aravinth41/AMT/AMT MAGNETOMETER/03_Documents/Lumax_Air gap and Working area_D4.8H3 x-y plane .pptx

- Japan, India Regional Marketing Manager
- Takumi Yoshiya

## Slide 2

Magnet and working area

Condition : 20mT < √(Bx^2+By^2) < 70mT
24mT < Bz < 126mT

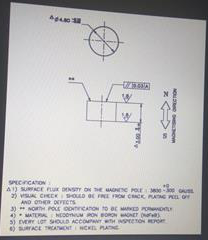
[picture p5: figure]

Working Area(x-y plane)

3.0mm

Magnet

z

4.8mm

y

2.5 ~ 3.0mm

10mmφ

x

## Slide 3

Thank you very much
