aravinth41/AMT/AMT HALL EFFECT/05_Documents/AMT_PCB_26 Jul 2019.pptx

AMT

## POSITIONS IN PCB

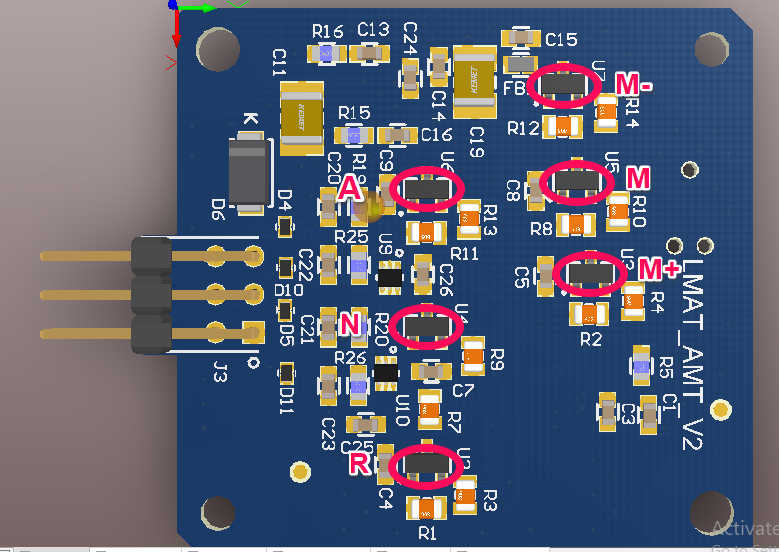
[picture p6: figure]

## CONNECTOR CONNECTIONS

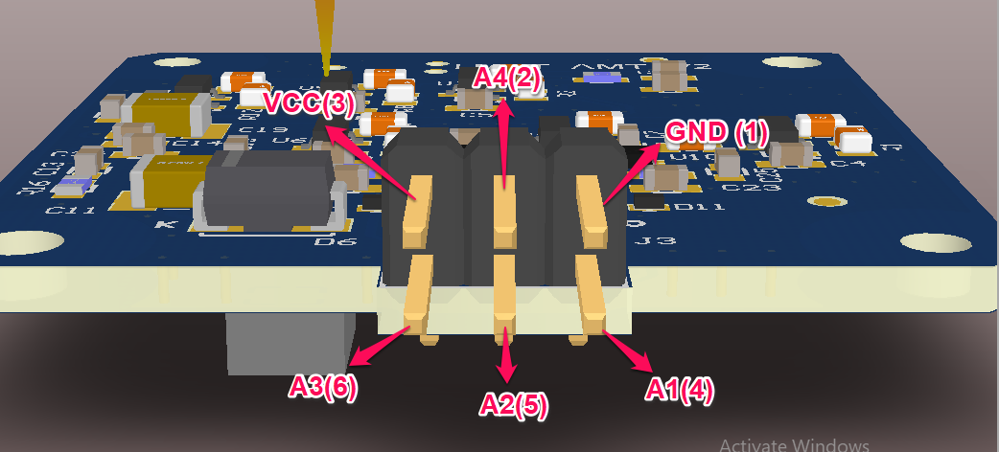
[picture p7: figure]

## Slide 4

THANK YOU
