aravinth41/AMT/AMT HALL EFFECT/05_Documents/AMT_PCB_12 Jul 2019.pptx

AMT

## POSITIONS IN PCB

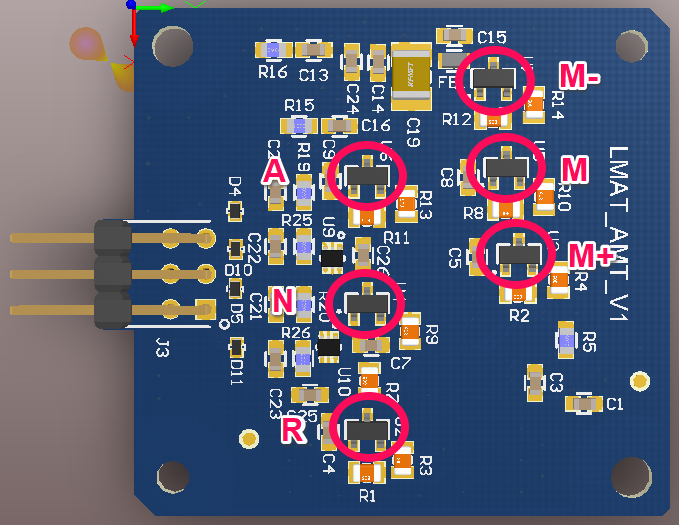
[picture p8: figure]

## CONNECTOR CONNECTIONS

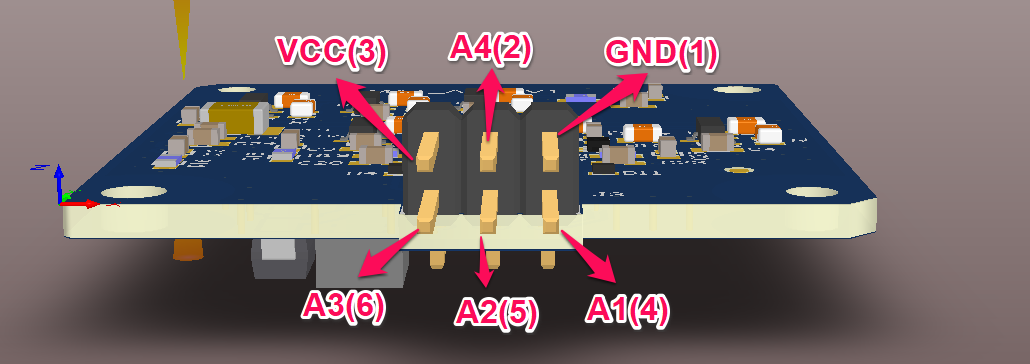
[picture p9: figure]

## Slide 4

THANK YOU
