aravinth41/AMT/AMT HALL EFFECT/05_Documents/AMT_PCB_09 Jul 2019.pptx

AMT

## POSITIONS IN PCB

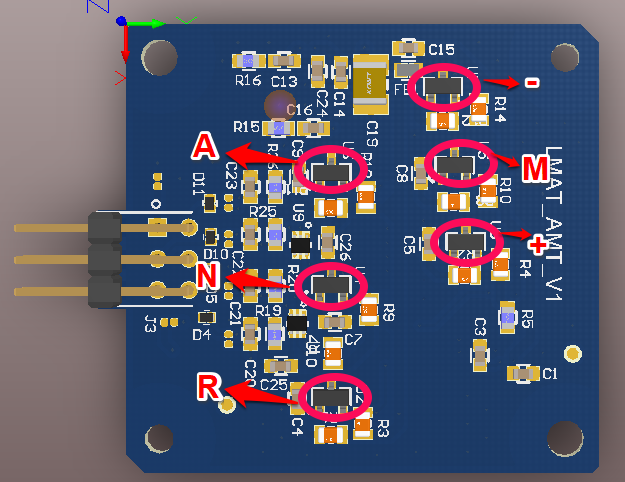
[picture p10: figure]

## PROPOSED CONNECTOR CONNECTIONS

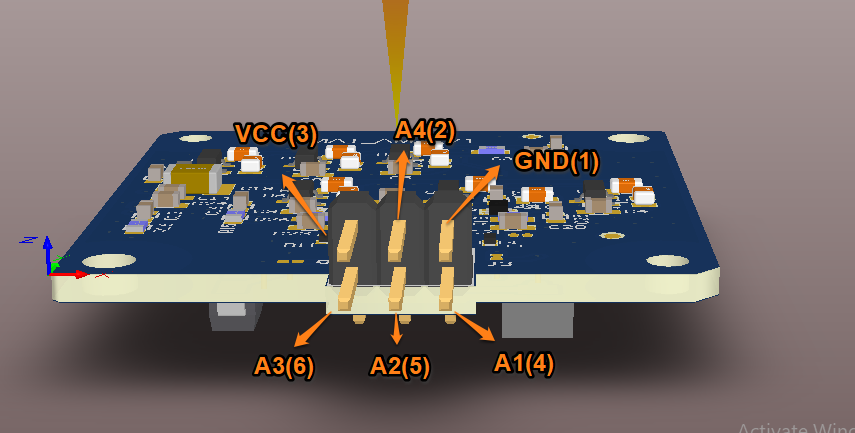
[picture p11: figure]

## CONNECTOR OPEN

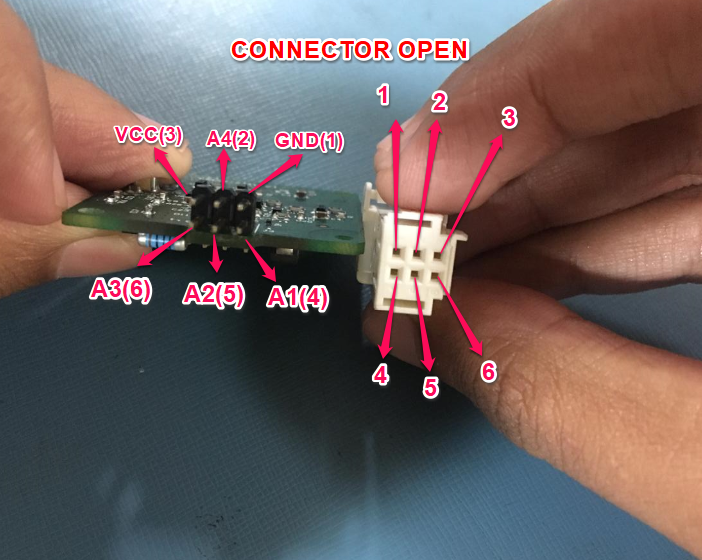
[picture p12: figure]

## CONNECTOR CLOSED

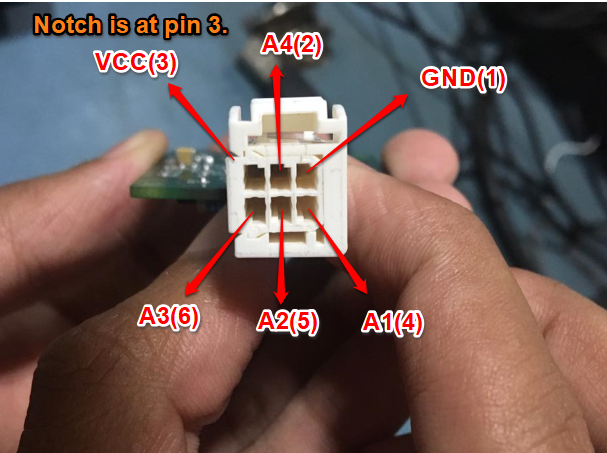
[picture p13: figure]

## Slide 6

THANK YOU
