aravinth41/AMT/AMT HALL EFFECT/05_Documents/AMT_Presentation.pptx

AMT PROJECT

## Slide 2

Proposal 1: Hall Effect sensor

H6

R

MCU

LOGIC
CIRCUITRY

Protection circuitry

Switching
Regulator
(12V to 5V)

A1

CONNECTOR

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
Note: H* are hall effect sensors.

## Hall Effect sensor based AMT

- In this method, we will be using 6 hall effect sensors to determine the positions of gear lever.
- The outputs of hall effect sensors are given to Microcontroller. Based on the inputs received from hall effect sensor, the desired output will be obtained.
- To obtain the desired logic levels at the output, logic circuitry is added.

## Slide 4

Proposal 2: Magnetometer

Magnetometer
M1

R

MCU

LOGIC
CIRCUITRY

Protection circuitry

Switching
Regulator
(12V to 5V)

A1

CONNECTOR

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
## Magnetometer based AMT

- In this project, we will be using 3D magnetometer to determine the positions of the gear lever.
- Magnetometer communicates with microcontroller using SPI protocol.
- Magnetometer sends different data at each position. Based on the data received, the microcontroller will be programmed to give the desired output.
- To obtain the desired logic levels at the output, logic circuitry is added.

## Comparison between HES and Magnetometer

HALL EFFECT SENSOR | MAGNETOMETER
Six Hall effect sensors are used to determine the positions of gear lever. | One magnetometer is enough to determine the positions of gear lever.
Calibration is not required | Calibration is required
Cost of HES PCBA is less compared to MAGNETOMETER PACBA | Cost of magnetometer PCBA is more compared to HES PCBA. (Unit price of sensor is around $5 even if we are going to procure 10000MOQs)

## Slide 7

Thank You
