aravinth41/AMT/AMT HALL EFFECT/01_Project Inputs/Tataside/Hornbill_AMT_shifter_details.pdf

## Hornbill AMT shifter

## New bezel for Hornbill

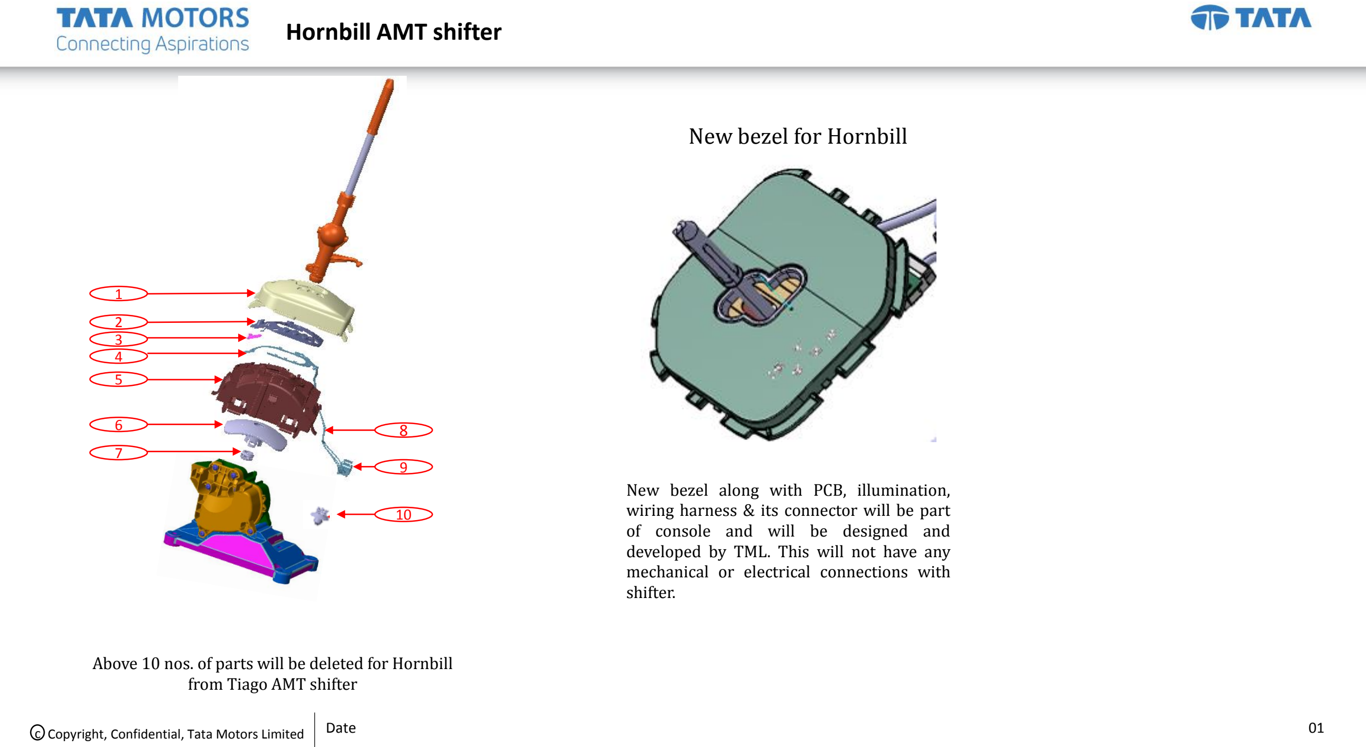
[picture p23: page 1]

c Copyright, Confidential, Tata Motors Limited | Date | 01

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
Above 10 nos. of parts will be deleted for Hornbill from Tiago AMT shifter

New bezel along with PCB, illumination, wiring harness & its connector will be part of console and will be designed and developed by TML. This will not have any mechanical or electrical connections with shifter.
