aravinth41/AMT/AMT HALL EFFECT/01_Project Inputs/LumaxSide/Photos/12.jpg

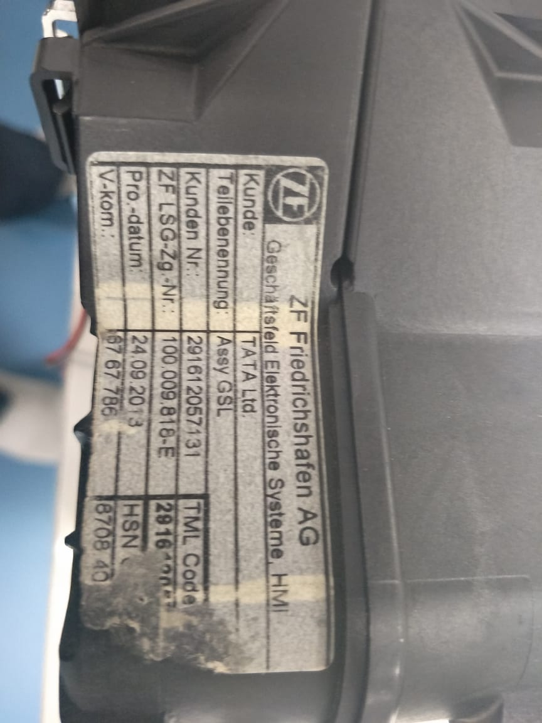
AMT HALL EFFECT/01_Project Inputs/LumaxSide/Photos/12.jpg
