aravinth41/AMT/AMT HALL EFFECT/01_Project Inputs/LumaxSide/Photos/Magnet poles.png

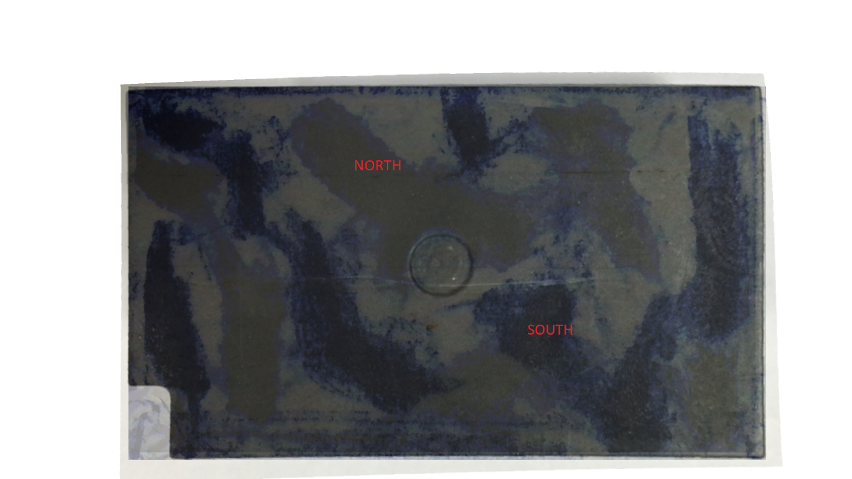
AMT HALL EFFECT/01_Project Inputs/LumaxSide/Photos/Magnet poles.png
