aravinth41/AMT/AMT HALL EFFECT/01_Project Inputs/LumaxSide/BOM_X451.xlsx

BOM FOR SUPPLYING PARTS TO TATA
SUPPLIER NAME : |  | LUMAX MANNOH ALLIED TECHNOLOGIES LTD. |  | CUSTOMER NAME : |  | TATA MOTORS |  |  | PART NAME : |  | LEVER ASSY, SELECT |  | ISSUED DATE : | 08.02.19
SUPPLIER CODE : |  |  |  | CUSTOMER PART NO. : |  | SEE TABLE |  |  | PART NO. : |  |  |  | REV. DATE. : | 15.02.19
VOLUME : |  |  |  | MODEL : |  | X451 |  |  | QUANTITY PER VEHICLE : |  | -01- |  | REV. NO. :
SL. No. | PART NAME /CHILD PART | LMAT PART NO. | TATA PART NO. | PHOTOS | MATERIAL | WEIGHT | QTY. | R/M SOURCE | SUPPLIER | SUPPLY CONDITION PART NAME | SUPPLY CONDITION PART NO. | SUPPLY CONDITION PART PHOTO | REMARKS | CHANGE POINTS
1 | BRACKET, BASE ASSY |  |  |  | TPC+PA66-GF30
1.1 | BRACKET, BASE |  |  |  | PA66-GF30 | 280 | 1 |  |  |  |  |  | MOULDING
1.2 | TOP TPC MOULDING |  |  |  | TPC | 6 | 1 |  |  |  |  |  | MOULDING
1.3 | SIDE TPC MOULDING |  |  |  | TPC | 2 | 1 |  |  |  |  |  | MOULDING
2 | LEVER ROD ASSY_SELECT |  |  |  | PA66-GF30+STKM13C | 55+143 | 1 |  |  |  |  |  | 6 POSITION
2.1 | LEVER MOULDED |  |  |  | PA66-GF30 | 55 | 1 |  |  |  |  |  | 6 POSITION
2.2 | PIPE, LEVER |  |  |  | STKM13C | 143 | 1 |  |  |  |  |  | ID-11, OD-15, L-186 SLOT 4.85x26 & 5.35x26.5 TO BE MACHINED Ø4 DRILLING AT ONE PLACE M4 TAPPING AT TWO PLACES
2.3 | CROSS JOINT |  |  |  | PA66-GF30 | 10 | 1 |  |  |  |  |  | MOULDING
3 | ROD A , LOCK PIN |  |  |  | PA66-GF30 | 12+16 | 1 |  |  |  |  |  | INSERT MOULDING WITH ITEN No. : 3.1
3.1 | ROD B , LOCK PIN |  |  |  | S15C OR SS400 | 16 | 1 |  |  |  |  |  | COMMON WITH W112
4 | SPRING , LOCK PIN |  |  |  | SWPA | 2 | 1 |  |  |  |  |  | NEW
5 | PIN , LOCK |  |  |  | SCM40 | 8 | 1 |  |  |  |  |  | NEW
6 | FIXATION SHAFT |  |  |  | AISI1541 (GR-109T) | 60 | 1 |  |  |  |  |  | COLD FORGING
7 | FIXATION SHAFT_PIVOT |  |  |  | AISI1541 (GR-109T) | 25 | 1 |  |  |  |  |  | COLD FORGING
8 | PUSH NUT Ø8 mm |  |  |  |  | 6 | 2 |  |  |  |  |  | NEW
9 | ROD, DETENT |  |  |  | EN8 (HV650~850) | 6.5 | 2 |  |  |  |  |  | NEW
10 | SPG,COMPRESSION_DETENT |  |  |  | SWPA |  | 1 |  |  |  |  |  | CNC COILNG
11 | SWITCH, TRANSMISSION CONTROL ASSY |  |  |  |  |  | 1 |  |  |  |  |  | NEW
12 | BUSH |  |  |  | CRCA SHEET (THK-1MM) | 5 | 7 |  |  |  |  |  | COMMON WITH W112
13 | SWITCH ASSY., SHIFT LOCK |  |  |  |  |  | 1 |  |  |  |  |  | NEW SWITCH WITH 2Amp OMRON-D2HWC261H
14 | SOLENOID ASSY, SHIFT LOCK |  |  |  |  | 110 | 1 |  |  |  |  |  | NEW
15 | DETENT |  |  |  | PA66, GF30 | 27 | 1 |  |  |  |  |  | NEW
16 | FIXATION SHAFT DETENT |  |  |  | SAE1010 | 10 | 1 |  |  |  |  |  | NEW
17 | NUT, PUSH |  |  |  | SPRING STEEL HARDNESS -42~50HRC | 0.5 | 1 |  |  |  |  |  | COMMON WITH W112
18 | ADAPTER |  |  |  | PA6, GF30 | 350 | 1
19 | NYLOC NUT M8 |  |  |  | AISI 1010 (GR-10T) |  | 3
20 | BOOT ASSY.
20.1 | LEATHER A |  |  |  | SYLPHY (t=0.85~0.9) KOYVA LEATHER | 13
20.2 | LEATHER B |  |  |  | SYLPHY (t=0.85~0.9) KOYVA LEATHER | 13
20.3 | THREAD A
20.4 | THREAD B
20.5 | RETAINER |  |  |  | PP | 18
21 | MAIN PCB ASSY DESCREAT/MICROCONTROLLER |  |  |  |  | 25 |  |  |  |  |  |  | FOR PRND POSITION WITH 8 SENSORS 8MAGNET
22 | PCB ILLUMINATION LED |  |  |  |  | 15 |  |  |  |  |  |  | FOR BEZZLE ILLUMINATION
23 | CONNECTOR MAIN PCB |  |  |  |  |  |  |  |  |  |  |  | 8 PIN CONNECTOR
24 | CONNECTOR ILLU PCB |  |  |  |  |  |  |  |  |  |  |  | 3 PIN
25 | MUL TEMP D |  |  |  |  | 5
26 | MUL TEMP AC-D |  |  |  |  | 5
27 | AUTOLEX-TSK2520G-A-AP01 |  |  |  |  | 2
PREPARED BY: |  |  |  | CHECKED BY: |  |  |  |  | CHECKED BY (PURCHASE): |  |  | CHECKED BY (QUALITY):
APPROVED BY (R&D) : |  |  |  |  |  |  |  |  | APPROVED BY (PLANT HEAD) :
1.THIS IS CONCEPT LEVEL BOM ONLY
1.THIS MAY CHANGE IN FINAL DESIGN
