aravinth41/AMT/AMT HALL EFFECT/05_Documents/FMEA/IFRL_AMT.xlsx

ITEM FUNCTION REQUIREMENT LIST (IFRL)
SUPPLIER NAME : |  | LUMAX MANNOH ALLIED TECHNOLOGIES LTD. |  | CUSTOMER NAME : |  | TATA MOTORS |  |  | DATE : |  | 2019-10-09
SUPPLIER CODE : |  |  |  | PART NAME : |  | SHIFTLEVER MECHANISM |  |  | REV. NO. : |  | 0
 |  |  |  | MODEL : |  | NEXON |  |  | QUANTITY PER VEHICLE : |  | -01-
ITEM | FUNCTION |  | PRIMARY / SECONDARY | CATEGORY | REQUIREMENTS |  | POTENTIAL FAILURE MODE
 |  |  |  |  | HOW MUCH? | WHEN? | NO FUNCTION | UNDER FUNCTION | OVER FUNCTION | INTERMITTENT FUNCTION | DEGRADED FUNCTION | UNINTENDED FUNCTION
1 | Power supply |  |  |  |  |  |  |  |  |  |  |  | Reliability | Reliability
1.1 | To provide the power supply to GSL |  | GENERAL | Power supply | Required voltage: 5V (DC) | Operating voltage: 8 - 16V | Detection of lever position won't happen and desired output will not be obatined. | MCU and HES won't operate if the required voltage goes below 3V. Due to this, GSL doesn't operate and desired output signal cannot be obtained. | MCU gets damaged above 5.5V. Due to this, desired output signal cannot be obtained. | N/A | N/A | N/A
2 | FUNCTIONALITY |  |  |  |  |  |  |  |  |  |  |  | Fluid Retention | NVH
2.1 | To detect the lever position (HES). |  | GENERAL | Communication between MCU and HES. | MCU should detect active low input signal whenever the gear is moved from one position to another. | After Buck conversion and magnet placement above sensor at 1.5mm. | GSL cannot detect the gear positions and achieve the desired output cannot be obtained as per RFQ. | Chances of both HES getting low is possible which may gives as error state when the magnet is placed below 1mm. | HES cannot detect the lever position if the magnet is placed above 2mm from the body of HES. | N/A | Magnet looses its properties over the time and it leads to inoperation of GSL. | N/A | Ergonomics
2.2 | Logic circuitry |  | GENERAL | Logic function | To obtain the required output voltage range as per the EE requirement. | MCU should give desired logic and the output should be connected to TCU with pull up value of 600ohms. | Output voltage cannot be obtained as per EE spec after connecting to TCU. | Due to this, GSL operate at low voltage(3V) and desired output signal cannot be obtained. | MCU gets damaged above 5.5V. Due to this, desired output signal cannot be obtained. | N/A | N/A | When the TCU pull up resistor value changes, the output voltage levels cannot be obtained | Appearance
