aravinth41/AMT/AMT HALL EFFECT/07_TestReport/Rev 3/LMAT_AMT_V3_Test_Report.xlsx

Sheet: Cover page
HARDWARE TEST REPORT
Project Name |  |  | AMT
Device Under Test
Sl. No.
Document Title |  |  | Hardware Test Report
Document No.
Document Revision Number |  |  | Rev 3.0
Execution Summary Page
 | Name of HW Team Members involved in Verification - with responsibilities
S.No | Name |  |  | Responsibility
1 | K.Harshavardhan |  |  | Hardware
2
3
Document Revision History
Rev No. | Date of Issue | Author | Approved by |  | Scope

Sheet: Execution summary
 | Go to Cover page
Link to pages
V.1 | Visualization test | It is first step of Hardware testing.
 |  | Intially it should be cleaned properly with IPA to avoid all the unwanted dust on the board.
 |  | It is follwed by our clear sight on Board to find out the the visible problems, issues or mismatch of com[ponents.
 |  | The procedures are explained in Visualization test page
T.1 | Isolation test | It is Second step of Hardware testing.
 |  | This is used to find the Short circuit in the circuit.
 |  | The procedures are explained in Isolation test page
T.2 | Power test | It is third step of Hardware testing.
 |  | This is used to check the voltage levels
 |  | The procedures are explained in power test page
T.3 | Functionality Test | It is the fourth step of Hardware testing.
 |  | This is used to ensure that the required voltages are obtained by placing the magnet near the Hall effect sensor .
 |  | This step is done once the firmware is updated to Microcontroller.
 | Resource Requirements | The required equipments are listed in this Page

Sheet: Visualization Test
Visulalization Test
Test ID | Test procedure | Test Condition | Observation |  |  |  |  | Result | Remarks on the cause for the failure | Workaround if any done in HW/SW for the same | Failure type | Severity
V.1 |  |  | Sl. No. 1 | Sl. No. 2 | Sl. No. 3 | Sl. No. 4 | Sl. No. 5
V.1.1 | Clean the board and check the visual look on soldering of components | - | Okay | Okay | Okay | Okay | Okay | Pass
V.1.2 | Checking of all Components Placed | Except - C20, C21, C22, C23, C24, FB2, FB7, R30 | Okay | Okay | Okay | Okay | Okay | Pass
V.1.3 | Check the Orientation of IC | From U1 to U10 | Okay | Okay | Okay | Okay | Okay | Pass
V.1.4 | Check the polarity of Diode | D1, D2, D3, D8, D9, D6 | Okay | Okay | Okay | Okay | Okay | Pass

Sheet: Isolation test
Test ID | Test | Sample terminal to test | Test Condition | Observation |  |  |  |  | Pass Criteria | Result | Remarks on the cause for the failure | Workaround if any done in HW/SW for the same | Failure type | Severity
T.1 | ISOLATION |  | Power supply should be in off condition & Multimeter should be in Short test mode. | Sl. No. 1 | Sl. No. 2 | Sl. No. 3 | Sl. No. 4 | Sl. No. 5
T.1.2.1 | VCC | Across C17, C27 |  | Okay | Okay | Okay | Okay | Okay | No short | Pass
T.1.2.2 | VCC_IN | Across C18, C28 |  | Okay | Okay | Okay | Okay | Okay | No short | Pass
T.1.2.3 | VCC_5V | Across C15 |  | Okay | Okay | Okay | Okay | Okay | No short | Pass

Sheet: Power test
Test ID | Test | DESCRIPTION | CONDITION | Sample terminal to test | Test Condition | Observation |  |  |  |  | Pass Criteria | Unit | Result | Remarks on the cause for the failure | Workaround if any done in HW/SW for the same | Failure type | Severity
T.2 | Power |  |  |  |  | Sl. No. 1 | Sl. No. 2 | Sl. No. 3 | Sl. No. 4 | Sl. No. 5
T.2.1 | VCC | To measure power supply | Input power supply is required for the board. Check w.r.t to GND | Across C17, C27 | DC Voltage | 13.39 | 13.39 | 13.39 | 13.4 | 13.4 | To obtain 13.5V | V | Pass
T.2.2 | VCC_IN | To measure power supply | Input power supply is required for the board. Check w.r.t to GND. | Across C18, C28 | DC Voltage | 13.39 | 13.39 | 13.39 | 13.4 | 13.4 | To obtain 13.5V | V | Pass
T.2.3 | VCC_5V | To measure power supply | Input power supply is required for the board. Check w.r.t to GND. | Across C15 | DC Voltage | 5.006 | 4.971 | 4.992 | 4.998 | 4.982 | To obtain 5V | V | Pass

Sheet: Functionality Test
 |  |  | Functionality test
 |  | Desired Truth Table |  |  |  |  |  | Desired Voltage levels
Sl No | Position | A1 | A2 | A3 | A4 |  | Sl No | Logic | Output voltage (V)
 |  |  |  |  |  |  |  |  | Min | Nom | Max
1 | R (U2) | 1 | 0 | 0 | 1 |  | 1 | 0 | 1.5 | 1.88 | 2.25
2 | N (U4) | 1 | 1 | 0 | 0 |  | 2 | 1 | 3.2 | 3.65 | 4.1
3 | A (U6) | 0 | 1 | 1 | 0
4 | M+ (U3) | 0 | 0 | 1 | 1
5 | M (U5) | 1 | 1 | 1 | 1
6 | M- (U7) | 0 | 1 | 0 | 1
Board Number | Magnet position | Voltage levels (V) |  |  |  | Pass Criteria | Result
 |  | A1 | A2 | A3 | A4
1 | R (U2) | 3.517 | 1.992 | 1.992 | 3.512 | To satisfy truth table 1 and 2. (TCU AT 5V) | Pass
 | N (U4) | 3.516 | 3.515 | 1.991 | 1.992 |  | Pass
 | A (U6) | 1.998 | 3.515 | 3.511 | 1.992 |  | Pass
 | M+ (U3) | 1.997 | 1.992 | 3.511 | 3.511 |  | Pass
 | M (U5) | 3.516 | 3.514 | 3.512 | 3.512 |  | Pass
 | M- (U7) | 1.997 | 3.516 | 1.991 | 3.512 |  | Pass
2 | R (U2) | 3.492 | 1.986 | 1.995 | 3.491 | To satisfy truth table 1 and 2. (TCU AT 5V) | Pass
 | N (U4) | 3.493 | 3.49 | 1.996 | 1.989 |  | Pass
 | A (U6) | 1.99 | 3.491 | 3.496 | 1.99 |  | Pass
 | M+ (U3) | 1.99 | 1.986 | 3.497 | 3.494 |  | Pass
 | M (U5) | 3.493 | 3.491 | 3.497 | 3.493 |  | Pass
 | M- (U7) | 1.991 | 3.493 | 1.996 | 3.495 |  | Pass
3 | R (U2) | 3.509 | 1.989 | 1.999 | 3.512 | To satisfy truth table 1 and 2. (TCU AT 5V) | Pass
 | N (U4) | 3.508 | 3.506 | 1.998 | 1.997 |  | Pass
 | A (U6) | 1.996 | 3.505 | 3.51 | 1.998 |  | Pass
 | M+ (U3) | 1.996 | 1.989 | 3.51 | 3.511 |  | Pass
 | M (U5) | 3.509 | 3.506 | 3.51 | 3.512 |  | Pass
 | M- (U7) | 1.996 | 3.507 | 2 | 3.514 |  | Pass
4 | R (U2) | 3.507 | 1.99 | 1.998 | 3.508 | To satisfy truth table 1 and 2. (TCU AT 5V) | Pass
 | N (U4) | 3.508 | 3.506 | 1.999 | 1.993 |  | Pass
 | A (U6) | 1.992 | 3.505 | 3.508 | 1.993 |  | Pass
 | M+ (U3) | 1.992 | 1.99 | 3.511 | 3.51 |  | Pass
 | M (U5) | 3.508 | 3.506 | 3.51 | 3.511 |  | Pass
 | M- (U7) | 1.992 | 3.507 | 2 | 3.512 |  | Pass
5 | R (U2) | 3.498 | 1.989 | 1.996 | 3.506 | To satisfy truth table 1 and 2. (TCU AT 5V) | Pass
 | N (U4) | 3.499 | 3.502 | 1.996 | 1.996 |  | Pass
 | A (U6) | 1.994 | 3.501 | 3.505 | 1.995 |  | Pass
 | M+ (U3) | 1.993 | 1.989 | 3.504 | 3.507 |  | Pass
 | M (U5) | 3.497 | 3.501 | 3.503 | 3.506 |  | Pass
 | M- (U7) | 1.994 | 3.502 | 1.996 | 3.507 |  | Pass

Sheet: Resource _Requirements
 |  | Quantity
Description/Name | Type of Resoure | Workbench Resource | Availability Status | Remark
Digital Multimeter (DMM) | Hardware
Variable DC Power supply (PSU) Atleast 0-12V, 10A | Hardware
Magnet | Hardware
