aravinth41/AMT/AMT HALL EFFECT/06_Stock/LMAT_AMT_V2_Stock.xlsx

Designator | Description | Manufacturer | Manufacturer Part Number | Value | Vendor Name | Vendor Part Number | Quantity | Stock available |  | To Be ordered
R6 | RES SMD 0.0OHM JUMPER 1/10W 0603 | Panasonic Electronic Components | ERJ-3GEY0R00V | 0R | Digi-Key | P0.0GCT-ND | 1 | 15 | 10 | -5
C13 | CAP CER 0.022UF 50V 10% X7R 0603 | TDK Corporation | CGA3E2X7R1H223K080AA | 0.022uF | Digi-Key | 445-5663-1-ND | 1 | 12 | 10 | -2
C4, C5, C7, C8, C9, C10 | CAP CER 0.047UF 50V X7R 0603 | TDK Corporation | CGA3E2X7R1H473K080AA | 0.047µF | Digi-Key | 445-5664-1-ND | 6 | 88 | 60 | -28
C6, C12, C25, C26 | CAP CER 0.1UF 50V 10% X7R 0603 | TDK Corporation | CGA3E2X7R1H104K080AA | 0.1uF | Digi-Key | 445-5666-1-ND | 4 | 50 | 40 | -10
C14, C16 | CAP CER 0.22UF 50V X7R 0603 | Murata Electronics North America | GCJ188R71H224KA01D | 0.22µF | Digi-Key | 490-14410-1-ND | 2 | 38 | 20 | -18
R15 | RES SMD 1M OHM 5% 1/10W 0603 | Vishay Dale | RCA06031M00JNEA | 1M | Digi-Key | 541-2216-1-ND | 1 | 12 | 10 | -2
C2, C3 | CAP CER 1UF 25V X7R 0603 | TDK Corporation | CGA3E1X7R1E105K080AE | 1µF | Digi-Key | 445-173628-1-ND | 2 | 30 | 20 | -10
R3, R4, R9, R10, R13, R14 | RES SMD 1.2K OHM 5% 1/2W 0805 | Panasonic Electronic Components | ERJ-P06J122V | 1.2K | Digi-Key | P1.2KADCT-ND | 6 | 15 | 60 | 45
R29 | RES SMD 4.7K OHM 1% 1/10W 0402 | Panasonic Electronic Components | ERJ-2RKF4701X | 4.7K | Digi-Key | P4.70KLCT-ND | 1 | 0 | 10 | 10
R27, R28 | RES SMD 10K OHM 5% 1/10W 0402 | Panasonic Electronic Components | ERJ-2GEJ103X | 10K | Digi-Key | P10KJCT-ND | 2 | 0 | 20 | 20
C11 | CAP CER 10UF 50V X7R 1210 | Taiyo Yuden | UMJ325KB7106KMHP | 10uF | Digi-Key | 587-6026-1-ND | 1 | 0 | 10 | 10
R16 | RES SMD 22K OHM 1% 1/10W 0603 | Panasonic Electronic Components | ERJ-3EKF2202V | 22K | Digi-Key | P22.0KHCT-ND | 1 | 6 | 10 | 4
R5 | RES SMD 47K OHM 1% 1/10W 0603 | Yageo | AT0603FRE0747KL | 47K | Digi-Key | YAG2129CT-ND | 1 | 25 | 10 | -15
C19 | CAP CER 47UF 16V X6S 1210 | Murata Electronics North America | GRT32EC81C476KE13L | 47uF | Digi-Key | 490-12494-1-ND | 1 | 15 | 10 | -5
L1 | FIXED IND 47UH 700MA 422.5 MOHM | Taiyo Yuden | NRS5030T470MMGJV | 47UH | Digi-Key | 587-3604-1-ND | 1 | 0 | 10 | 10
R1, R2, R7, R8, R11, R12 | RES SMD 100 OHM 1% 1/2W 0805 | Panasonic Electronic Components | ERJ-P06F1000V | 100R | Digi-Key | P16057CT-ND | 6 | 10 | 60 | 50
R17, R18, R23, R24 | RES SMD 105 OHM 1% 1/10W 0603 | Panasonic Electronic Components | ERJ-3EKF1050V | 105 Ohms | Digi-Key | P105HCT-ND | 4 | 60 | 40 | -20
R19, R20, R25, R26 | RES SMD 210 OHM 1% 1/10W 0603 | Panasonic Electronic Components | ERJ-3EKF2100V | 210 Ohms | Digi-Key | P210HCT-ND | 4 | 60 | 40 | -20
FB1 | FERRITE BEAD 600 OHM 0603 1LN | Murata Electronics North America | BLM18KG601SH1D | BLM18KG601SH1D | Digi-Key | 490-13259-1-ND | 1 | 14 | 10 | -4
J3 | CONN HEADER R/A 6POS 2.54MM | Harwin Inc. | M20-9950345 | M20-9950345 | Digi-Key | 952-2092-ND | 1 | 12 | 10 | -2
U9, U10 | MOSFET 2P-CH 20V 0.55A SOT666 | Nexperia USA Inc. | PMDT670UPE,115 | PMDT670UPE,115 | Digi-Key | 1727-1334-1-ND | 2 | 25 | 20 | -5
D2, D3, D8, D9 | Diode Schottky 30V 100mA Surface Mount EMD2 | Rohm Semiconductor | RB501SM-30FHT2R | RB501SM-30FHT2R | Digi-Key | RB501SM-30FHT2RCT-ND | 4 | 40 | 40 | 0
D6 | DIODE GEN PURP 1KV 1A DO214AC | Vishay Semiconductor Diodes Division | S1MHE3_A/I | S1MHE3_A/I | Digi-Key | S1MHE3_A/IGICT-ND | 1 | 13 | 10 | -3
D7 | TVS DIODE 23.1V 48.3V SMB | STMicroelectronics | SM6T27CAY | SM6T27CAY | Digi-Key | 497-10798-1-ND | 1 | 14 | 10 | -4
D1 | DIODE SCHOTTKY 40V 1A DO-219AB | Vishay Semiconductor Diodes Division | SS1FL4HM3/H | SS1FL4HM3/H | Digi-Key | SS1FL4HM3/HGICT-ND | 1 | 11 | 10 | -1
U1 | IC MCU 8BIT 8KB FLASH 20TSSOP | STMicroelectronics | STM8AF6223PCU | STM8AF6223PCU | Digi-Key | 497-17896-ND | 1 | 13 | 10 | -3
D4, D5, D10, D11 | TVS DIODE 8V 20V 2X2DFN | ON Semiconductor | SZESD7410N2T5G | SZESD7410N2T5G | Digi-Key | SZESD7410N2T5GOSCT-ND | 4 | 48 | 40 | -8
U8 | IC REG BUCK 5V 1.8A 8DSO | Infineon Technologies | TLE8366EV50XUMA1 | TLE8366EV50XUMA1 | Digi-Key | TLE8366EV50XUMA1CT-ND | 1 | 10 | 10 | 0
U2, U3, U4, U5, U6, U7 | MAGNETIC SWITCH UNIPOLAR SOT23-3 | Infineon Technologies | TLE49641MXTSA1 | TLE49641MXTSA1 | Digi-Key | TLE49641MXTSA1CT-ND | 6 | 0 | 60 | 60
 |  | DNP COMPONENTS
C1, C15, C18 | CAP CER 0.1UF 50V 10% X7R 0603 | TDK Corporation | CGA3E2X7R1H104K080AA | DNP | Digi-Key | 445-5666-1-ND | 3 |  | 30
C20, C21, C22, C23 | CAP CER 10000PF 50V X8R 0603 | TDK Corporation | CGA3E2X8R1H103K080AA | DNP | Digi-Key | 445-5892-1-ND | 4 |  | 40
C24 | CAP CER 0.022UF 50V 10% X7R 0603 | TDK Corporation | CGA3E2X7R1H223K080AA | DNP | Digi-Key | 445-5663-1-ND | 1 |  | 10
D12, D13, D14, D15 | TVS DIODE 8V 20V 2X2DFN | ON Semiconductor | SZESD7410N2T5G | DNP | Digi-Key | SZESD7410N2T5GOSCT-ND | 4 |  | 40
R30 | RES SMD 4.7K OHM 1% 1/10W 0402 | Panasonic Electronic Components | ERJ-2RKF4701X | DNP | Digi-Key | P4.70KLCT-ND | 1 |  | 10
