aravinth41/AMT/AMT HALL EFFECT/01_Project Inputs/LumaxSide/CDS TATA AMT Original.xlsx

Sheet: Summary
 | Format No. 2922 11 326 A0076- Rev C
 | Component Device Specification (CDS) template
 | Summary:
 | -
1 | Change History | s2
2 | Component Device Specification Status (CDS Status) | s3
3 | Component Device Specification (CDS) | s4

Sheet: Change History
Back to summary
Format No. 2922 11 326 A0076 Rev- C
Component Device Specification - Change History Log
Issue number | Description of change | Date of change | Changed by

Sheet: CDS Status
Back to summary
Format No. 2922 11 326 A0076 - Rev C
Component Device Specification Status (EXAMPLE)
Project Code: | TML PART NO XXXXXXXXXXX
System | Component | Owner | email | CDS Received complete?

Sheet: Component Device Specification
 | Back to summary
 | Format No. 2922 11 326 A0076 Rev-C
 | Component Device Specification (CDS)
 | Component Name: | Connector GSL and Bezzel |  |  |  |  |  |  | Department | Electronics |  | Supplier | LUMAX
 | Part Number | Molex Part No.- 982980002/987871018 |  |  |  |  |  |  | Component owner |  |  | Contact
 | Issue level |  |  |  |  |  |  |  | Phone details |  |  | Phone details
 | System | TATA AMT |  |  |  |  |  |  | email address |  |  | email address
 | STOP! Does the component have a fly lead? If yes, please consider in device Input/Output resistances.
 | STOP! Does the signal is shared with other ECU? If yes, please provide the internal schematic of that pin (upto Micro) to study the H/W interface. Architecture team will notice the shared signals in DFD release.
 | Electrical I/O Matrix
Latest by when the information is required as per EE Technical release gates? | By TG2 | By TG2 | By TG0-2 | By TG0-2 | By TG0-2 | By TG0-2 | By TG2 | By TG2 | By TG0-2 | By TG0-2 | By TG0-2 | By TG0-2 | By TG0-2 | By TG0-2 | By TG0-2 | By TG0-2 | By TG0-2 | By TG0-2 | By TG0-2 | By TG2 | By TG2 | By TG2 | By TG2 | By TG2 | By TG2 | By TG2 | By TG2 | By TG2 | By TG0-2 | By TG2 | By TG2 | By TG2 | By TG2
 | Connector Number | Pin number | Signal Name | Signal Description | Signal type (Select from drop down) | Active Level (Select from options) | Pull up Type (Please specify, see example below) | Pull Down (pl. specify resistance value) | Signal destination (Select from below or provide) | Power supply requirement (Select from below or provide) | Ground Type (Select from below) | Shield or twist requirement | Identify shield or Twisting Grouping (Make groups of different shielded or twisted wires and provide group numbers) | Minimum voltage required at the pin-out of the aggregate to meet all functional requirements | Maximum voltage required at the pin-out to meet all the functional requirements | Nominal operating Current (A) at Voltage (V) | Nominal operating Voltage (V) at Current (A) | Max operating Current (A) at Voltage (V) | Max operating Voltage (V) at Current (A) | Inrush Current (A) at Voltage (V) | Inrush Voltage (V) at Current (A) | Inrush Time (t) at Current (A) and Voltage (V) | Stall Current (A) at Voltage (V) | Stall Voltage (V) at Current (A) | Stall Time (t) at Current (A) and Voltage (V) | Nominal operating Duration (t) | Maximum operating duration (t) | Recommended Wire CSA (sq mm) on wiring harness side | Does the component have a permanent Battery Feed? | If Yes, state the nominal quiescent drain current in its sleep state. | Is there a Pigtail (fly lead) present? | Pigtail (Fly lead) CSA | Pigtail (Fly lead) length
 |  |  |  |  | Analog | High/Low | 12V:Batt | Resistance Value | +VCC / -VCC / Component and I/O | BATT / ACC / IGN / ST / Internal to ECU | General / Dedicated | Shield / Twist | Group number | V | V | A | V | A | V | A | V | t (sec) | A | V | t (sec) | t (sec) | t (sec) | (mm2) | Y/N | mA | Y/N | mm2 | mm
 | MOLEX- 98298-0002 GSL Connector | 1 | Ground | From TCU to GSL PCB | Power | High | 12V:Batt | NA | -VBAT | BATT | General | N/A | N/A | GND | GND | 30mA/6V | 6V/30mA | 52mA/16V | 16/52mA | N/A | N/A | N/A | N/A | N/A | N/A | N/A | N/A | N/A | N/A | N/A | N/A | N/A | N/A
 |  | 2 | Signal 1 | From GSL to TCU | Analog | Analog Voltage | 5V:Internal | NA | GSL Output | TCU | N/A | N/A | N/A | 5V | 5V | 30mA/6V | 6V/30mA | 52mA/16V | 16/52mA | N/A | N/A | N/A | N/A | N/A | N/A | N/A | N/A | N/A | N/A | N/A | N/A | N/A | N/A
 |  | 3 | +V | From TCU to GSL PCB | Power | High | 12V:Batt | NA | +VBAT | BATT | N/A | N/A | N/A | 8V | 16V | 30mA/6V | 6V/30mA | 52mA/16V | 16/52mA | N/A | N/A | N/A | N/A | N/A | N/A | N/A | N/A | N/A | N/A | N/A | N/A | N/A | N/A
 |  | 4 | Signal 2 | From GSL to TCU | Analog | Analog Voltage | 5V:Internal | NA | GSL Output | TCU | N/A | N/A | N/A | 5V | 5V | 30mA/6V | 6V/30mA | 52mA/16V | 16/52mA | N/A | N/A | N/A | N/A | N/A | N/A | N/A | N/A | N/A | N/A | N/A | N/A | N/A | N/A
 |  | 5 | Signal 3 | From GSL to TCU | Analog | Analog Voltage | 5V:Internal | NA | GSL Output | TCU | N/A | N/A | N/A | 5V | 5V | 30mA/6V | 6V/30mA | 52mA/16V | 16/52mA | N/A | N/A | N/A | N/A | N/A | N/A | N/A | N/A | N/A | N/A | N/A | N/A | N/A | N/A
 |  | 6 | Signal 4 | From GSL to TCU | Analog | Analog Voltage | 5V:Internal | NA | GSL Output | TCU | N/A | N/A | N/A | 5V | 5V | 30mA/6V | 6V/30mA | 52mA/16V | 16/52mA | N/A | N/A | N/A | N/A | N/A | N/A | N/A | N/A | N/A | N/A | N/A | N/A | N/A | N/A
 |  |  |  |  |  |  |  |  |  |  |  |  |  |  |  |  |  |  |  |  |  |  |  |  |  |  |  |  |  |  |  | - | -
 | 98787-1018 Bezzel Connector | 1 | Not Used | N/A | N/A | N/A | N/A | N/A | N/A | N/A | N/A | N/A | N/A | N/A | N/A | N/A | N/A | N/A | N/A | N/A | N/A | N/A | N/A | N/A | N/A | N/A | N/A | N/A | N/A | N/A | N/A | N/A | N/A
 |  | 2 | Not Used | N/A | N/A | N/A | N/A | N/A | N/A | N/A | N/A | N/A | N/A | N/A | N/A | N/A | N/A | N/A | N/A | N/A | N/A | N/A | N/A | N/A | N/A | N/A | N/A | N/A | N/A | N/A | N/A | N/A | N/A
 |  | 3 | +V | TCU To GSL | Digital | High | 12V:Batt | N/A | GSL Input | BATT | N/A | N/A | N/A | 8V | 16V | N/A | N/A | N/A | N/A | N/A | N/A | N/A | N/A | N/A | N/A | N/A | N/A | N/A | N/A | N/A | N/A | N/A | N/A
 |  | 4 | Gnd | TCU to GSL | Digital | Low | 12V:Batt | N/A | GSL Input | BATT | General | N/A | N/A | 8V | 16V | N/A | N/A | N/A | N/A | N/A | N/A | N/A | N/A | N/A | N/A | N/A | N/A | N/A | N/A | N/A | N/A | N/A | N/A
 |  | 5 | Output Sports Mode | GSL to TCU | Digital | Low | Gnd | N/A | GSL Output | Internal | N/A | N/A | N/A | 8V | 16V | N/A | N/A | N/A | N/A | N/A | N/A | N/A | N/A | N/A | N/A | N/A | N/A | N/A | N/A | N/A | N/A | N/A | N/A
 |  | 6 | Not Used | N/A | N/A | N/A | N/A | N/A | N/A | N/A | N/A | N/A | N/A | N/A | N/A | N/A | N/A | N/A | N/A | N/A | N/A | N/A | N/A | N/A | N/A | N/A | N/A | N/A | N/A | N/A | N/A | N/A | N/A
 | Pin Number | Terminal Plating | Signal Name
 |  | 5
 | 1 | Ground | From TCU to GSL PCB | Power | High | 12V:Batt | 12V:Batt | NA
 | 2 | Signal 1 | From GSL to TCU | Analog | Analog Voltage | 5V:Internal | 5V:Internal | NA
 | 3 | +V | From TCU to GSL PCB | Power | High | 12V:Batt | 12V:Batt | NA
 | 4 | Signal 2 | From GSL to TCU | Analog | Analog Voltage | 5V:Internal | 5V:Internal | NA
 | 5 | Signal 3 | From GSL to TCU | Analog | Analog Voltage | 5V:Internal | 5V:Internal | NA
 | 6 | Signal 4 | From GSL to TCU | Analog | Analog Voltage | 5V:Internal | 5V:Internal | NA
 | 1 | Not Used | N/A | N/A | N/A | N/A | N/A | N/A
 | 2 | Not Used | N/A | N/A | N/A | N/A | N/A | N/A
 | 3 | +V | TCU To GSL | Digital | High | 12V:Batt | 12V:Batt | N/A
 | 4 | Gnd | TCU to GSL | Digital | Low | 12V:Batt | 12V:Batt | N/A
 | 5 | Output Sports Mode | GSL to TCU | Digital | Low | Gnd | Gnd | N/A
 | 6 | Not Used | N/A | N/A | N/A | N/A | N/A | N/A
 | Harness Connector | Information Required by TG2
 | Connector - TATA Part Number: |  |  |  |  |  |  |  | Connector end view - showing the cable entry pin-out
 | Connector - Supplier Part Number:
 | Pin Number | Terminal Plating | Signal Name
 | TG0-2 | Information to be filled before supplier finalization
 | TG2 | Information to be filled after supplier finalization
