aravinth41/AMT/AMT HALL EFFECT/01_Project Inputs/LumaxSide/PCB AMT 27 APR 2019.dxf

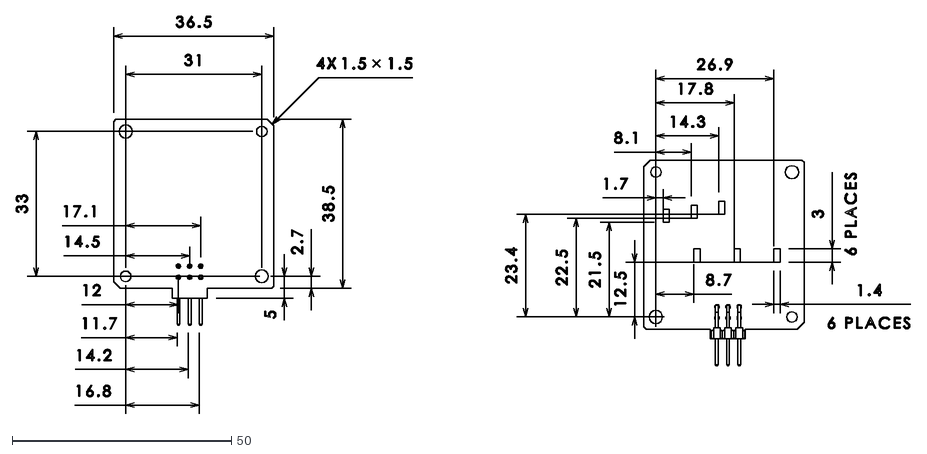
[picture p35: CAD file, 2019-06-26]
AMT HALL EFFECT/01_Project Inputs/LumaxSide/PCB AMT 27 APR 2019.dxf
203.9 x 90.7
