aravinth41/AMT/AMT HALL EFFECT/01_Project Inputs/LumaxSide/AMT_PCB_25 JUNE 2019.dxf

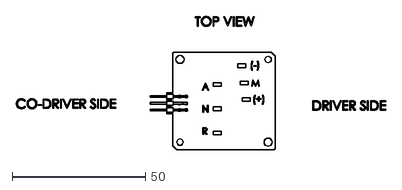
[picture p36: CAD file, 2019-06-25]
AMT HALL EFFECT/01_Project Inputs/LumaxSide/AMT_PCB_25 JUNE 2019.dxf
138.3 x 49.9
