aravinth41/AMT/AMT HALL EFFECT/04_Project Outputs/Rev 1/04_3D Model/AMT_HALL_EFFECT.step

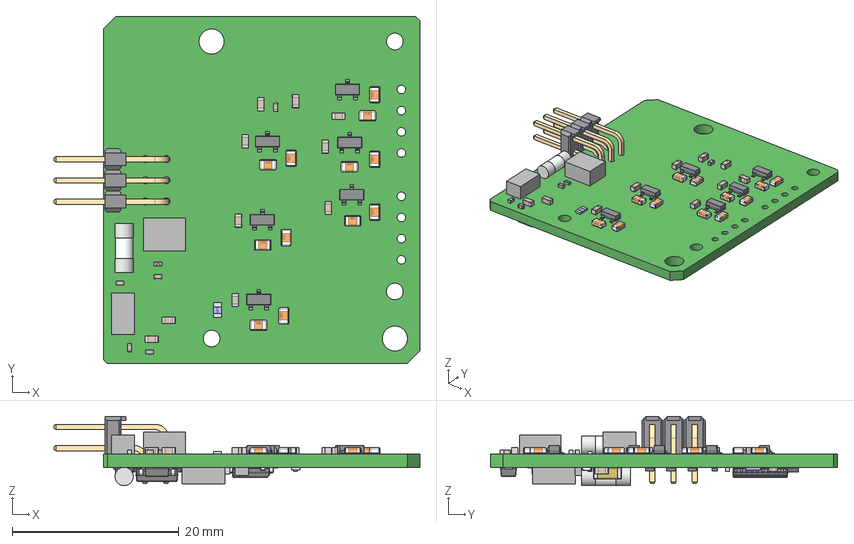
[picture p37: CAD file, 2019-06-26, an earlier design]
AMT HALL EFFECT/04_Project Outputs/Rev 1/04_3D Model/AMT_HALL_EFFECT.step
43.9 x 41.7 x 8.32 mm
Board
bigPin x 8
SOT666_Lower_mold_body x 2
SOT666_LF x 2
SOT666_upper_mold_body x 2
Extruded x 4
User_Library-RESC1005X04N x 10
User_Library-SMD_CAPACITOR0402 x 11
Open_CASCADE_STEP_translator_6.8_2.1
Open_CASCADE_STEP_translator_6.8_2.2.1
Leader x 28
Open_CASCADE_STEP_translator_6.8_10.1
Open_CASCADE_STEP_translator_6.8_10.2.1
User_Library-SOD-523F x 4
Open_CASCADE_STEP_translator_6.8_6.1.1
lead x 2
C0603 x 11
SW3dPS-3-lead_sot23-3 x 6
M20-995-MOULD
M20-995-PIN1 x 3
M20-995-PIN2 x 3
