aravinth41/AMT/AMT HALL EFFECT/05_Documents/FMEA/BOUNDARY_DIAGRAM_AMT.xlsx

Sheet: BD_AMT
BOUNDARY DIAGRAM - TATA AMT NEXON | Prepared By | Ekta Bhayana
 | Date | 2019-10-09
 | Arrow | Interface
 |  | Power line
 |  | Data transfer
 |  | Physical Interface and External input
 |  | FMEA Boundary
 |  | Magnet

Sheet: BD_AMT_2
 |  |  |  |  | BOUNDARY DIAGRAM - TATA AMT NEXON |  |  |  | Prepared By | Ekta Bhayana
 |  |  |  |  |  |  |  |  | Date | 2019-10-09
 |  |  |  |  |  | Arrow | Interface
 |  |  |  |  |  |  | Power line | Note: All interfaces mentioned in Tabular column are One way interaction.
 |  |  |  |  |  |  | Data transfer
 |  |  |  |  |  |  | Physical Interface and External input
 |  |  |  |  |  |  | FMEA Boundary
 |  |  |  |  |  |  | Magnet
INTERACTIONS
Physical |  | Energy |  | Information |  | Material
MT | Tape Application | A | Acceleration | Bt | Bluetooth | Ar | Air
BlJt | Ball Joint | Af | Adhesion force | CmP | Cam Position | Bm | Belt Material
BoJt | Banjo Joint | Bo | Buoyancy | CAN | CAN Signal | Bg | Blow-by gas
Br | Bearing | Cq | Charge | CrP | Crank Position | Bf | Brake Fluid
Be | Belted | Cf | Compression Force | DI | Digital input | Ca | Charged Air
B | Bolted | Ef | Electric Field | Ifr | Information | Clt | Coolant
BhJt | Bush Joint | I | Electrical Current | Ir | Infrared | D | Dust
BuCl | Button Clip | E | EMI - EMC | P | Pulse | Eo | Engine Oil
C | As Cast | F | Force | Rf | Radio Frequency Signal | Eg | Exhaust Gas
Ch | chained | Fr | Friction | Ss | Sensor Signal | Fe | Fuel
Cl | Clamped | H | Heat | Sg | Signal | Fv | Fuel Vapour
Clr | Clearance | Ld | Load | FbS | Feed back sound | Gs | Gas
ClJt | Clip Joint | Mf | Magnetic Field | N | Noise | Glc | Glide coating
CdFt | Cold fitting | Mn | Moment |  |  | Grs | Grease
Co | Coupling | Pr | Pressure |  |  | Lo | Lub Oil
Cr | Crimped | PrD | Pressure Drop |  |  | Mst | Moisture
Dw | Doweled | Tre | Retained torque |  |  | O | Oil
En | Engagement | Ero | Rotational Energy |  |  | Ov | Oil Vapour
Fc | Face Contact | Sp | Spark |  |  | RTP | RPM And TDC Position
FJt | Ferrul Joint | T | Temperature |  |  | Slt | Salt
Wf | Friction Welded | Tn | Tension |  |  | Sl | Sealant
Gm | Gear Meshing | ThS | Thermal Shock |  |  | Wt | Water
Gp | Gear Pairing | Tr | Torque |  |  | Wr | Wear
Gl | Glued | Vm | Vacuum
Gr | Grommeting | Vi | Vibration
Gc | Guided Contact | Vo | Voltage
Hg | Hanged | Wa | Wave Action
Hm | Hemming
Hn | Hinged
Ht | Hitch
Ho | Hook
ImJt | Injection Molded joint
In | Inserted
InFt | Interference fit
Lct | Line contact
LnJt | Linked joint
Lr | Located Resting
L | Locking
Lp | Locking Pin
Ms | Meshing
Ohc | old ham coupling
Pst | Pasted
Pt | Customer touch Point
PJt | Pin Joint
Pl | Placed
Po | Position
Pld | Pre load
PrFt | Press Fit
WPr | Projection welded
QfC | Quick Fix Connector
Rt | Riveting
RlC | Rolling Contact
Rs | Rubber Sealing
Sr | Screwed
Sa | Sealant application
SJt | Sealed Joint
SeFt | Serration Fit
SlC | Sliding Contact
SnFt | Snap Fit
Sld | Soldering
SpD | Spiral Dowel
WSp | Spot welded
SpBCl | Spr Band Clamp
SpCo | Spring Coupled
SpL | Spring Loaded
Sc | Stitching
Sct | Surface contact
Tf | thrust facing
TrFt | Transition Fit
Wus | Ultra sonic welded
Wk | Wudroff key
