aravinth41/AMT/AMT HALL EFFECT/05_Documents/FMEA/PST _AMT.xlsx

PRODUCT STRUCTURE SHEET: DFMEA
AMT Gear Shift Lever | Subsystem | Key Date | 25.09.19 | Prepared By | Ekta Bhayana
Selector lever assy | Component |  |  | FMEA Date | 25.09.19
Model Year(s)/Program(s) | NEXON AMT |  |  | REV. Date
Core Team | Mr. Siddharth, Mr. Lokesh , |  |  | REV. No. | 1
 | Mr. Shailendra Kumar, Mr. Hari shankar |  |  | REV. Details
