aravinth41/AMT/AMT HALL EFFECT/05_Documents/FMEA/PARAMETER DIAGRAM_AMT.xls

 | DFMEA - Q5 |  | PART NAME: AMT_PCB |  | LUMAX MANNOH ALLIED TECHNOLOGIED LTD. | DATE
 | PARAMETRIC DIAGRAM |  | PART NO.: |  | ENGINEERING DEPARTMENT | 09.10.2019
PREPARED BY : |  | CHECKED BY : |  | APPROVED BY : |  | SHEET 1 OF 1
