aravinth41/AMT/AMT HALL EFFECT/03_PDF/Rev 3/LMAT_AMT_V3.pdf

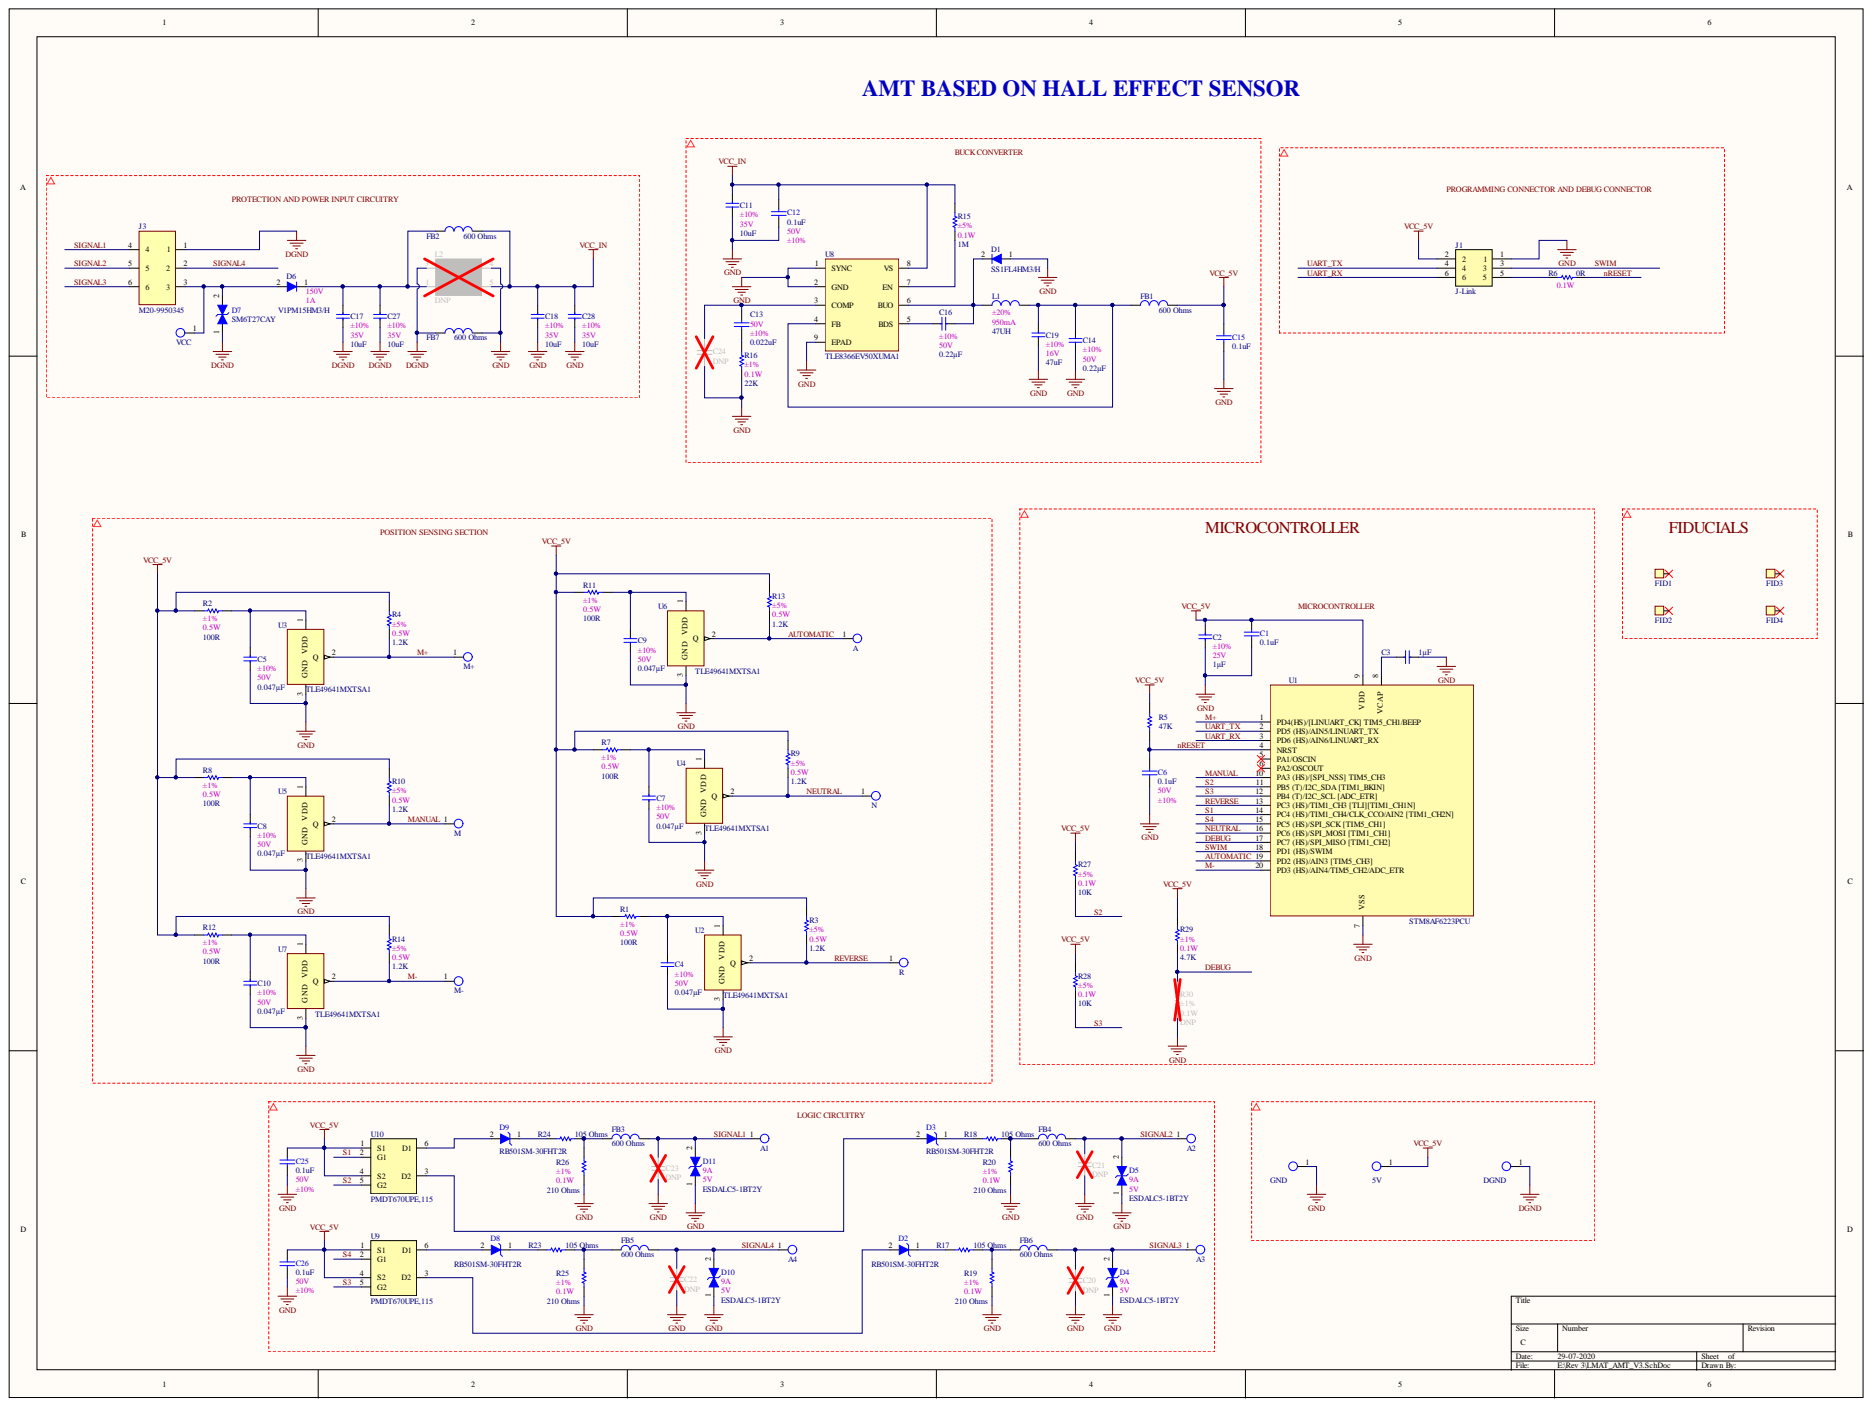
[picture p38: page 1]

AMT BASED ON HALL EFFECT SENSOR

PROTECTION AND POWER INPUT CIRCUITRY

PROGRAMMING CONNECTOR AND DEBUG CONNECTOR
