aravinth41/AMT/AMT HALL EFFECT/04_Project Outputs/Rev 4/02_Assembly/LMAT_AMT_V4.PDF

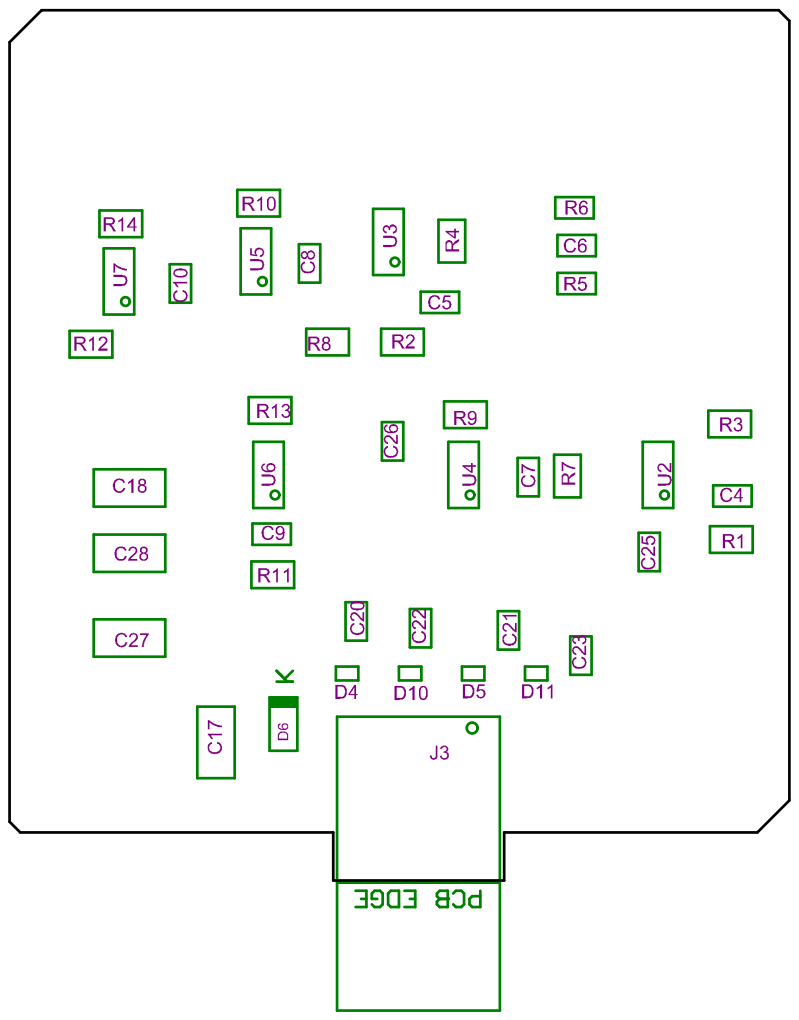
[picture p39: page 1]

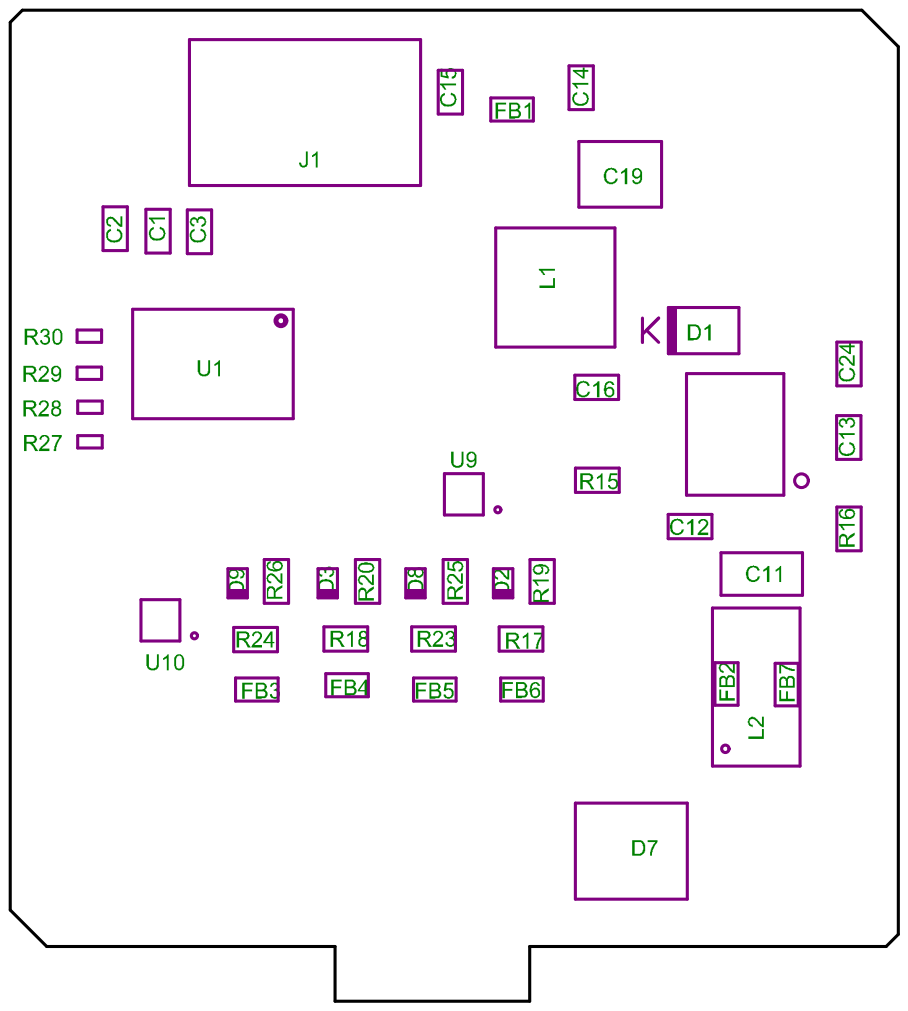
[picture p40: page 2]
