aravinth41/AMT/AMT HALL EFFECT/04_Project Outputs/Rev 4/03_PDF/PCB 3D Print - Bottom.PDF

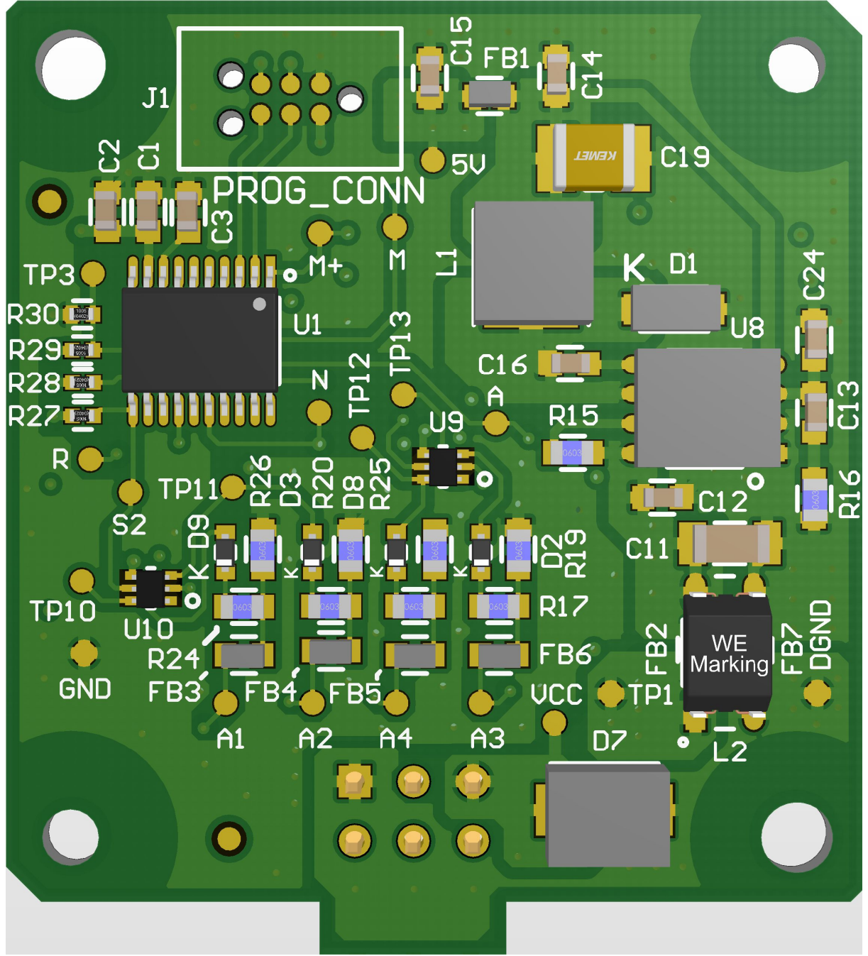
[picture p42: page 1]
