aravinth41/AMT/AMT HALL EFFECT/04_Project Outputs/Rev 4/03_PDF/PCB 3D Print - Top.PDF

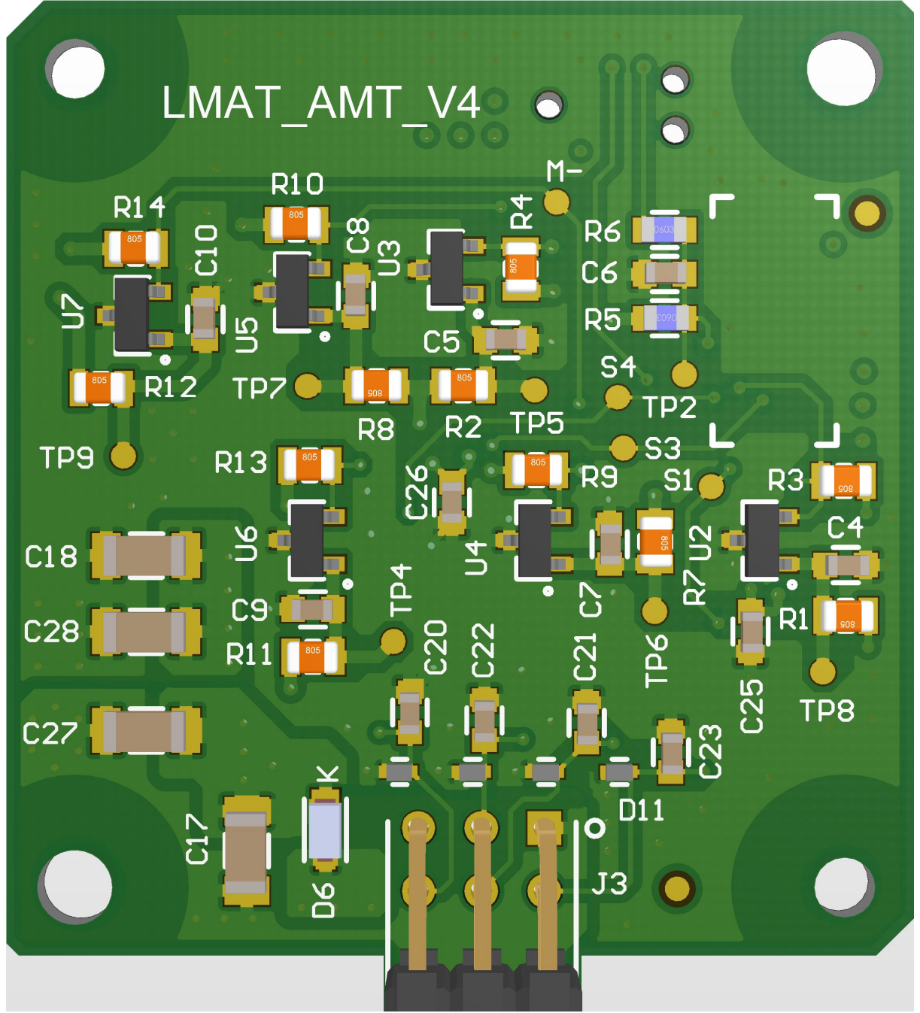
[picture p43: page 1]
