aravinth41/AMT/AMT MAGNETOMETER/02_PDF/LMAT_AMT_MAG_V1.pdf

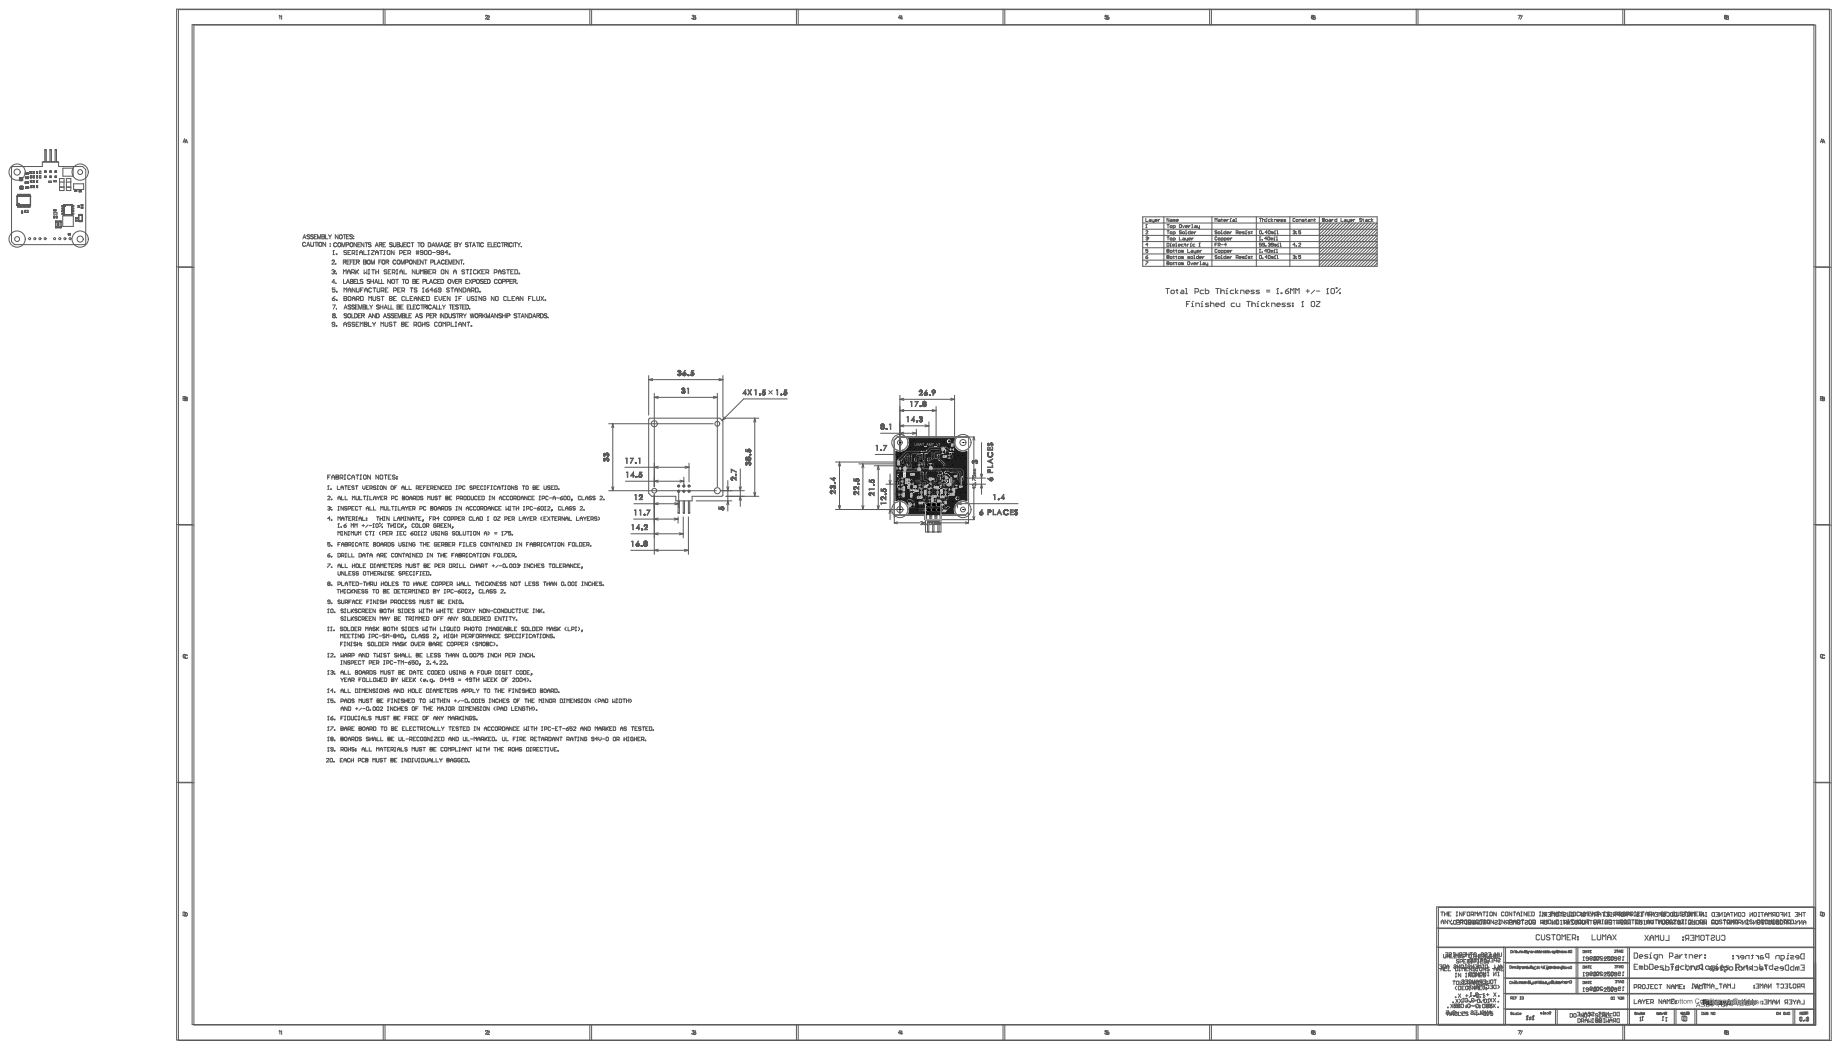
[picture p52: page 1]
