aravinth41/AMT/AMT HALL EFFECT/04_Project Outputs/Rev 4/03_PDF/FAB_DWG.PDF

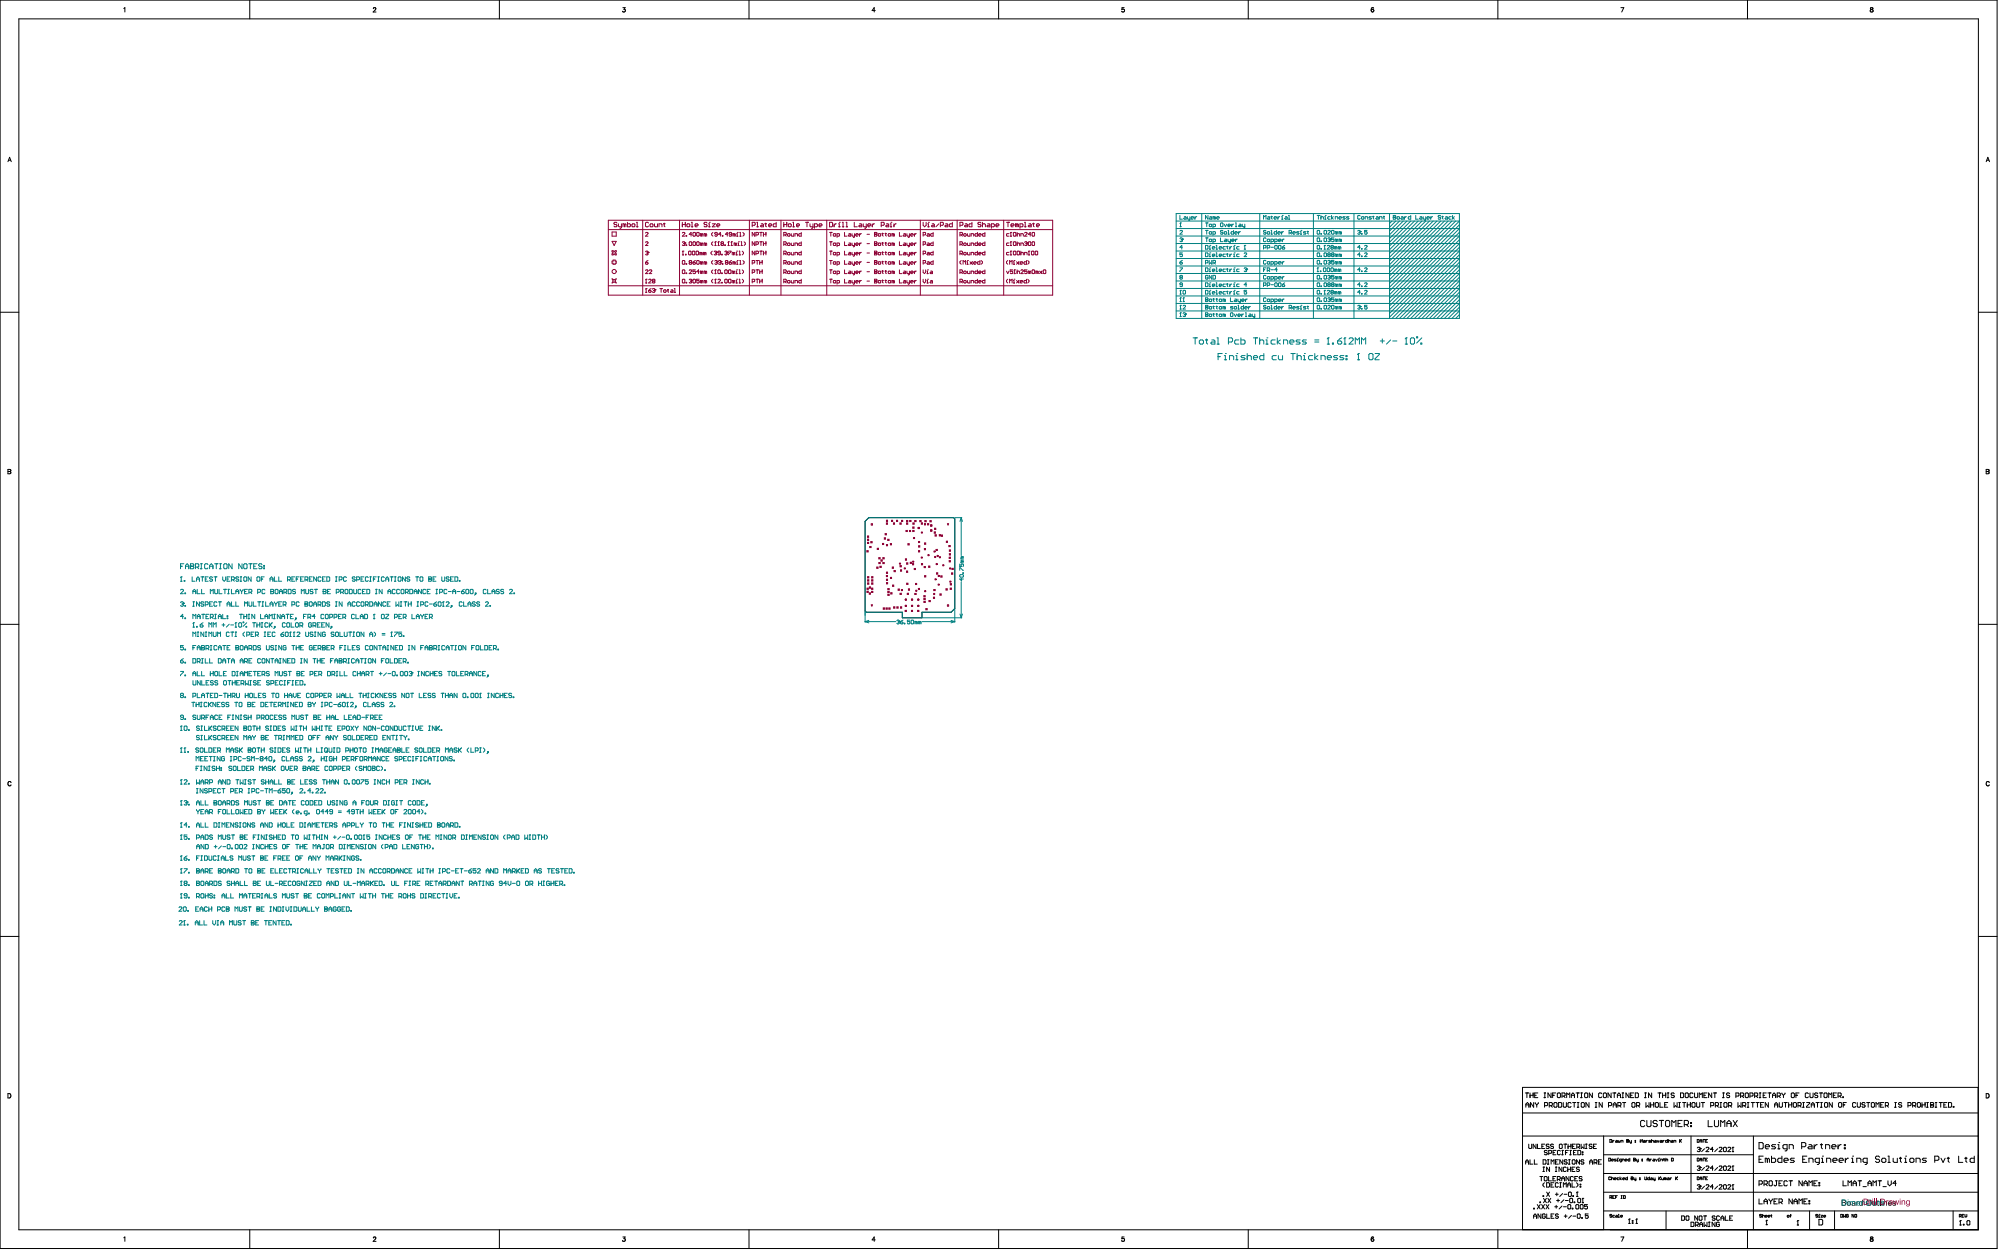
[picture p53: page 1]

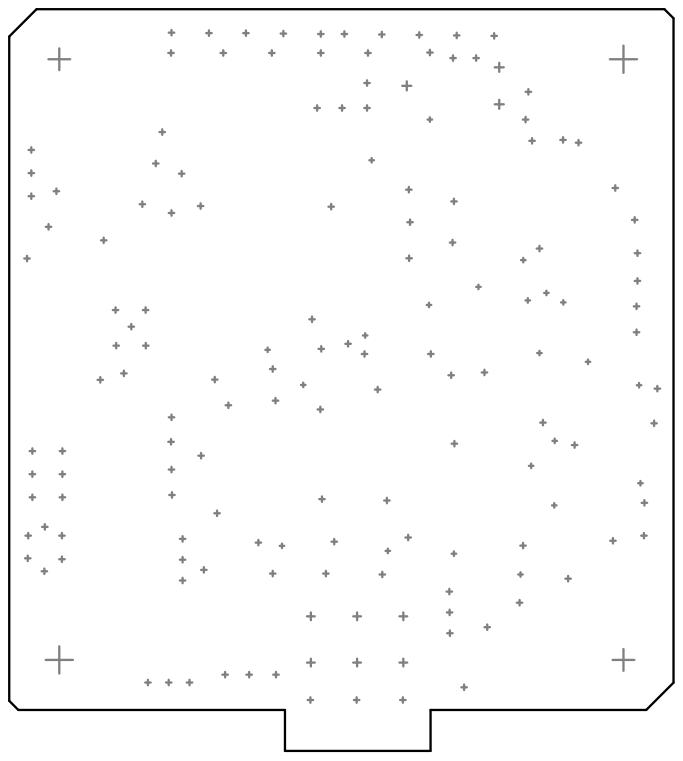
[picture p54: page 2]
