aravinth41/AMT/AMT HALL EFFECT/03_PDF/Rev 2/LMAT_AMT_V2.pdf

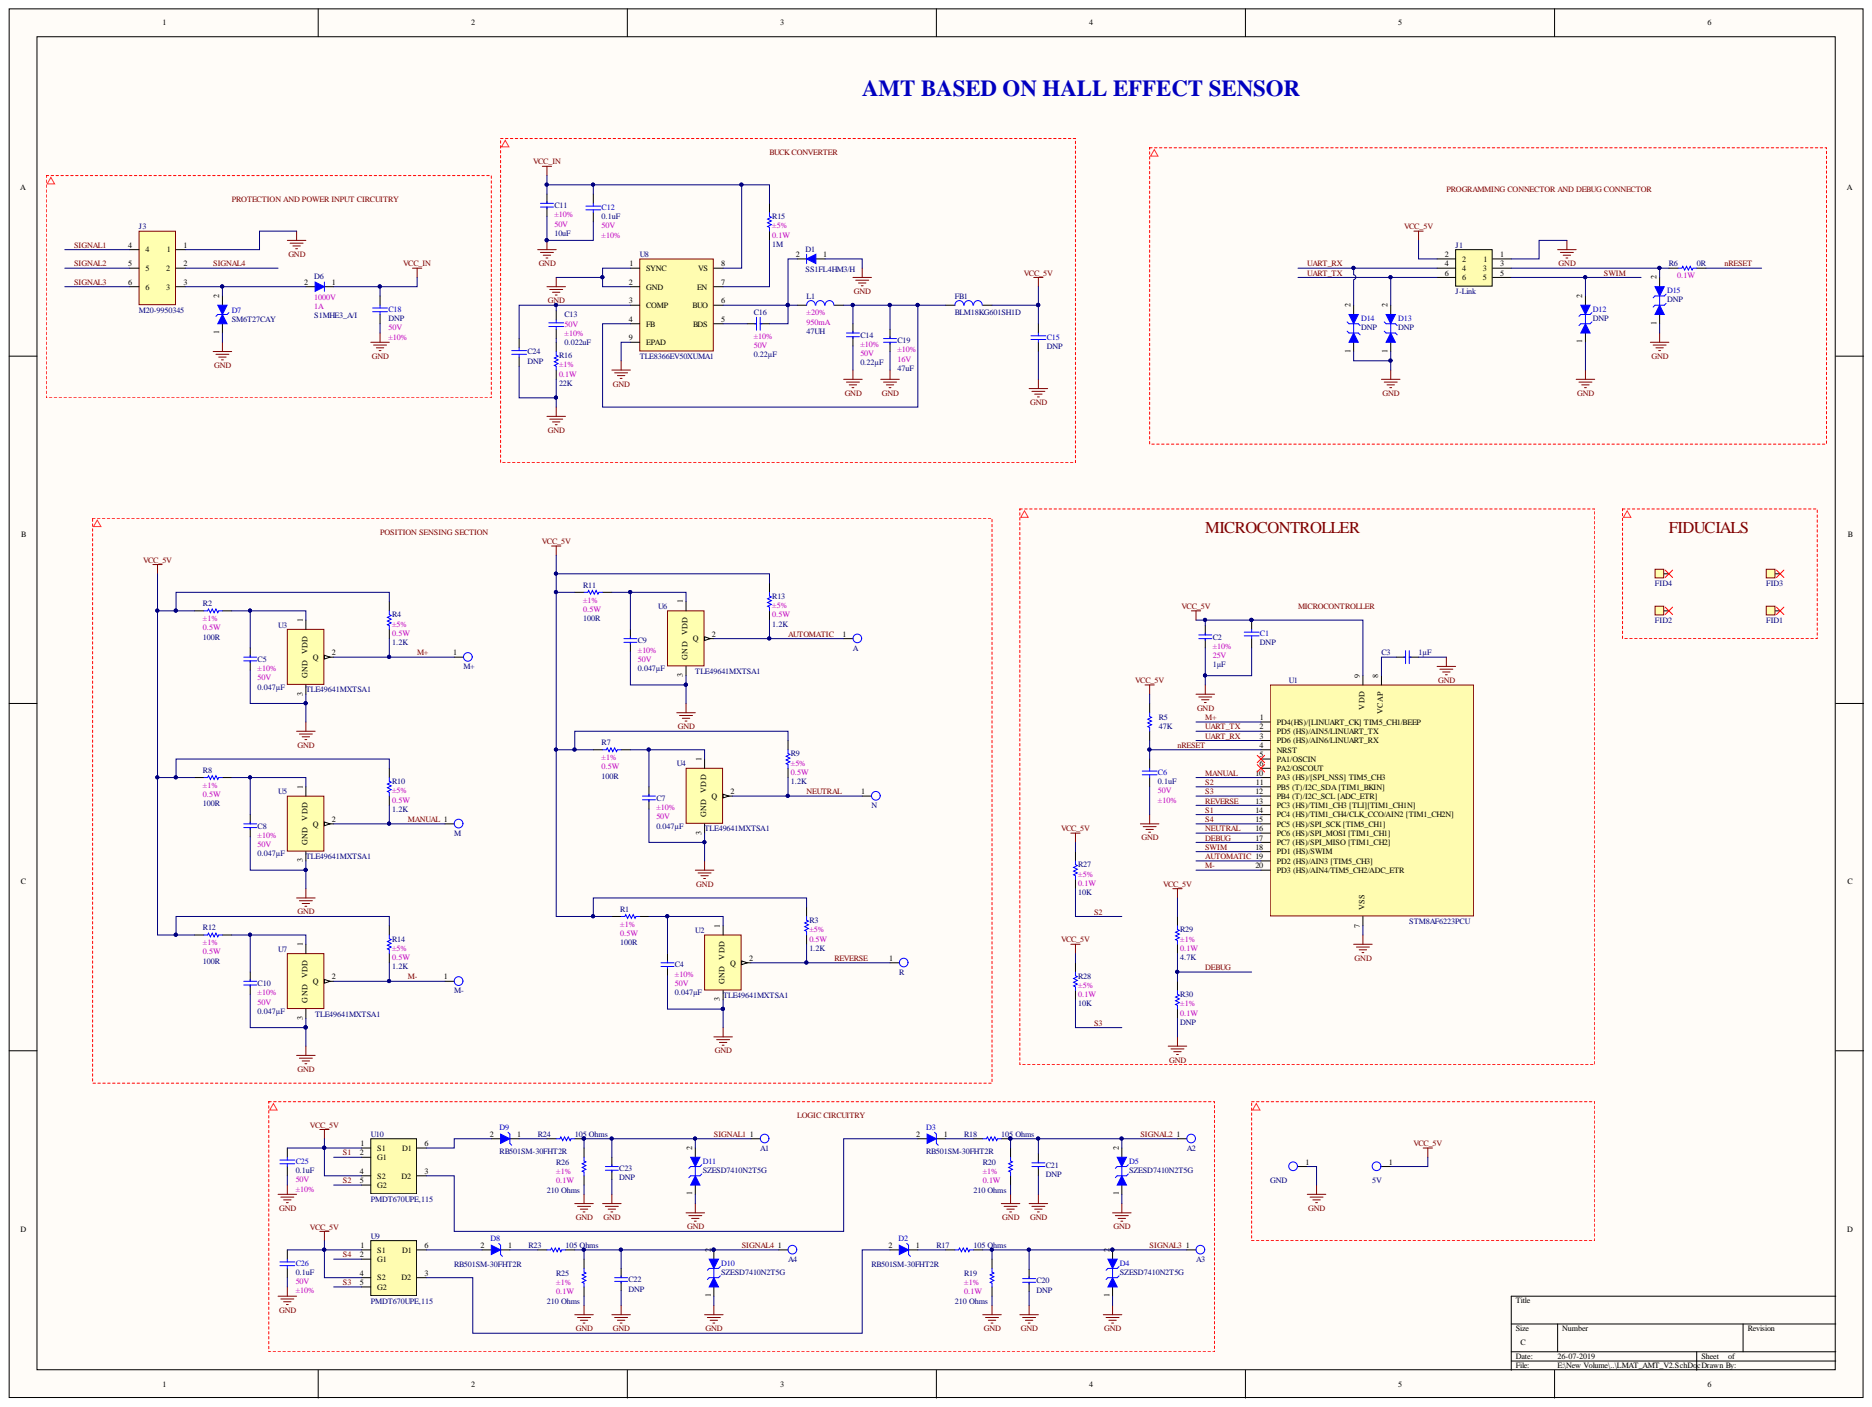
[picture p55: page 1]

AMT BASED ON HALL EFFECT SENSOR

PROTECTION AND POWER INPUT CIRCUITRY

PROGRAMMING CONNECTOR AND DEBUG CONNECTOR
