aravinth41/AMT/AMT HALL EFFECT/03_PDF/Rev 1/LMAT_AMT_V1.pdf

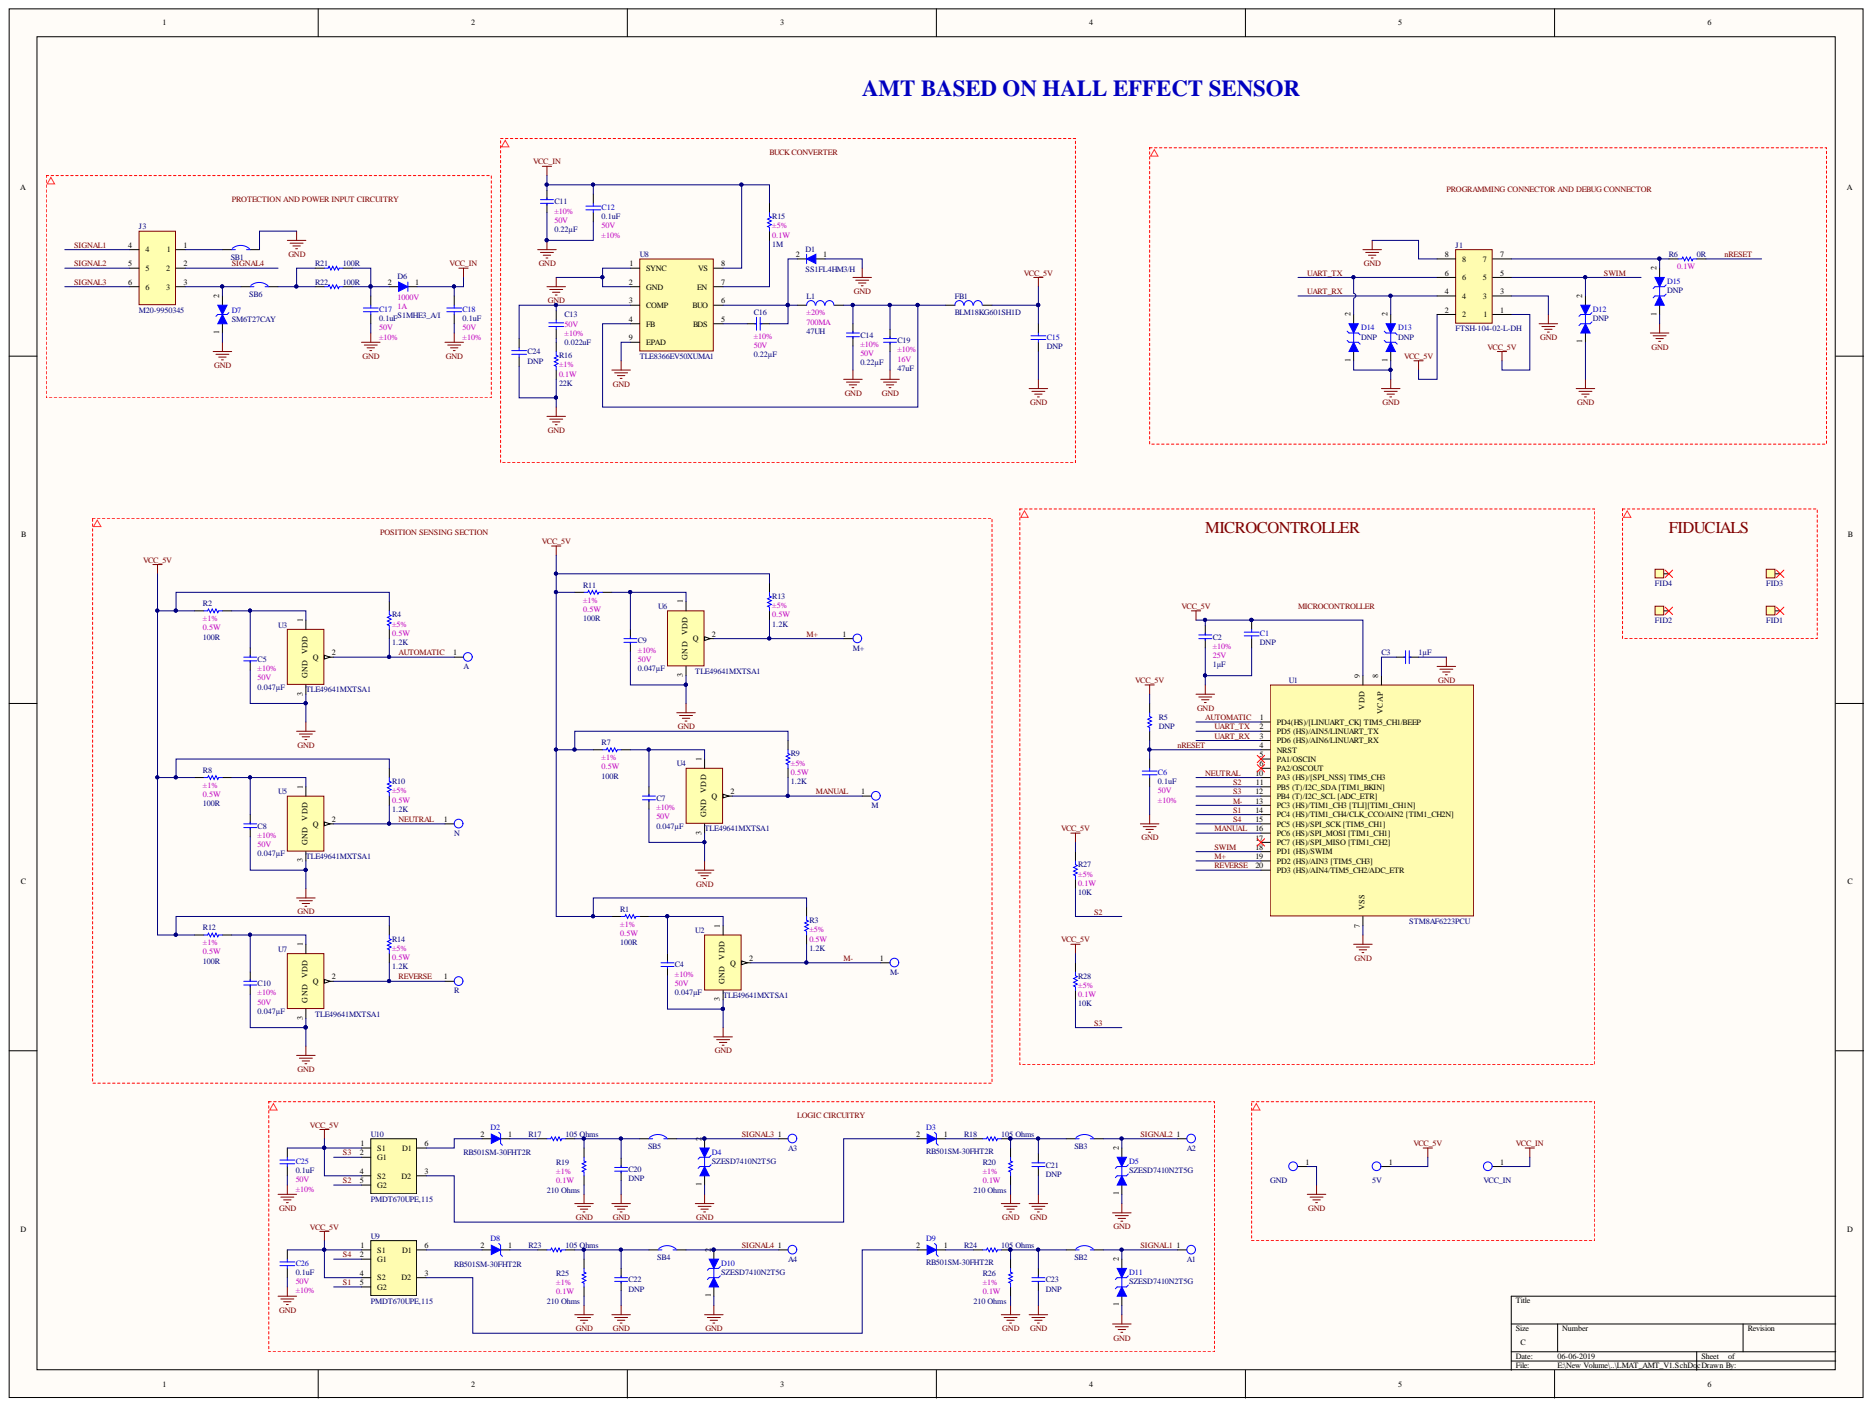
[picture p56: page 1]

AMT BASED ON HALL EFFECT SENSOR

PROTECTION AND POWER INPUT CIRCUITRY

PROGRAMMING CONNECTOR AND DEBUG CONNECTOR
