aravinth41/AMT/AMT HALL EFFECT/04_Project Outputs/Rev 3/03_PDF/LMAT_AMT_V3_Assembly_Drawing.PDF

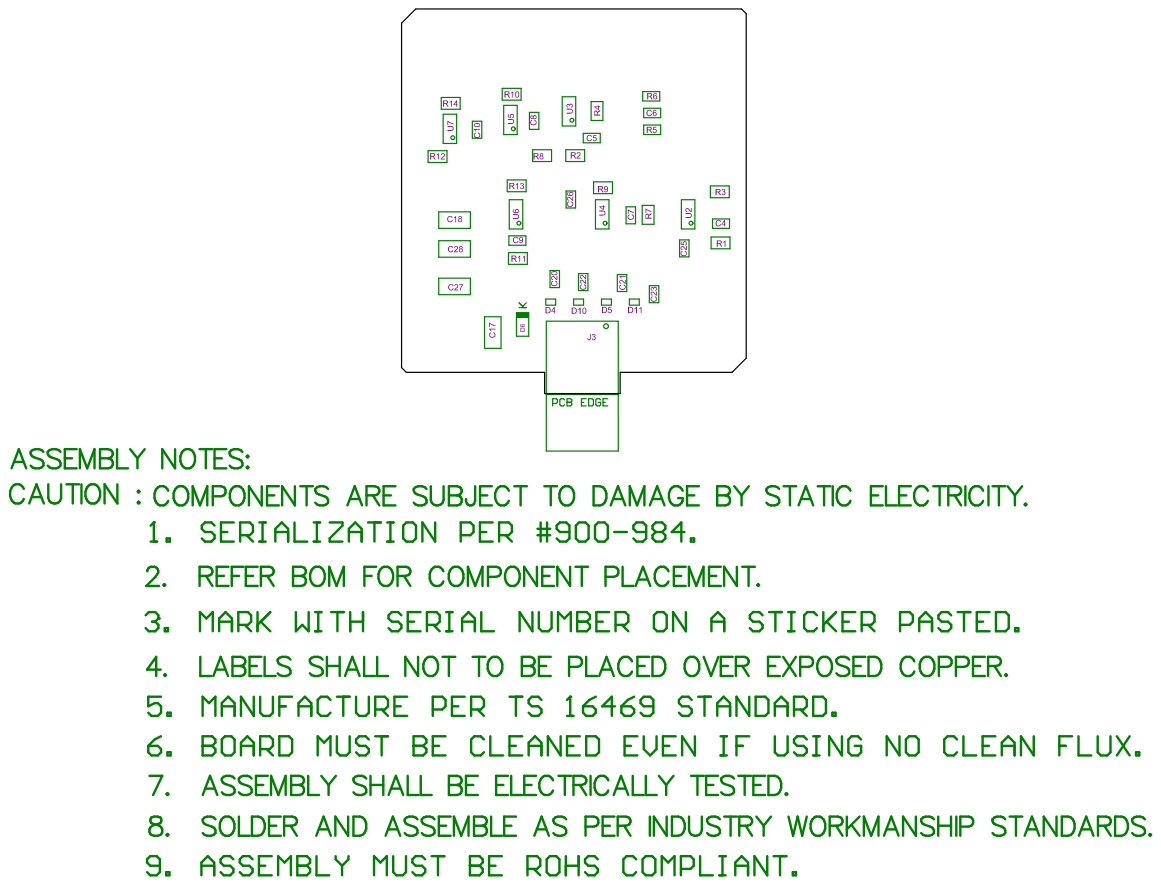
[picture p57: page 1]

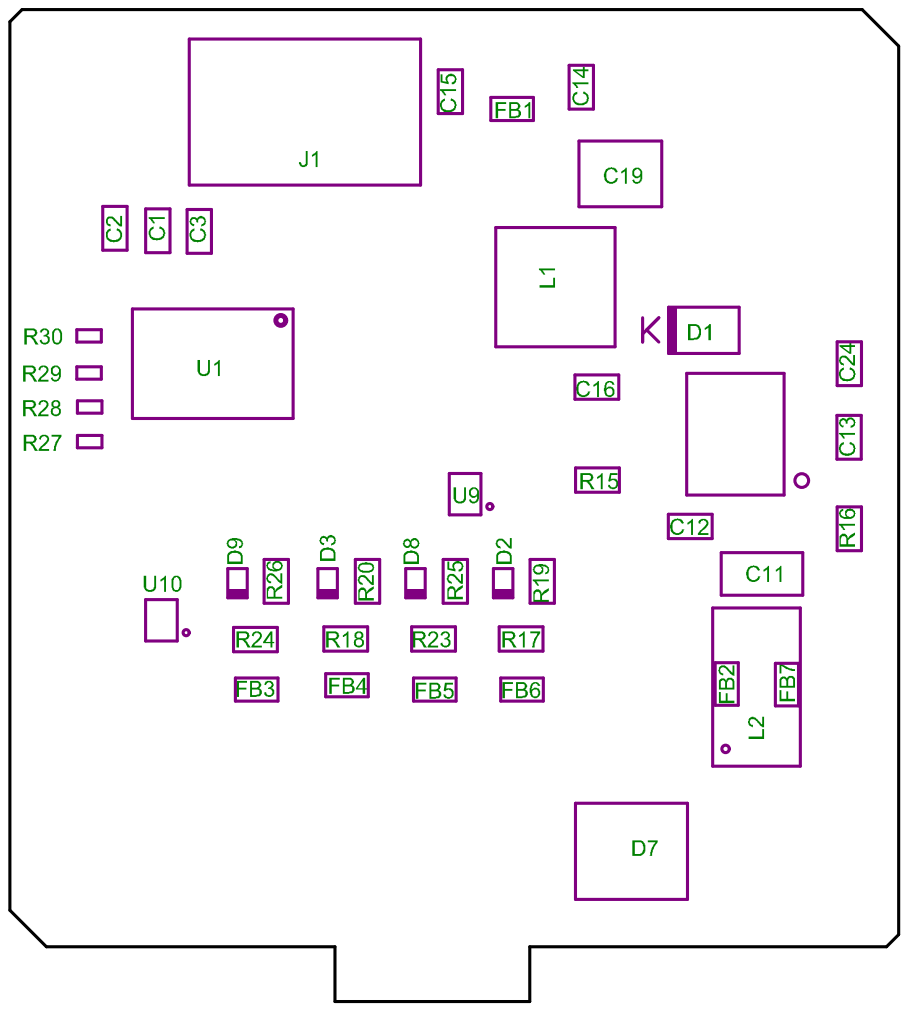
[picture p58: page 2]
