aravinth41/AMT/AMT HALL EFFECT/04_Project Outputs/Rev 3/03_PDF/PCB 3D Print - Angle.PDF

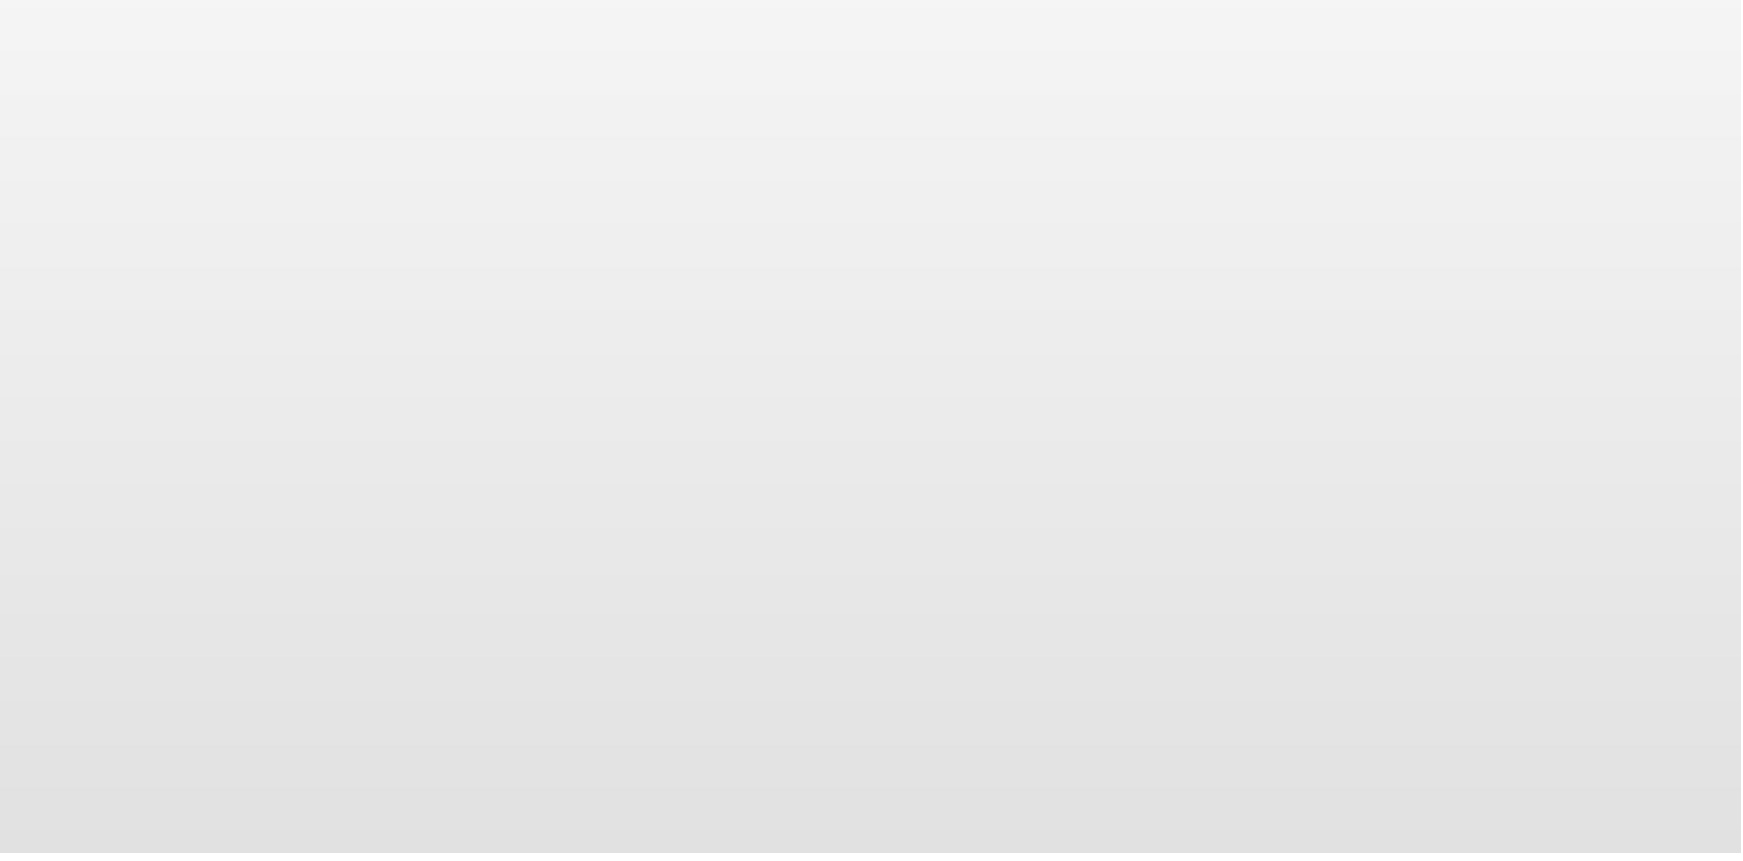
[picture p69: page 1]
