aravinth41/AMT/AMT HALL EFFECT/04_Project Outputs/Rev 3/03_PDF/PCB 3D Print - Top.PDF

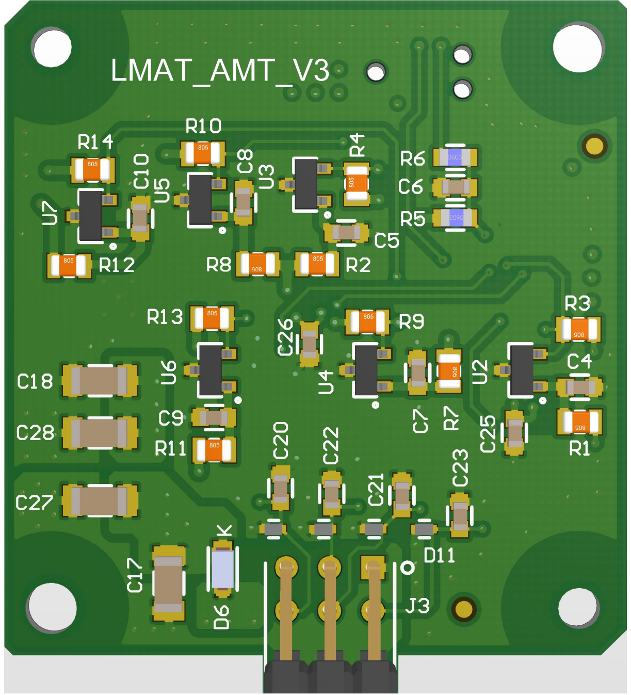
[picture p71: page 1]
