aravinth41/AMT/AMT HALL EFFECT/04_Project Outputs/Rev 3/02_ASSEMBLY/LMAT_AMT_V3.PDF

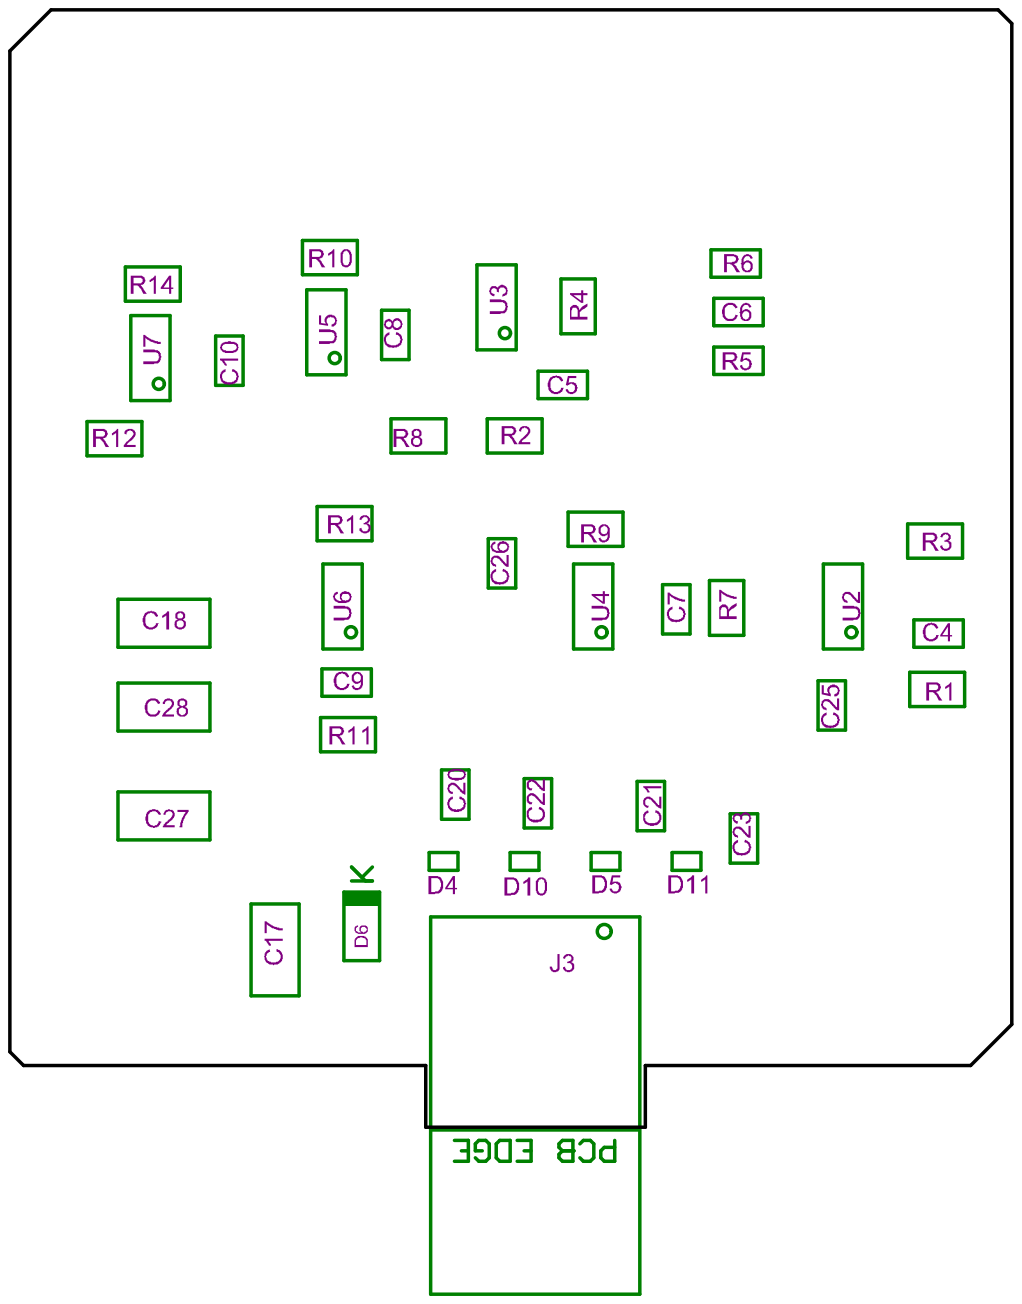
[picture p72: page 1]

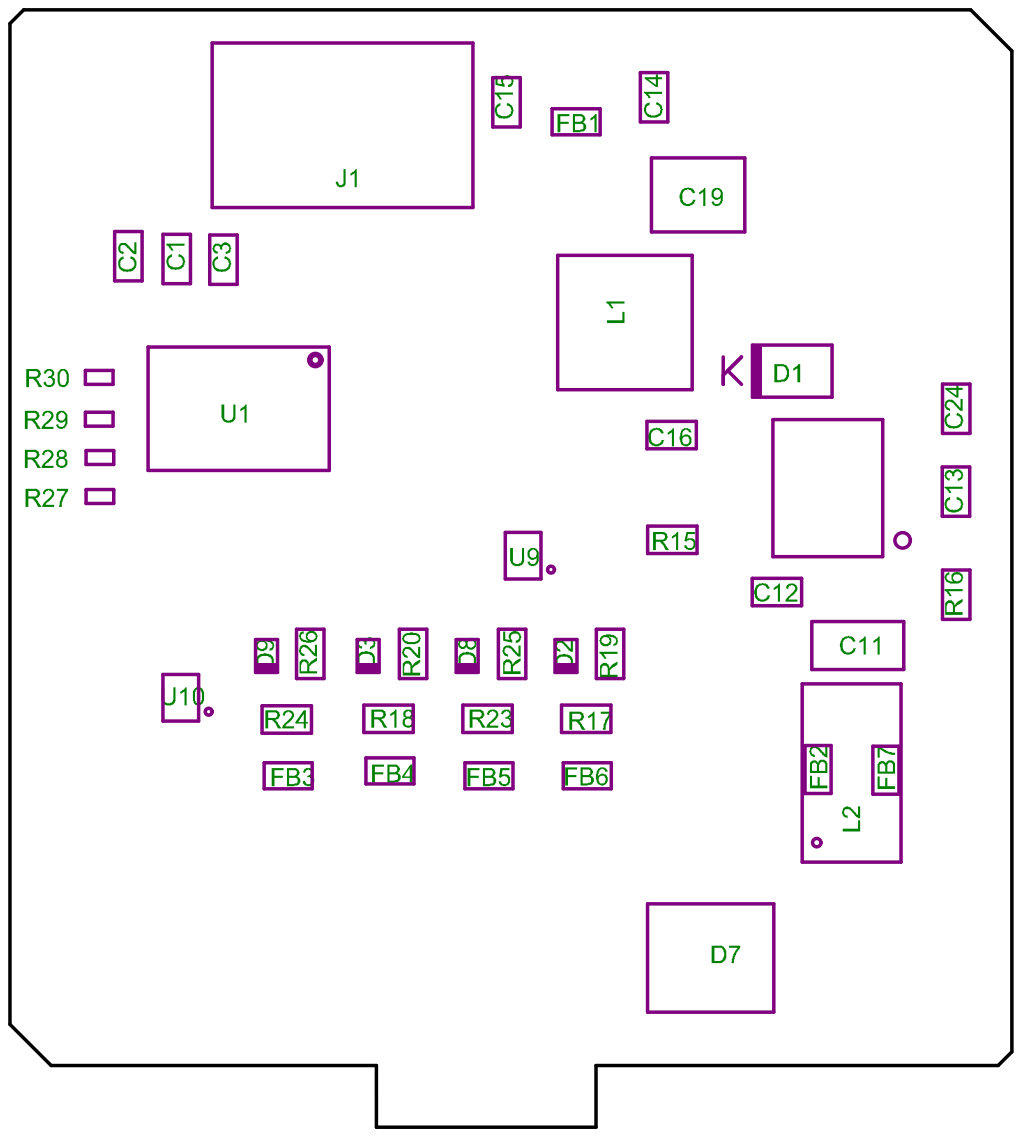
[picture p73: page 2]
