aravinth41/AMT/AMT HALL EFFECT/04_Project Outputs/Rev 2/02_ASSEMBLY/LMAT_AMT_V2.PDF

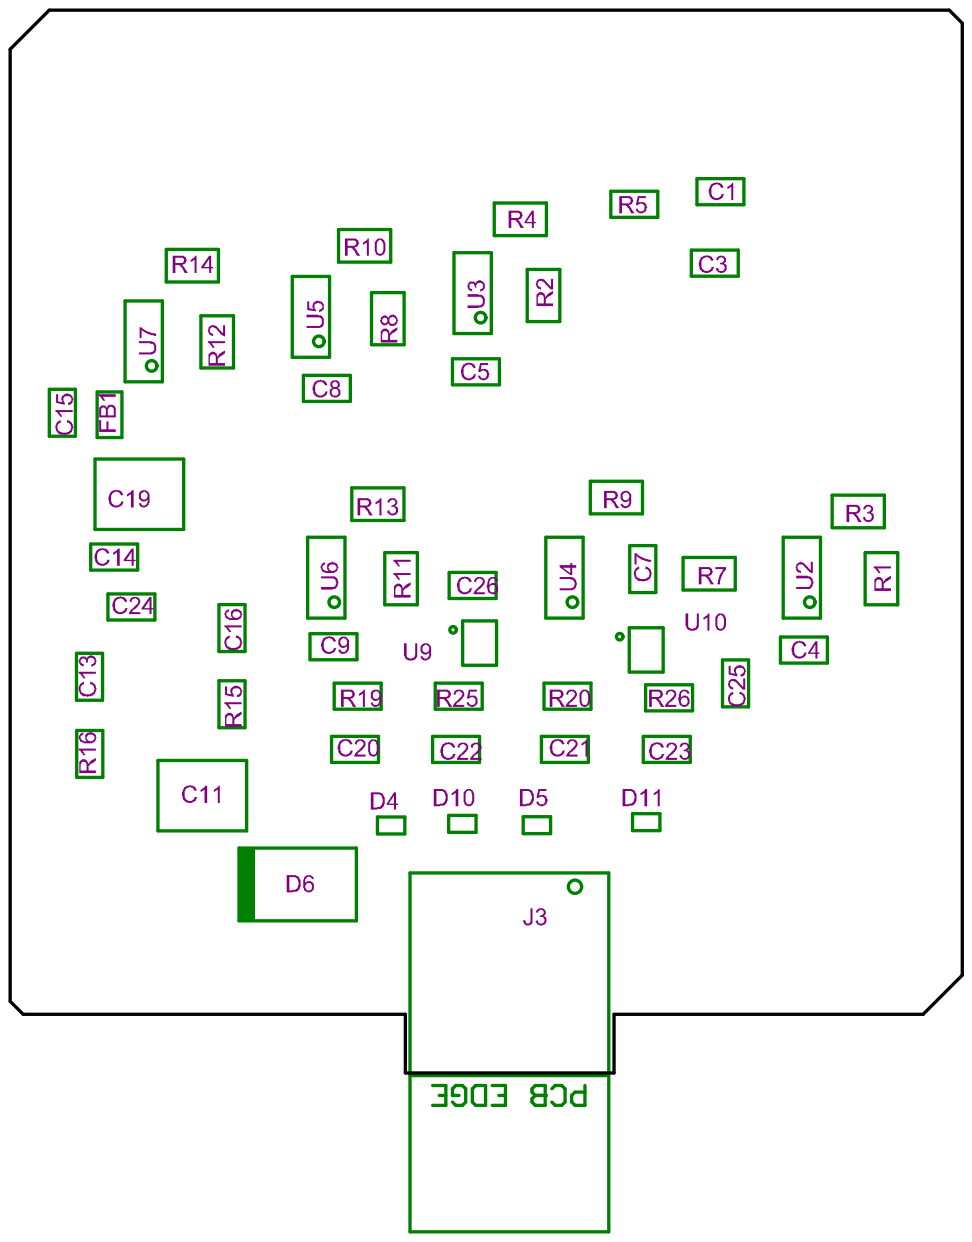
[picture p74: page 1]

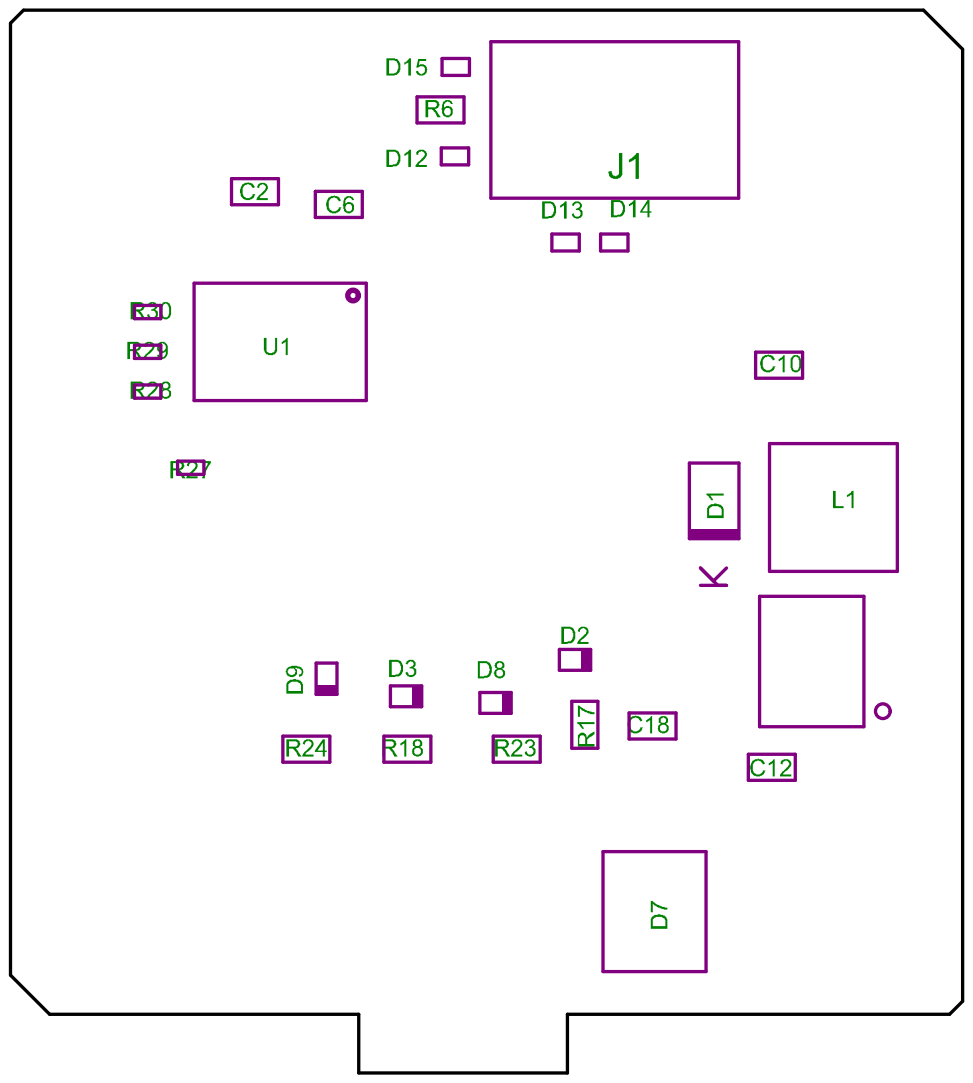
[picture p75: page 2]
