aravinth41/AMT/AMT HALL EFFECT/04_Project Outputs/Rev 2/03_PDF/PCB 3D Print - Angle.PDF

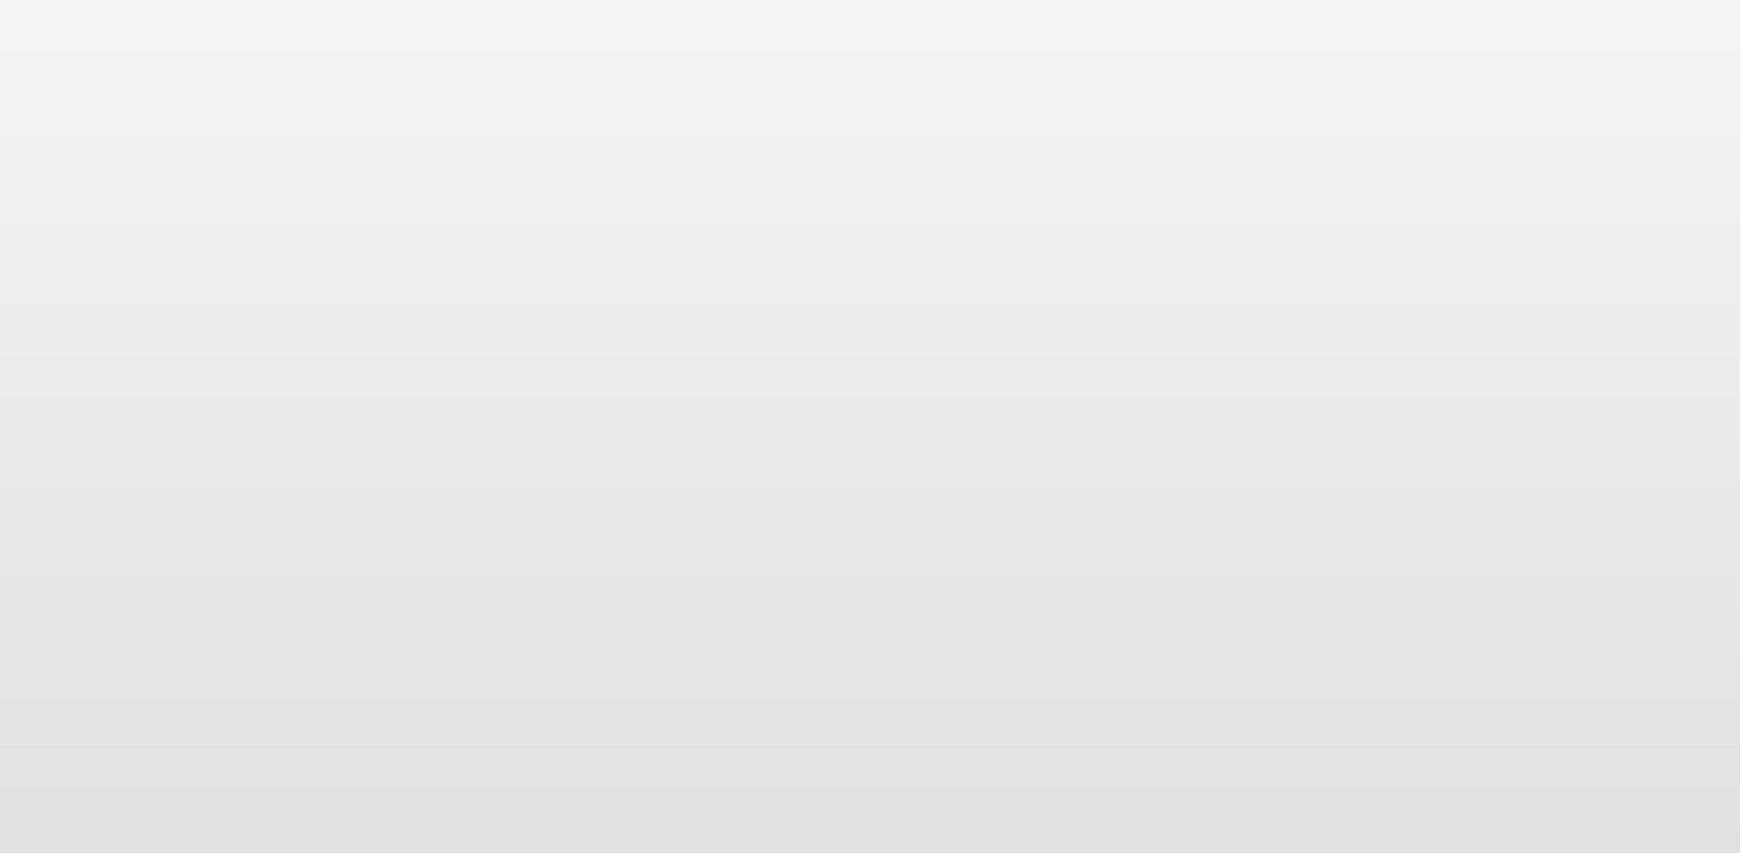
[picture p76: page 1]
