aravinth41/AMT/AMT HALL EFFECT/04_Project Outputs/Rev 2/03_PDF/PCB 3D Print - Bottom.PDF

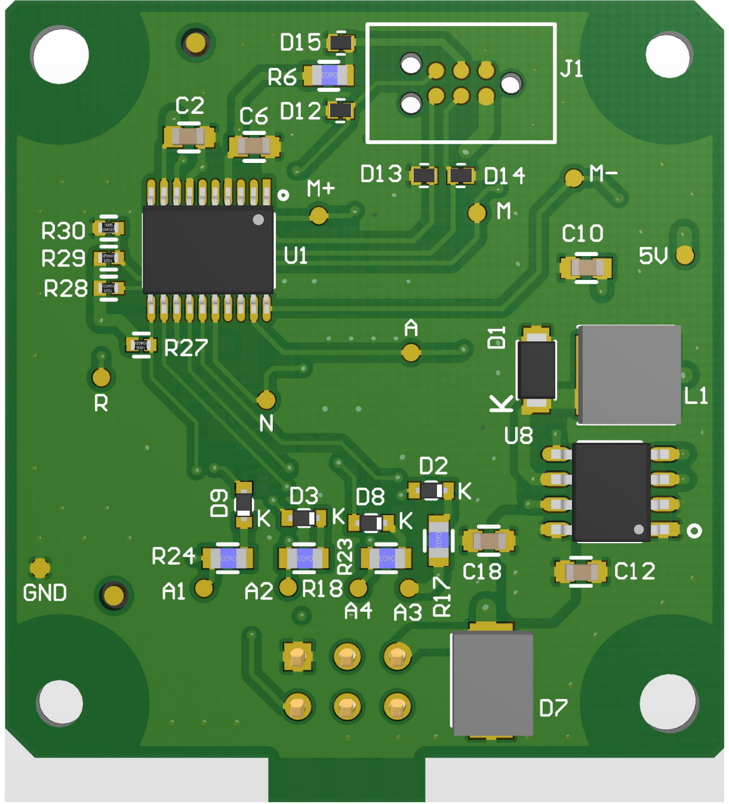
[picture p77: page 1]
