aravinth41/AMT/AMT HALL EFFECT/04_Project Outputs/Rev 2/03_PDF/PCB_PRINTS.PDF

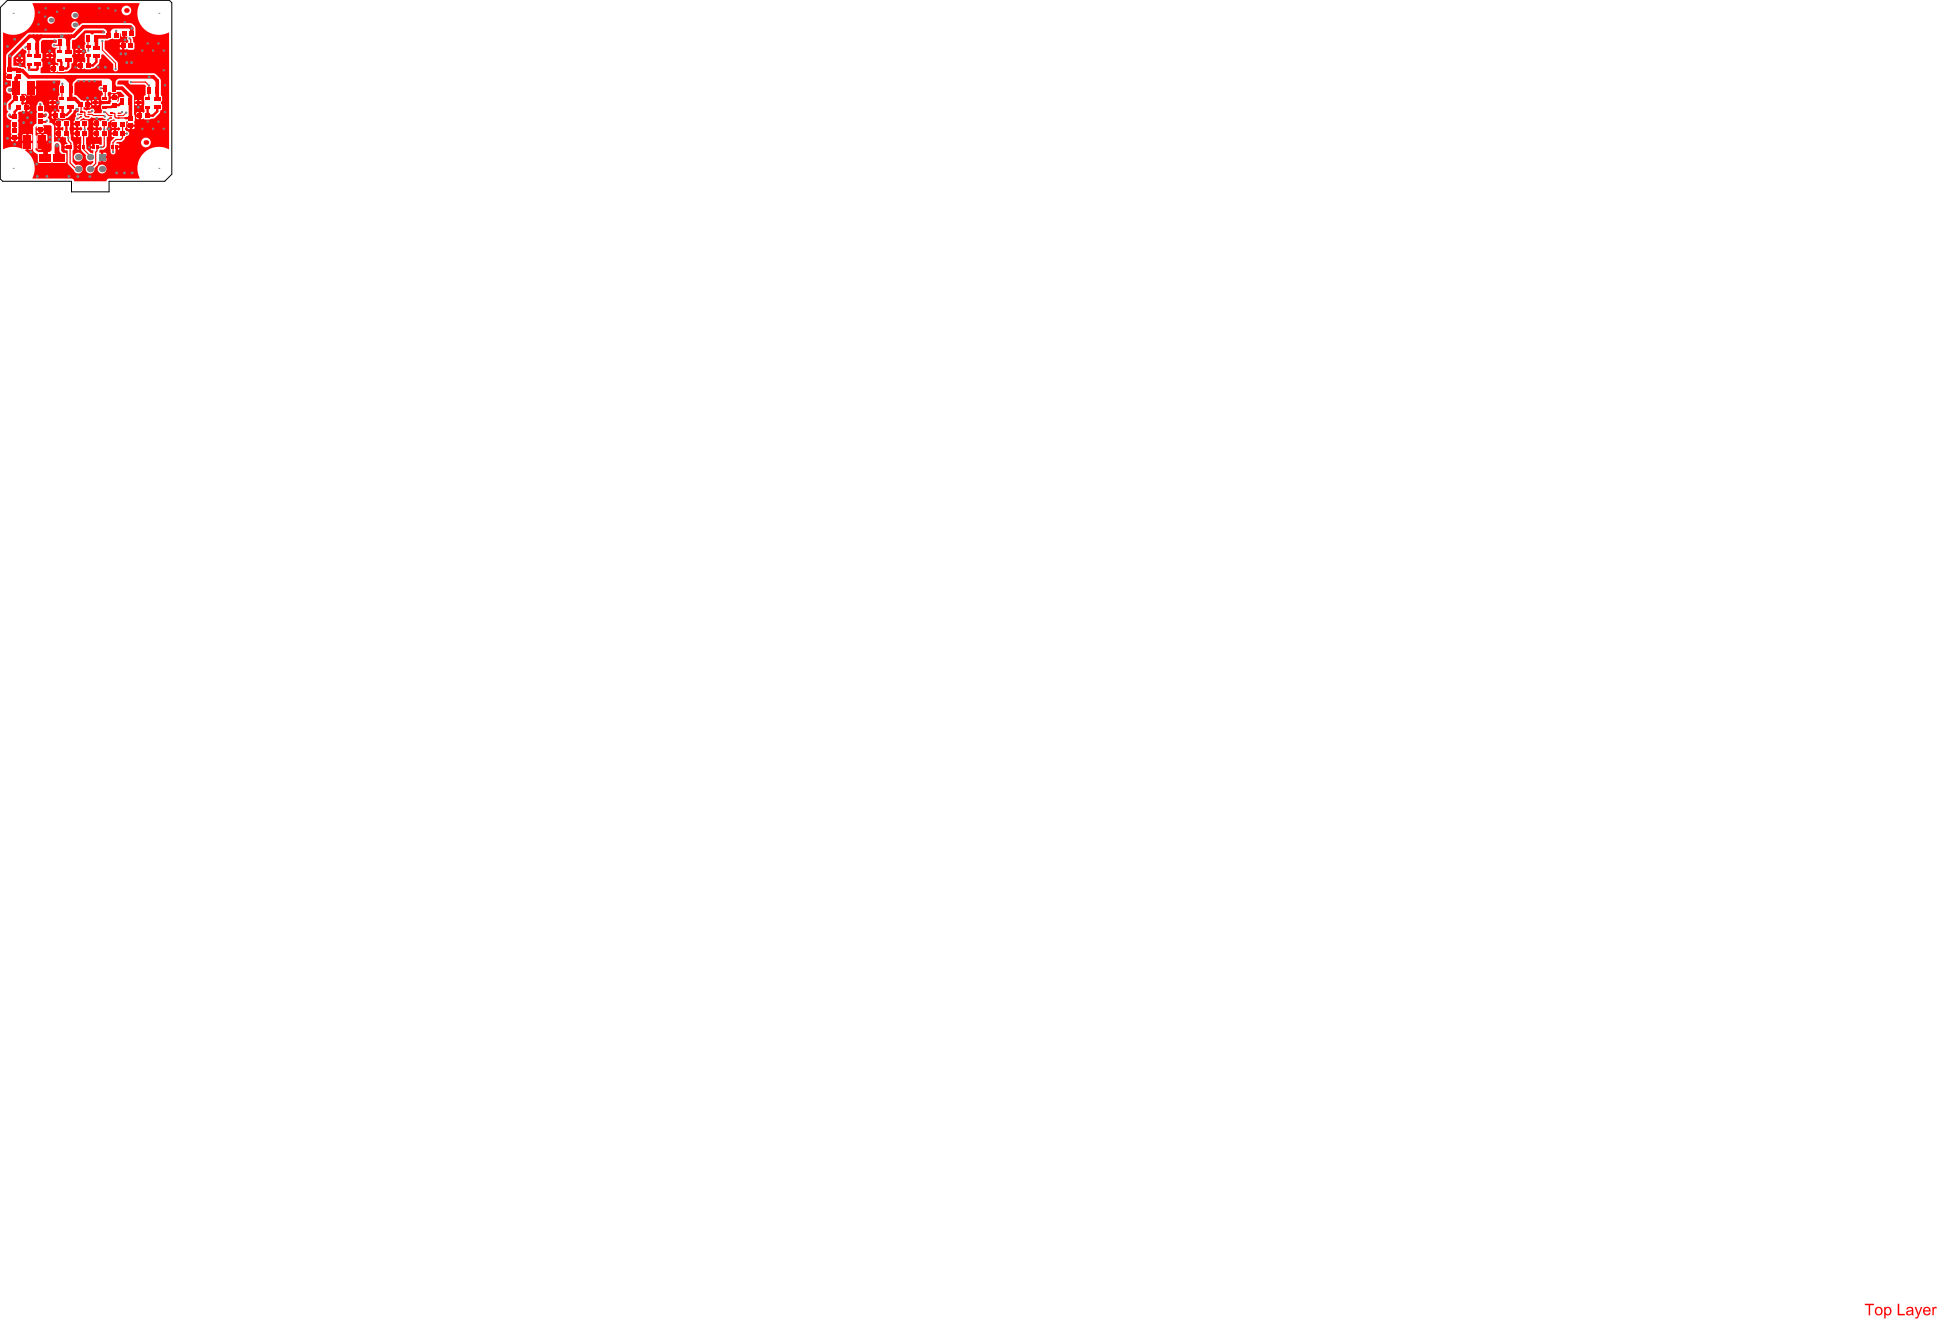
[picture p79: page 1]

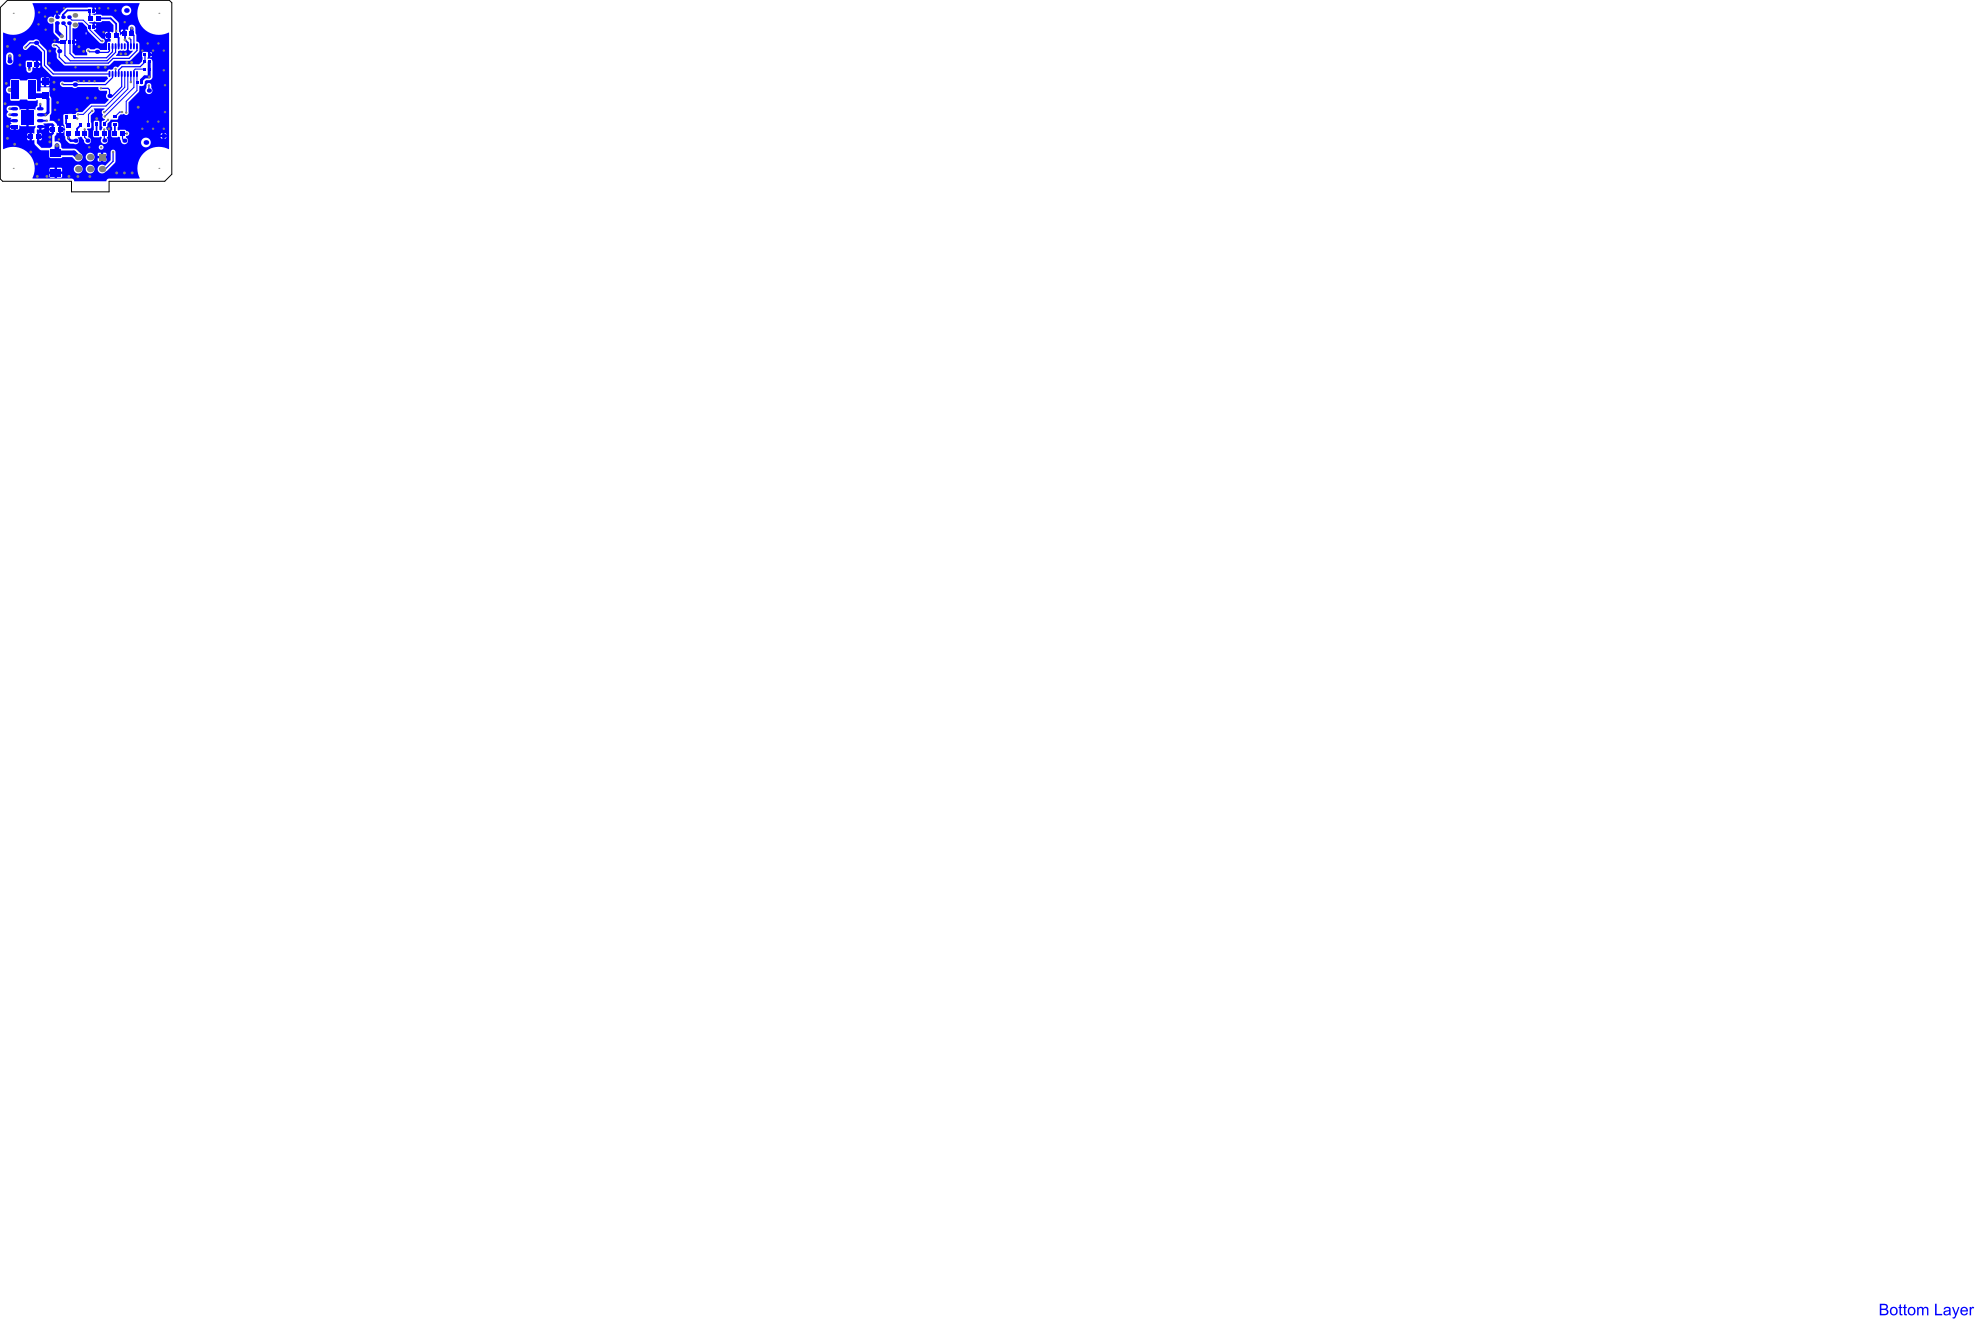
[picture p80: page 2]

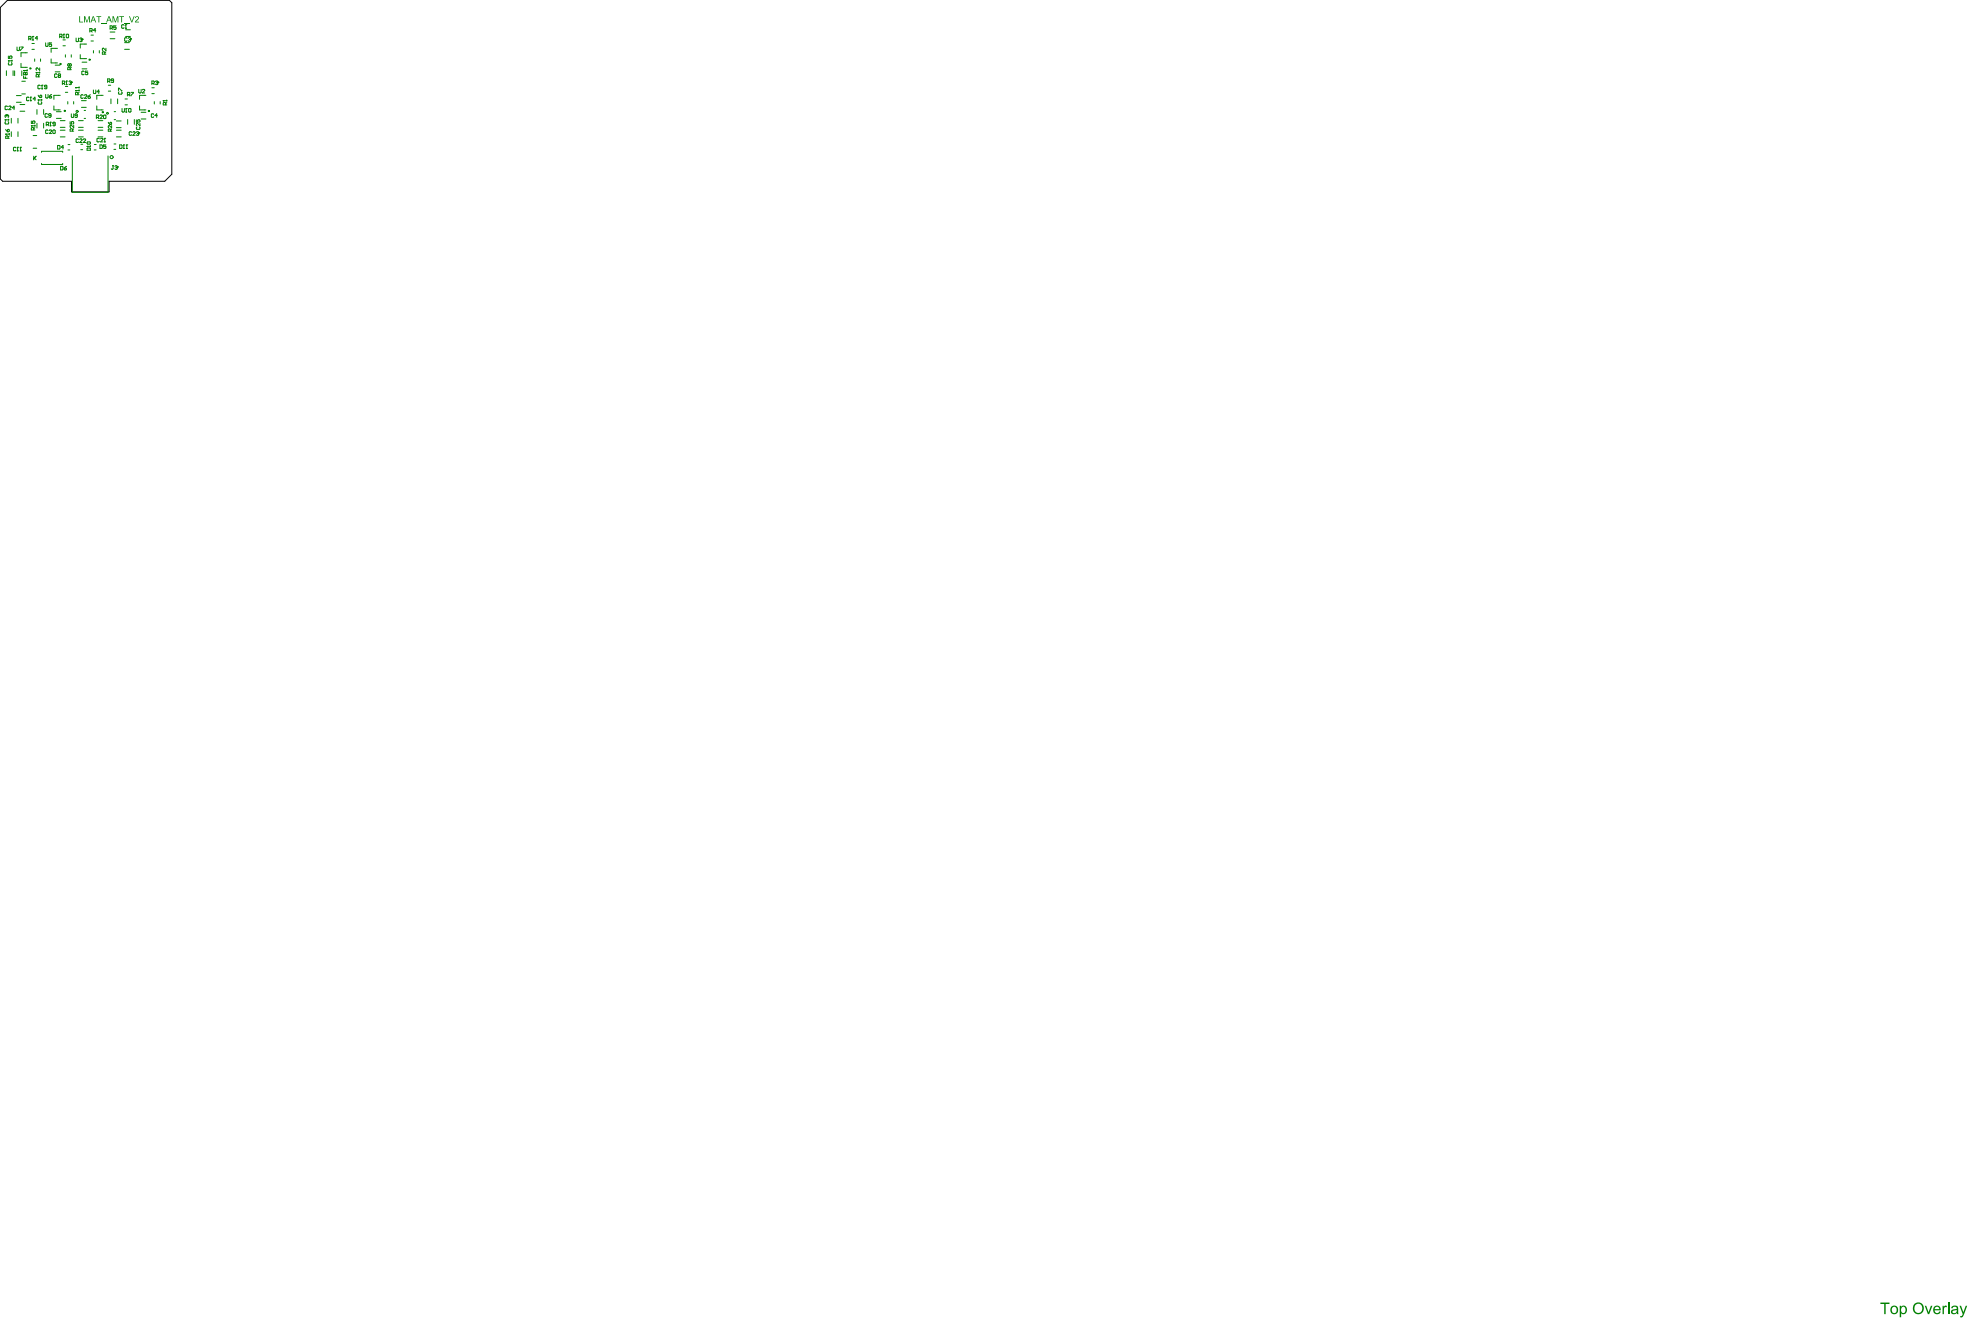
[picture p81: page 3]

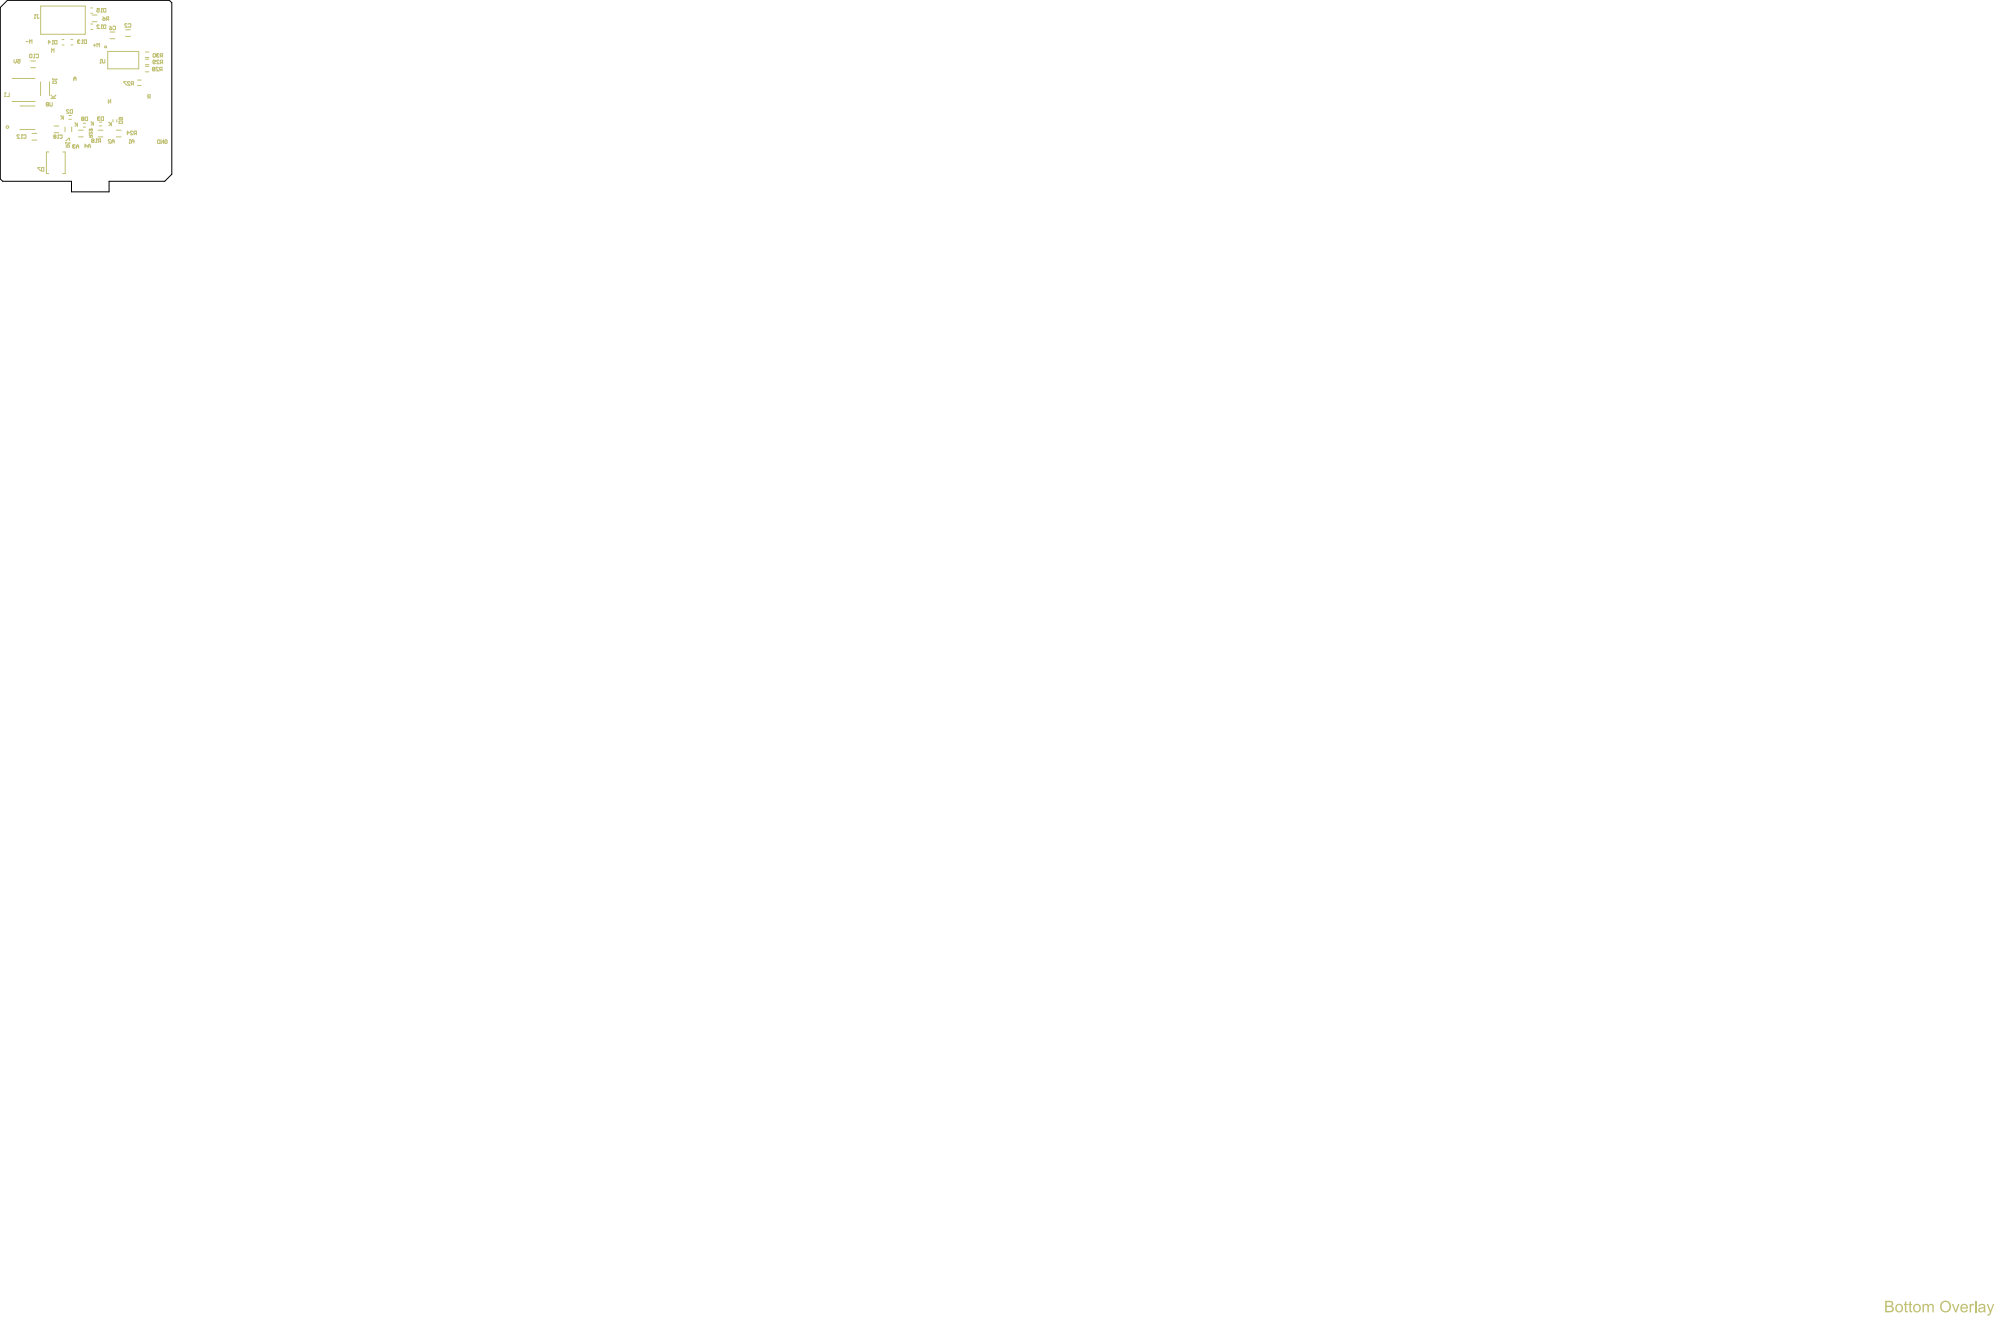
[picture p82: page 4]

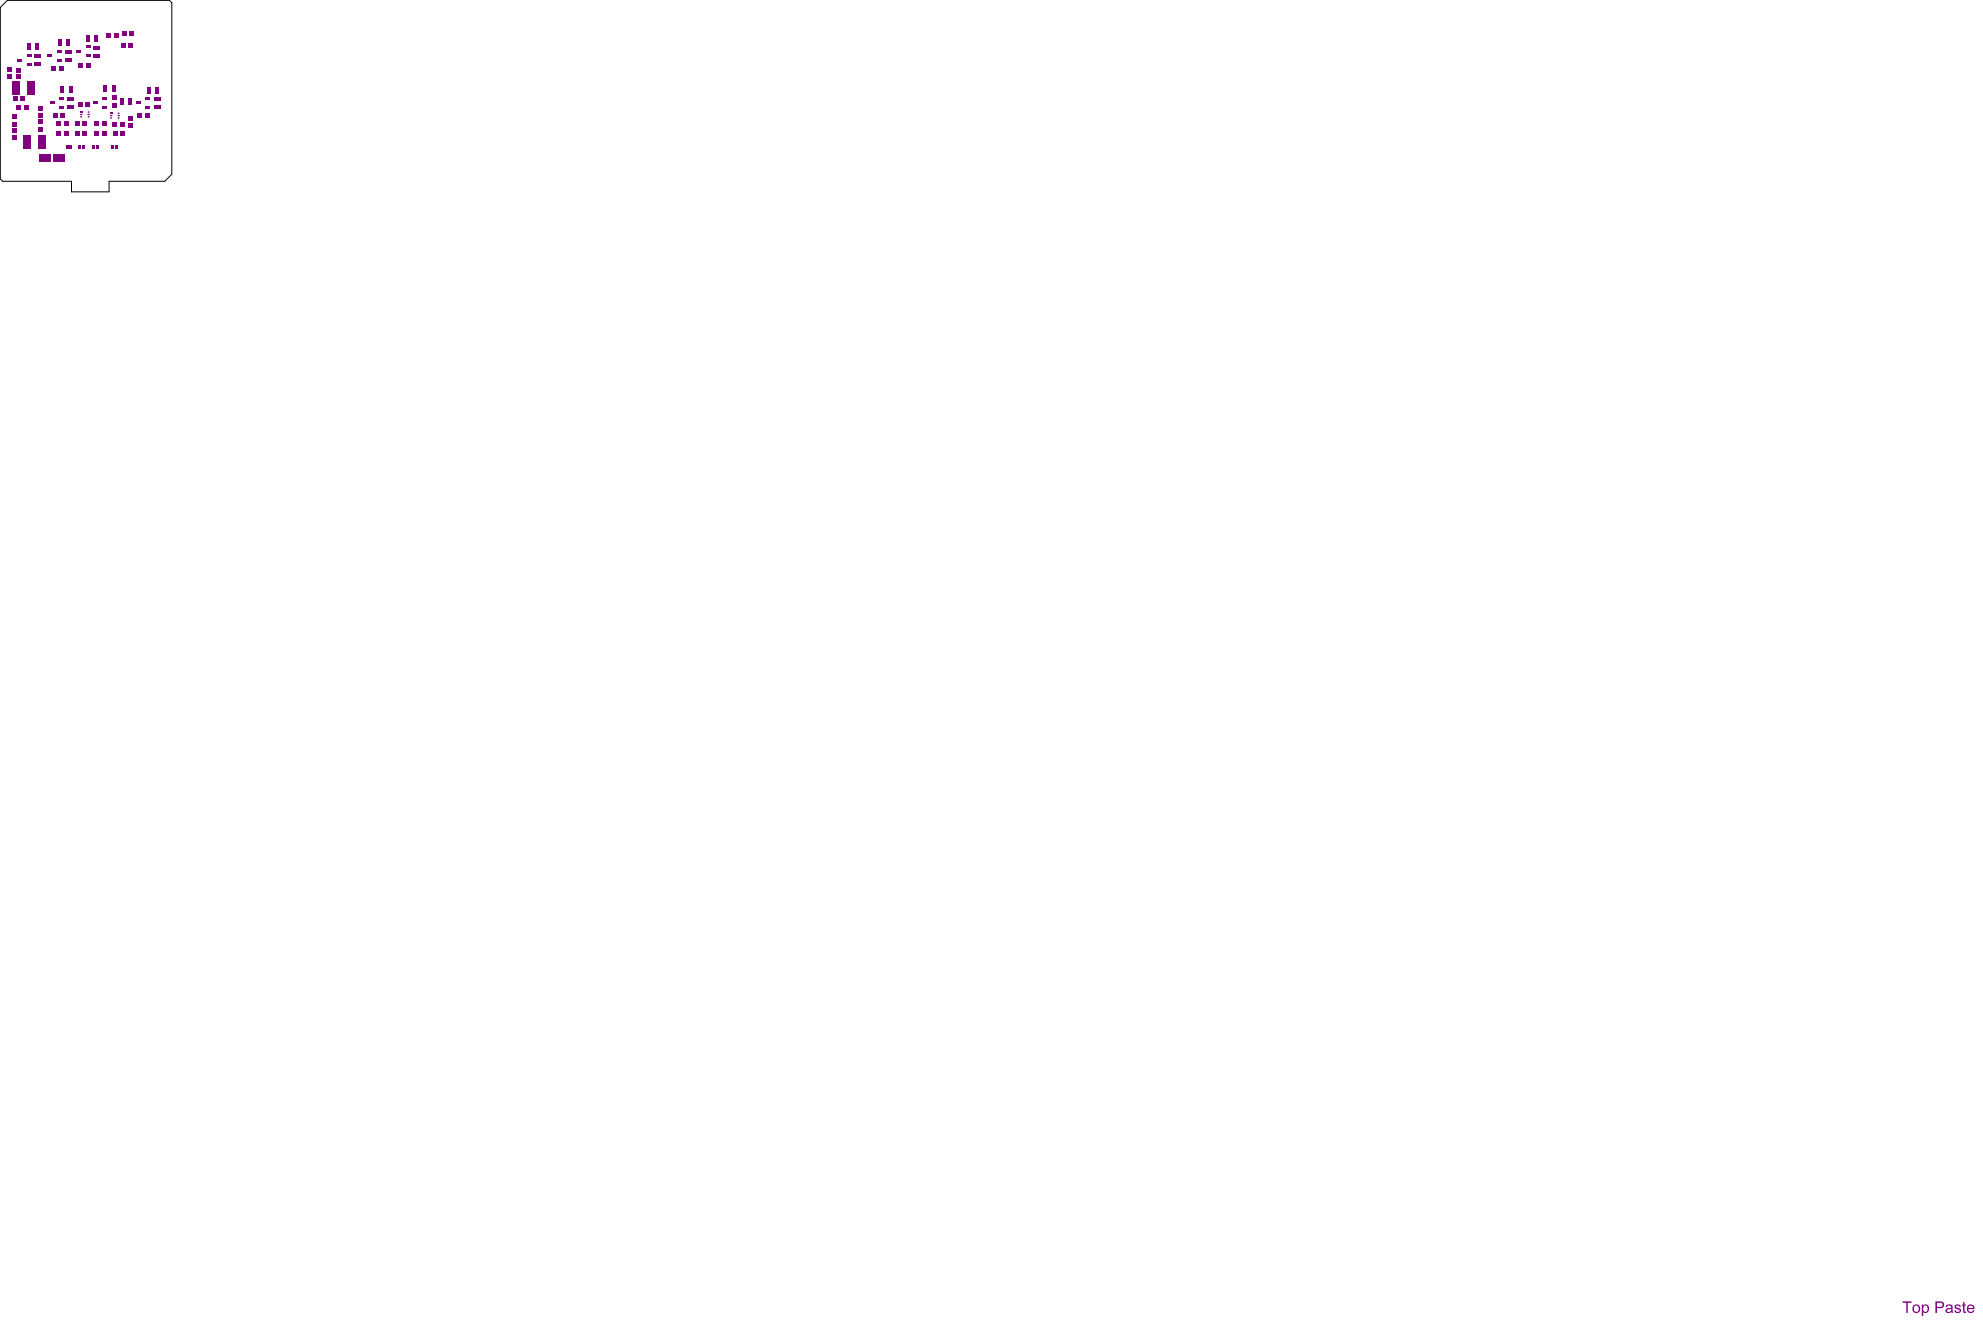
[picture p83: page 5]

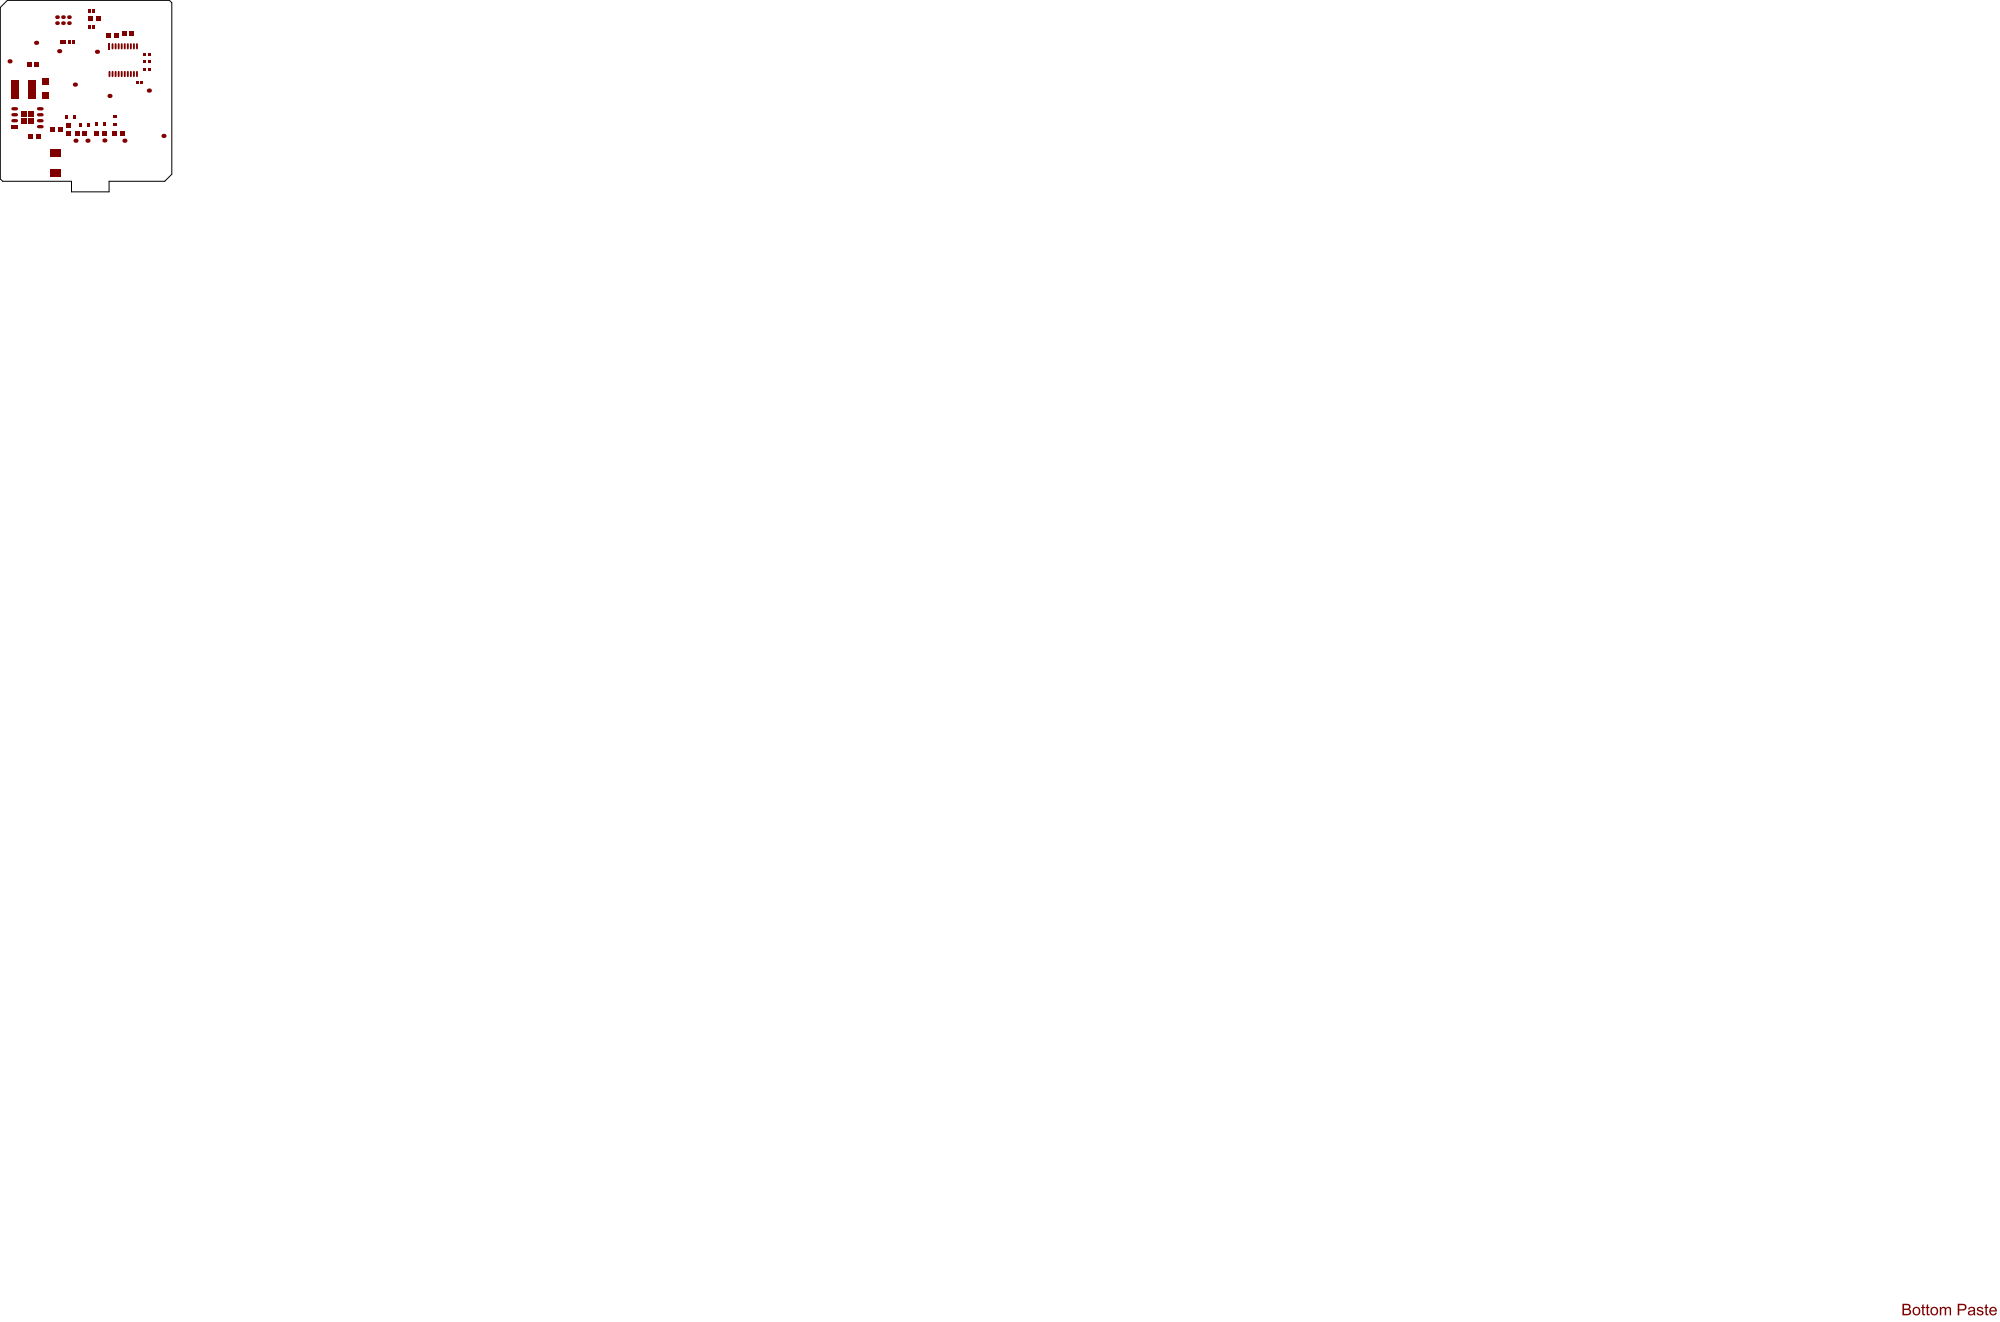
[picture p84: page 6]

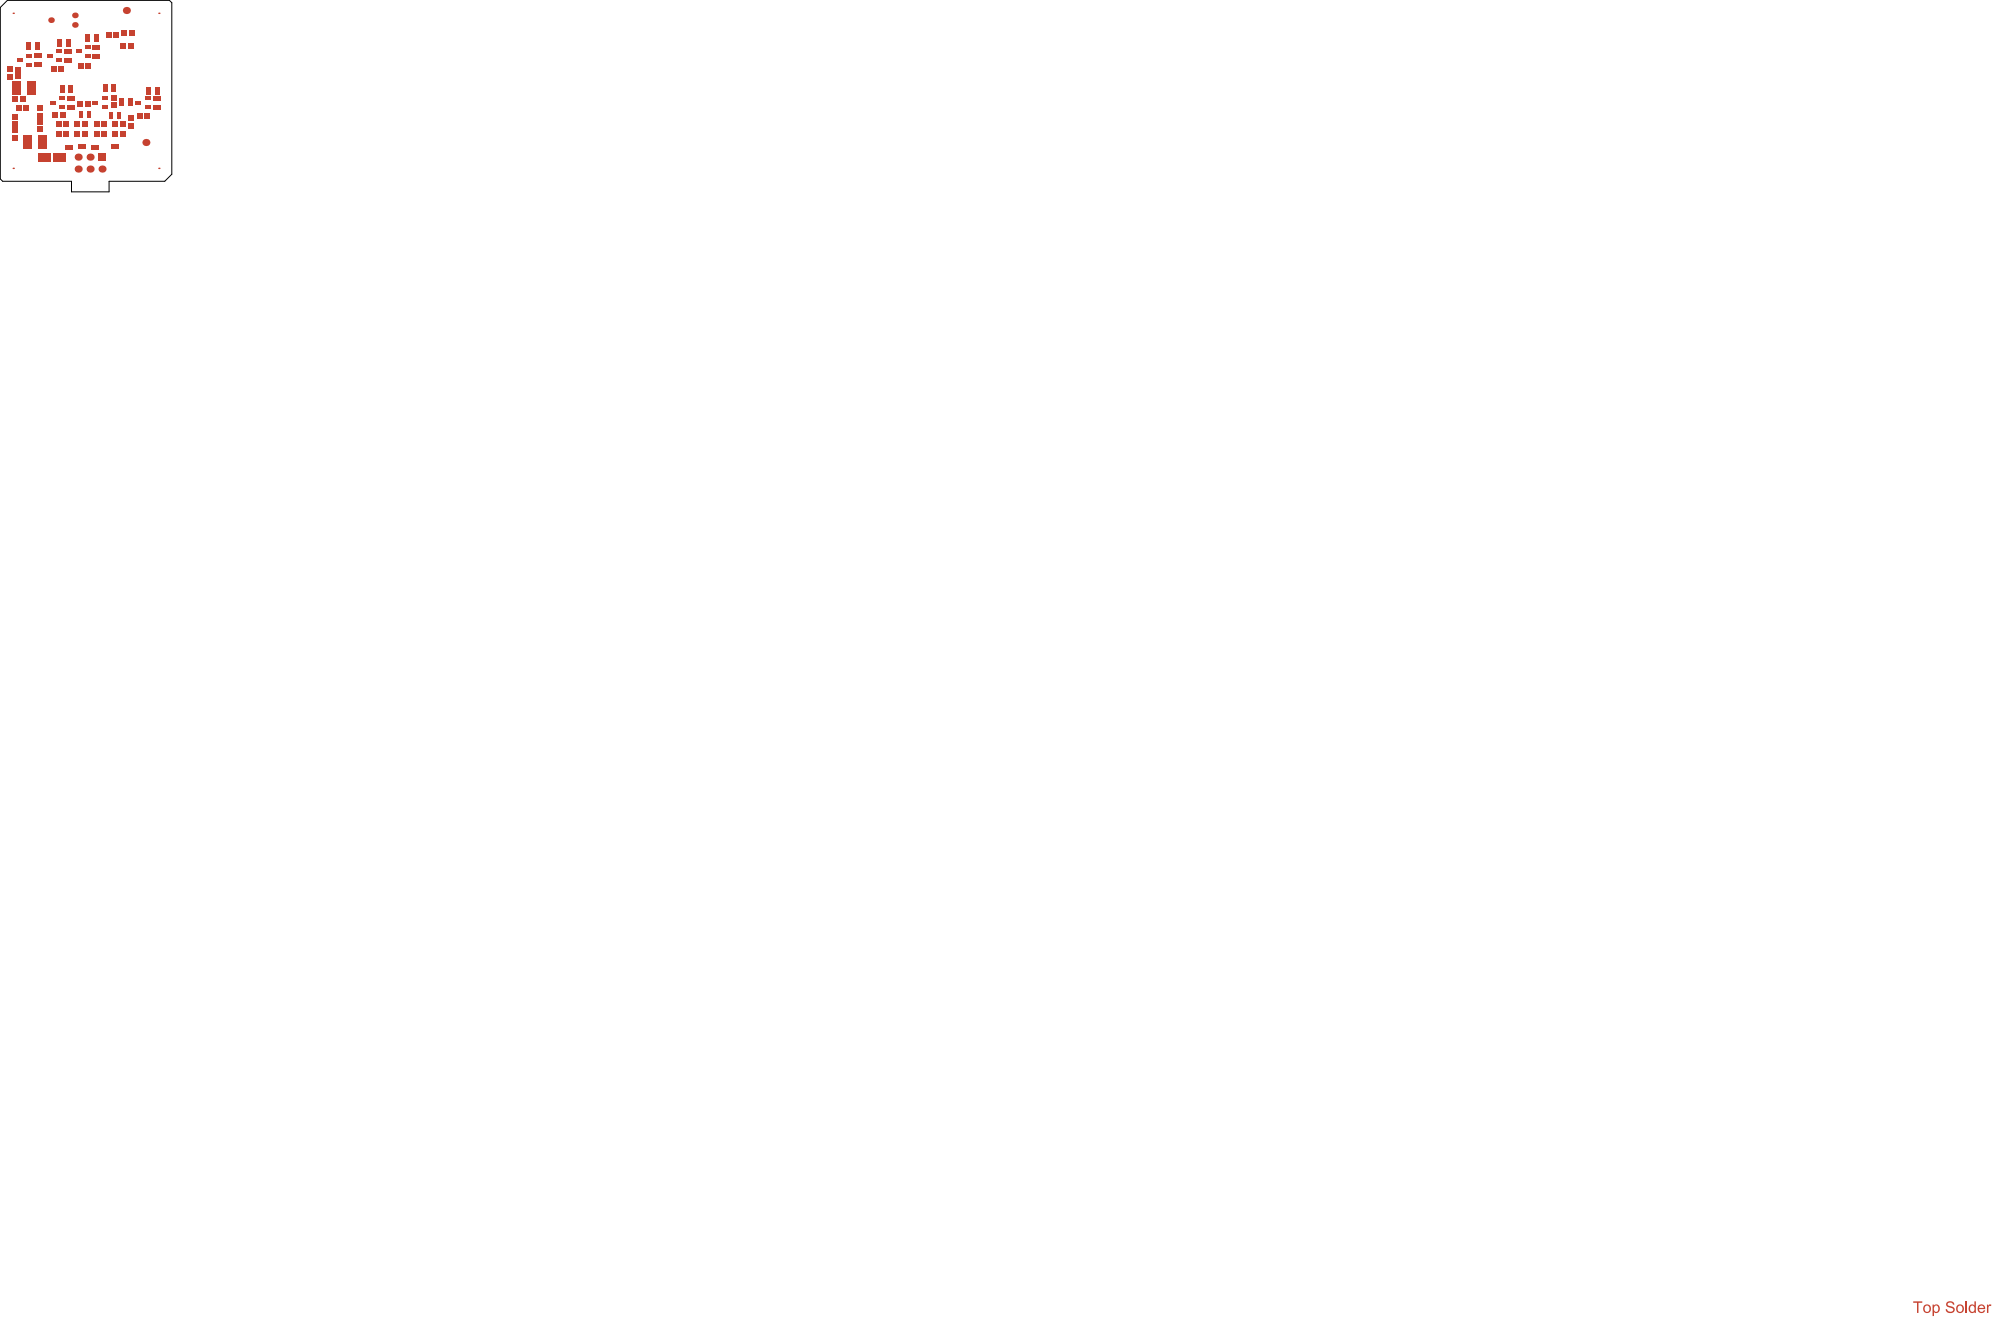
[picture p85: page 7]

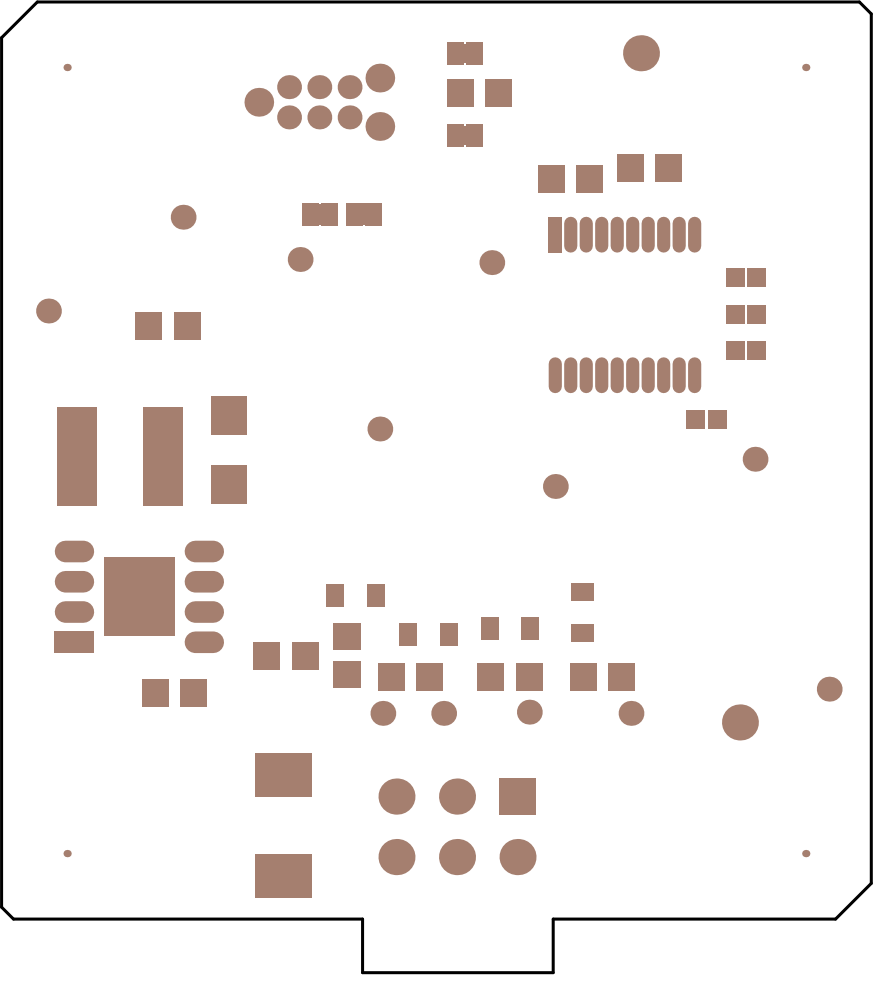
[picture p86: page 8]
