aravinth41/AMT/AMT HALL EFFECT/04_Project Outputs/Rev 3/03_PDF/FAB_DWG.PDF

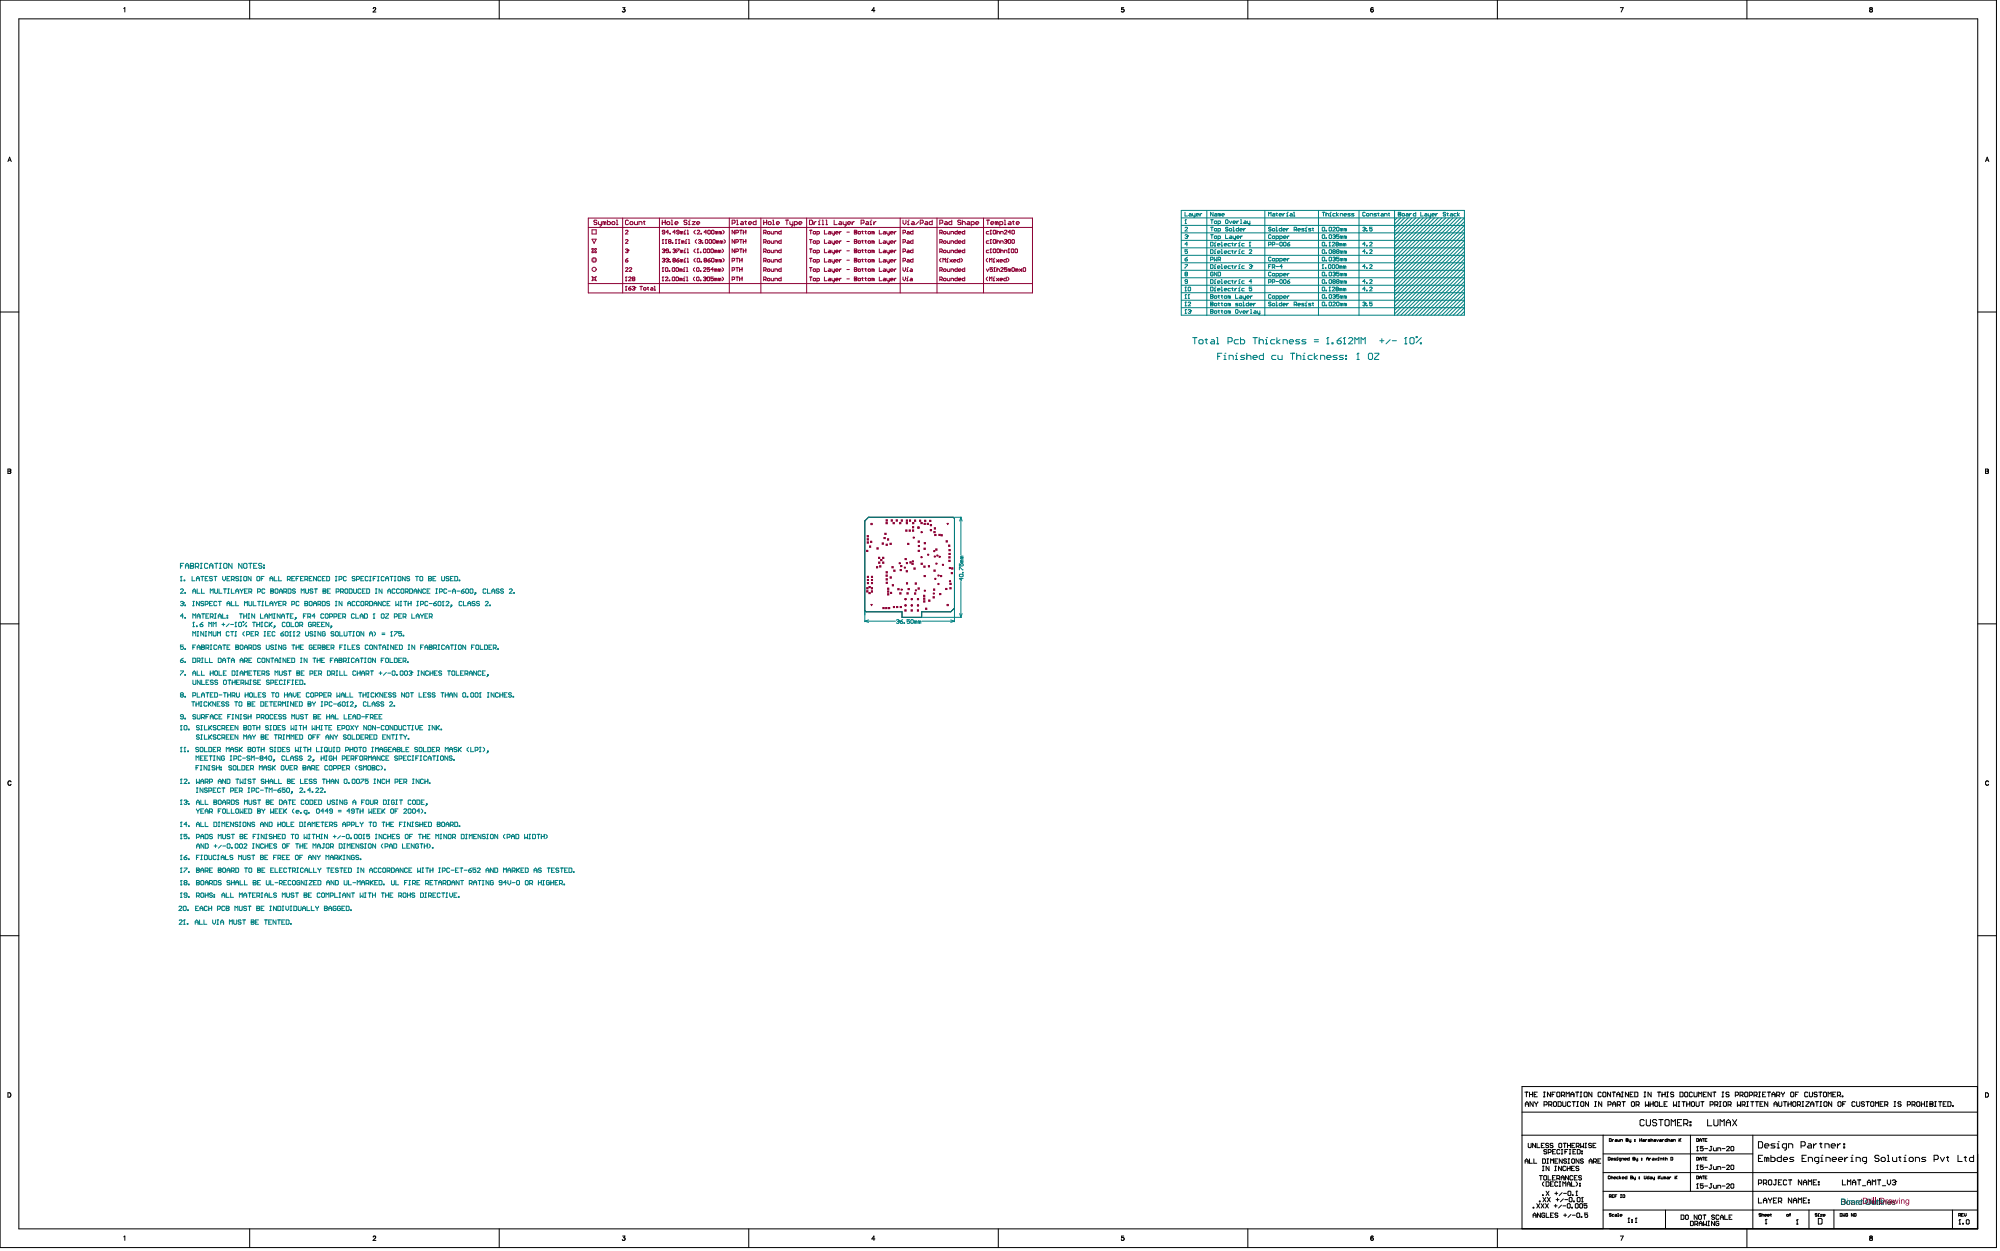
[picture p87: page 1]

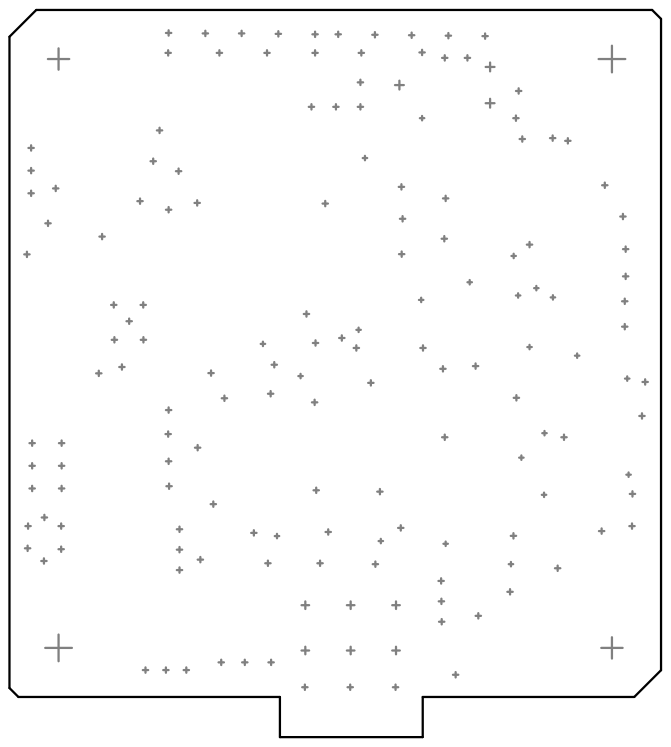
[picture p88: page 2]
