aravinth41/AMT/AMT HALL EFFECT/04_Project Outputs/Rev 2/03_PDF/FAB_DWG.PDF

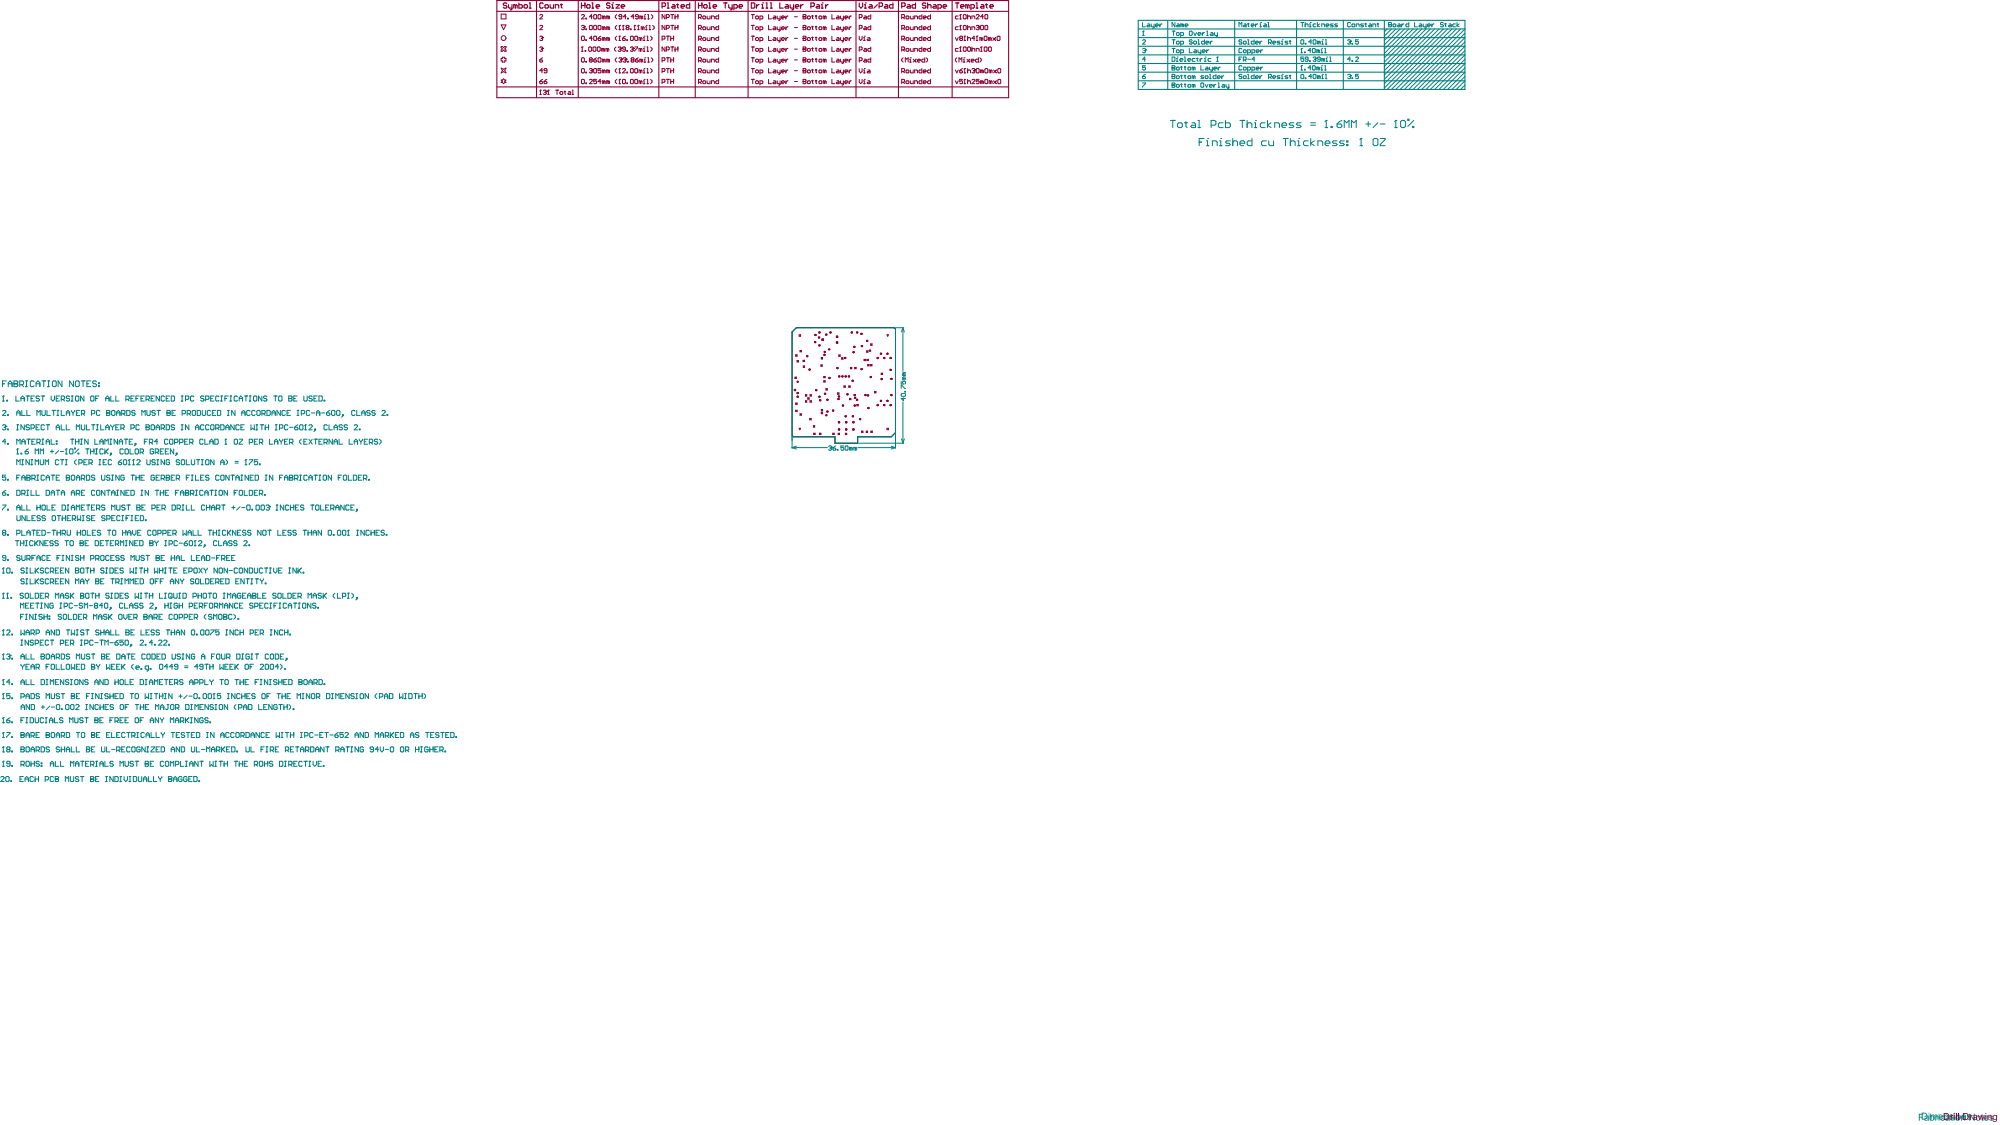
[picture p89: page 1]

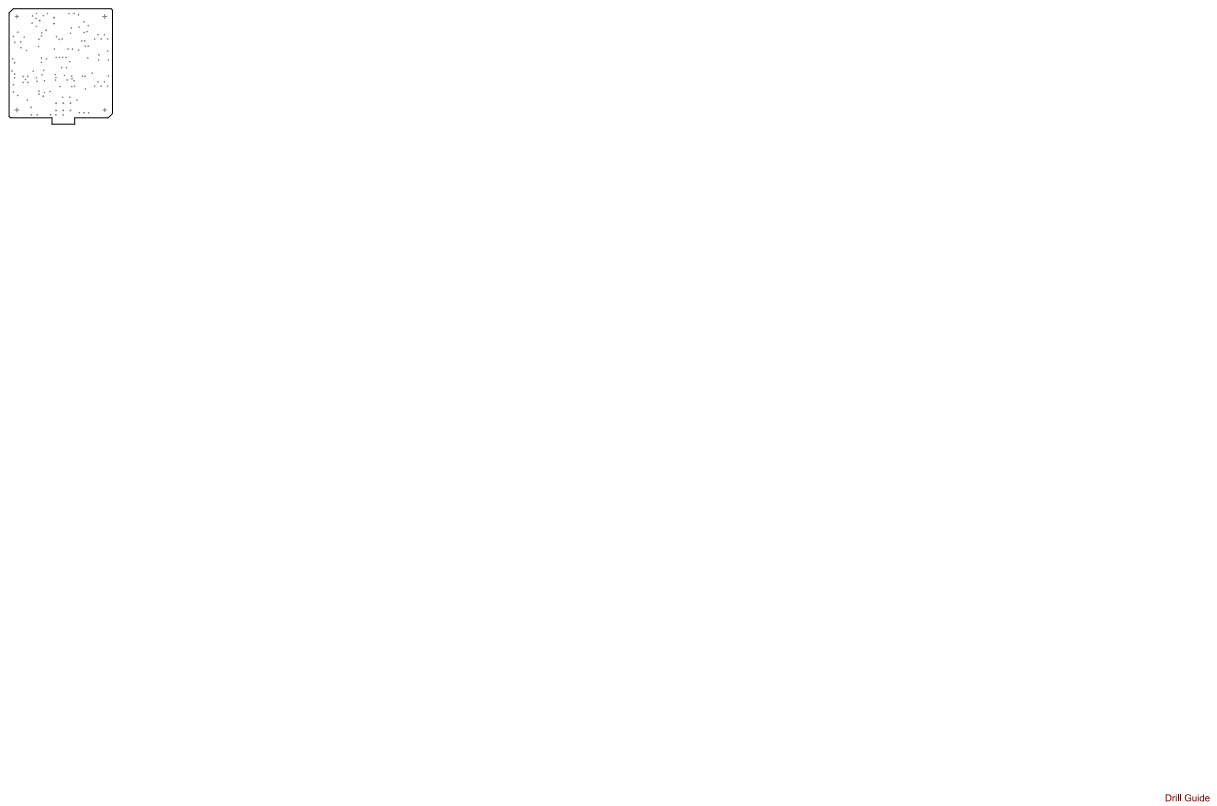
[picture p90: page 2]
