aravinth41/AMT/(list of files, drawings)

Other design files:
AMT HALL EFFECT/02_Design/Rev 1/LMAT_AMT_V1.PcbDoc
AMT HALL EFFECT/02_Design/Rev 1/LMAT_AMT_V1.PrjPcb
AMT HALL EFFECT/02_Design/Rev 1/LMAT_AMT_V1.SchDoc
AMT HALL EFFECT/02_Design/Rev 2/AMT.PcbLib
AMT HALL EFFECT/02_Design/Rev 2/LMAT_AMT_V2.PcbDoc
AMT HALL EFFECT/02_Design/Rev 2/LMAT_AMT_V2.PrjPcb
AMT HALL EFFECT/02_Design/Rev 2/LMAT_AMT_V2.SchDoc
AMT HALL EFFECT/02_Design/Rev 3/LMAT_AMT_V3.PcbDoc
AMT HALL EFFECT/02_Design/Rev 3/LMAT_AMT_V3.PrjPcb
AMT HALL EFFECT/02_Design/Rev 3/LMAT_AMT_V3.SchDoc
AMT HALL EFFECT/02_Design/Rev 4/LMAT_AMT_V4.PcbDoc
AMT HALL EFFECT/02_Design/Rev 4/LMAT_AMT_V4.PrjPcb
AMT HALL EFFECT/02_Design/Rev 4/LMAT_AMT_V4.SchDoc
AMT HALL EFFECT/02_Design/Rev 4/PcbLib_AMT.PcbLib
AMT MAGNETOMETER/01_Design/LMAT_AMT_MAG.PcbDoc
AMT MAGNETOMETER/01_Design/LMAT_AMT_MAG.PrjPcb
AMT MAGNETOMETER/01_Design/LMAT_AMT_MAG.SchDoc
AMT MAGNETOMETER/01_Design/LMAT_AMT_MAG_V1.PrjPcb
