aravinth41/AMT/(commit log)

2019-06-25 Photos of existing gear shifter
2019-06-25 DXF file and assembly drawing from Shailendra
    [AMT_PCB_25 JUNE 2019.dxf]
2019-06-26 Latest design files of AMT project
    [LMAT_AMT_V2.PcbDoc, LMAT_AMT_V2.PrjPcb, LMAT_AMT_V2.SchDoc]
2019-06-26 Schematic PDF
2019-06-26 Design files of AMT_V1
    [LMAT_AMT_V1.PcbDoc, LMAT_AMT_V1.PrjPcb, LMAT_AMT_V1.SchDoc]
2019-06-26 Gerber files of AMT_V1
    [AMT_HALL_EFFECT.step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]
2019-06-26 Added shared documents in mail by LUMAX and TATA
    [BOM_X451.xlsx, CDS TATA AMT Original.xlsx, PCB AMT 27 APR 2019.dxf]
2019-06-27 Updated PCB
    [LMAT_AMT_V2.PcbDoc]
2019-06-28 Latest design files of AMT project.
    [AMT.SchLib, LMAT_AMT_V2.PcbDoc, LMAT_AMT_V2.PrjPcb, LMAT_AMT_V2.SchDoc]
2019-07-09 Latest design files of AMT
    [AMT.PcbLib, AMT.SchLib, LMAT_AMT_V2.PcbDoc, LMAT_AMT_V2.PrjPcb, LMAT_AMT_V2.SchDoc]
2019-07-09 Latest Design
    [LMAT_AMT_V2.PcbDoc, LMAT_AMT_V2.SchDoc]
2019-07-12 Latest PCB and Step File
    [LMAT_AMT_V2.PcbDoc]
2019-07-12 Latest step file and schematic PDF of AMT
2019-07-19 Schematic PDF of AMT Magnetometer
2019-07-22 Latest Board and Gerber files
    [LMAT_AMT_V2.PcbDoc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]
2019-07-22 Latest Assembly gerber
    [Pick Place for LMAT_AMT_V2.csv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]
2019-07-22 Gerber files of AMT_V2
    [LMAT_AMT_V2.DRL, LMAT_AMT_V2.GBL, LMAT_AMT_V2.GBO, LMAT_AMT_V2.GBS, LMAT_AMT_V2.GTL, LMAT_AMT_V2.GTO, LMAT_AMT_V2.GTS]
2019-07-22 Latest assembly files of AMT
    [Pick Place for LMAT_AMT_V2.csv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]
2019-07-23 Latest PCB
    [LMAT_AMT_V2.PcbDoc]
2019-07-24 Latest design and gerber files of AMT
    [AMT.PcbLib, AMT.SchLib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]
2019-07-24 Latest BOM of AMT project.
    [LMAT_AMT_V2.xlsx]
2019-07-26 Latest PCB
    Changed Programming connector.
    [LMAT_AMT_V2.PcbDoc, LMAT_AMT_V2.SchDoc]
2019-07-26 Latest gerber files of AMT project.
    [LMAT_AMT_V2.DRL, LMAT_AMT_V2.GBL, LMAT_AMT_V2.GBO, LMAT_AMT_V2.GBP, LMAT_AMT_V2.GBS, LMAT_AMT_V2.GTL, LMAT_AMT_V2.GTO, LMAT_AMT_V2.GTP]
2019-07-26 Latest BOM, schematic PDF and PPT of AMT project.
    [LMAT_AMT_V2.xlsx]
2019-07-30 PCB Checklist updated
    [Embdes_PCB_CHECKLIST_REV2_AMT.xlsx]
2019-07-31 Stock update of AMT project.
    [LMAT_AMT_V2_Stock.xlsx]
2019-08-07 Test report of AMT_V2
    [AMT_TEST_REPORT_V2.xlsx]
2019-08-31 BOM OF VTS_V2 PROJECT
    [LMAT_AMT_V2.xlsx]
2019-09-05 Latest test report of AMT boards
    [AMT_TEST_REPORT_V2_05_Sept.xlsx]
2019-09-26 Latest FMEA documents of AMT
    [BOUNDARY_DIAGRAM_AMT.xlsx, IFRL_AMT.xlsx, PST _AMT.xlsx, Parameter_Diagram_AMT.xlsx]
2019-09-27 Latest parameter diagram of AMT
    [PARAMETER DIAGRAM_AMT.xls, Parameter_Diagram_AMT.xlsx]
2019-09-27 Latest boundary diagram
    [BOUNDARY_DIAGRAM_AMT.xlsx]
2019-09-27 Latest block diagram of AMT
    [Block Diagram_AMT.xlsx]
2019-09-27 Updated parameter diagram of AMT
    [PARAMETER DIAGRAM_AMT.xls]
2019-10-01 Upated boundary diagram
    [BOUNDARY_DIAGRAM_AMT.xlsx]
2019-10-09 Latest DFMEA of AMT project.
    [BOUNDARY_DIAGRAM_AMT.xlsx, IFRL_AMT.xlsx, PARAMETER DIAGRAM_AMT.xls]
2019-10-10 Latest DFMEA files of AMT project.
    [BOUNDARY_DIAGRAM_AMT.xlsx, IFRL_AMT.xlsx, PARAMETER DIAGRAM_AMT.xls]
2019-12-09 Latest design files of AMT_Magentometer
    [AMT.SchLib, AMT_MAG.PcbLib, AMT_MAG.SchLib, LMAT_AMT_MAG.PcbDoc, LMAT_AMT_MAG.PrjPcb, LMAT_AMT_MAG.SchDoc, LMAT_AMT_MAG_V1.PcbDoc, LMAT_AMT_MAG__V1.SchDoc]
2019-12-09 Latest design files of AMT_MAG
    [LMAT_AMT_MAG.PcbDoc, LMAT_AMT_MAG.PrjPcb, LMAT_AMT_MAG.SchDoc]
2019-12-10 Latest design package of AMT_MAG
    [AMT_MAG.PcbLib, AMT_MAG.SchLib, LMAT_AMT_MAG.PcbDoc, LMAT_AMT_MAG.PrjPcb, LMAT_AMT_MAG.SchDoc]
2019-12-11 Latest Design files
    [LMAT_AMT_MAG.PcbDoc, LMAT_AMT_MAG.PrjPcb, LMAT_AMT_MAG.SchDoc]
2019-12-13 Latest Design files
    Final PCB file
    [AMT_MAG.PcbLib, LMAT_AMT_MAG.PcbDoc, LMAT_AMT_MAG.PrjPcb, LMAT_AMT_MAG.SchDoc]
2019-12-20 Latest design package of AMT
    [AMT_MAG.PcbLib, AMT_MAG.SchLib, LMAT_AMT_MAG.PcbDoc, LMAT_AMT_MAG.PrjPcb, LMAT_AMT_MAG.SchDoc]
2020-02-26 Latest Rev 3 package
    [AMT.SchLib, LMAT_AMT_V3.PcbDoc, LMAT_AMT_V3.PrjPcb, LMAT_AMT_V3.SchDoc]
2020-02-29 Latest desgn files
    [LMAT_AMT_V3.PrjPcb]
2020-05-21 Design files of AMT
    1. Added common mode choke to the circuit.
    2. Added ferrite bead to the signal lines.
    [AMT.PcbLib, AMT.SchLib, LMAT_AMT_V3.PrjPcb, LMAT_AMT_V3.SchDoc]
2020-05-25 Latest file of AMT
    1. Added ferrite bead to the signal lines.
    [AMT.SchLib, LMAT_AMT_V3.PrjPcb, LMAT_AMT_V3.SchDoc]
2020-05-26 Latest design files of AMT
    1. updated symbols from ML.
    [AMT.PcbLib, AMT.SchLib, LMAT_AMT_V3.PrjPcb, LMAT_AMT_V3.SchDoc]
2020-05-31 Latest design file of AMT
    1. Removed ESD diodes at the programming connector side.
    2. Swapped UART_TX and UART_RX at the programming connector side.
    3. Swapped SWIM and RST at the programming connector side.
    [AMT.SchLib, LMAT_AMT_V3.PrjPcb, LMAT_AMT_V3.SchDoc]
2020-06-02 Latest PCB file of AMT
    1. 100% routing completed.
    [LMAT_AMT_V3.PcbDoc, LMAT_AMT_V3.PrjPcb]
2020-06-05 Latest design file of AMT
    [LMAT_AMT_V3.PcbDoc, LMAT_AMT_V3.PrjPcb, LMAT_AMT_V3.SchDoc]
2020-06-06 Latest design file of AMT.
    1. Updated DGND in connector
    [LMAT_AMT_V3.PcbDoc, LMAT_AMT_V3.PrjPcb, LMAT_AMT_V3.SchDoc]
2020-06-06 Latest design file of AMT
    1.Updated symbols from ML.
    [AMT.SchLib, LMAT_AMT_V3.PcbDoc, LMAT_AMT_V3.PrjPcb, LMAT_AMT_V3.SchDoc]
2020-06-09 Updated variants of AMT
    [LMAT_AMT_V3.PrjPcb, LMAT_AMT_V3.SchDoc]
2020-06-10 Latest design file of AMT project
    [LMAT_AMT_V3.PcbDoc, LMAT_AMT_V3.PrjPcb]
2020-06-11 Updated PCB file of AMT
    1. Moved L2 to bottom layer
    [LMAT_AMT_V3.PcbDoc]
2020-06-12 Final design package of AMT project.
    [LMAT_AMT_V3.PcbDoc, LMAT_AMT_V3.PrjPcb, LMAT_AMT_V3.SchDoc]
2020-06-12 Fabrication files of AMT
    [LMAT_AMT_V3.DRL, LMAT_AMT_V3.GBL, LMAT_AMT_V3.GBO, LMAT_AMT_V3.GBS, LMAT_AMT_V3.GTL, LMAT_AMT_V3.GTO, LMAT_AMT_V3.GTS]
2020-06-15 Final Design file of AMT project.
    1. Created folder for fabrication and moved the gerber files into it.
    2. Added schematic PDF, BOM and step files
    [LMAT_AMT_V3.xlsx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]
2020-06-15 Latest design and fab files of AMT.
    [LMAT_AMT_V3.PcbDoc, LMAT_AMT_V3.PrjPcb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]
2020-06-15 Assembly files of AMT project.
    [Pick Place for LMAT_AMT_V3.csv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]
2020-07-03 Test report of AMT_V3
    [LMAT_AMT_V3_Test_Report.xlsx]
2020-07-04 Updated test report of AMT_V3
    Functionality test is added.
    [LMAT_AMT_V3_Test_Report.xlsx]
2020-07-24 Final assembly and PCB print drawing of AMT
2020-07-29 Step file, PDF and BOM of AMT project.
    Added step file and BOM for AMT project (added one time purchase components).
    [LMAT_AMT_V3.xlsx]
2021-03-12 Design files with updated footprint for U9 and U10
2021-03-24 Latest design and final deliverables of AMT project.
    [LMAT_AMT_V4.DRL, LMAT_AMT_V4.GBL, LMAT_AMT_V4.GBO, LMAT_AMT_V4.GBP, LMAT_AMT_V4.GBS, LMAT_AMT_V4.GTL, LMAT_AMT_V4.GTO, LMAT_AMT_V4.GTP]
